BrennenJohnston/custom-braille-embosser-v2/MakerWorld_Photos/Real_Photos/06_all_parts.jpg

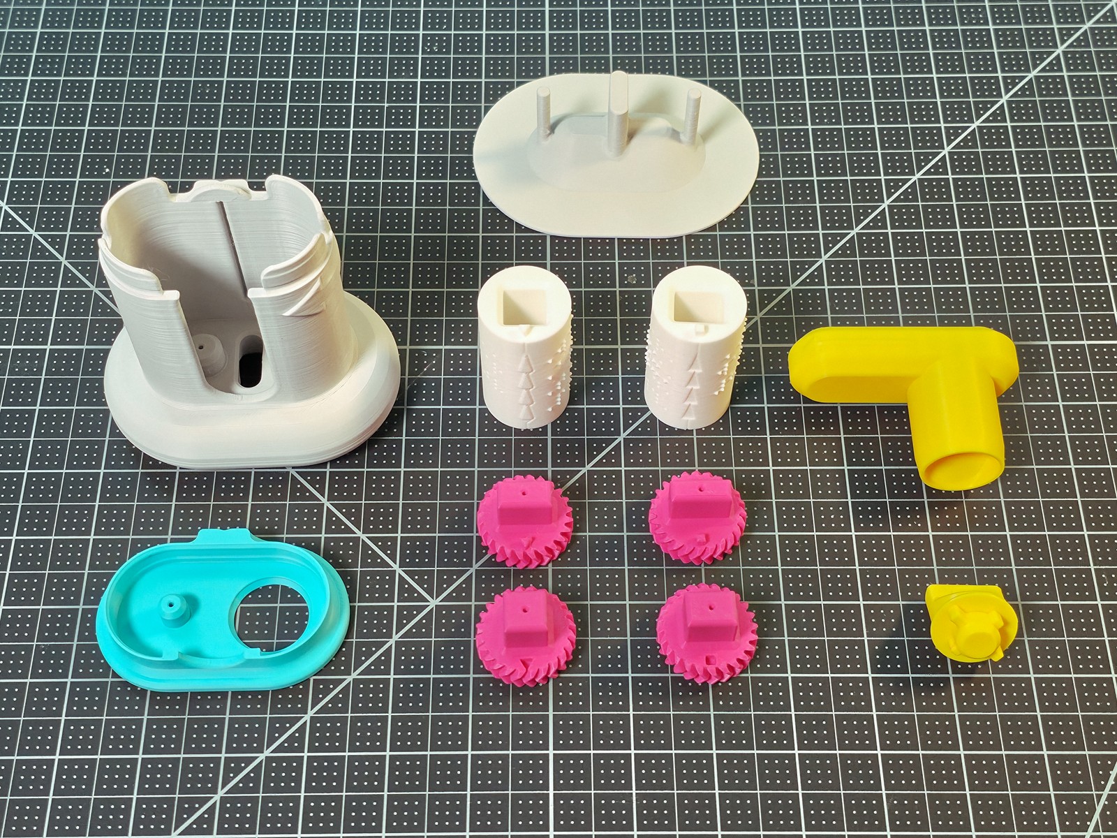
MakerWorld_Photos/Real_Photos/06_all_parts.jpg
