BrennenJohnston/custom-braille-embosser-v2/Build_Files/3D_Printing_Files/Assembly_Reference/Braille_Embosser_V2_Assembled_Example.stl

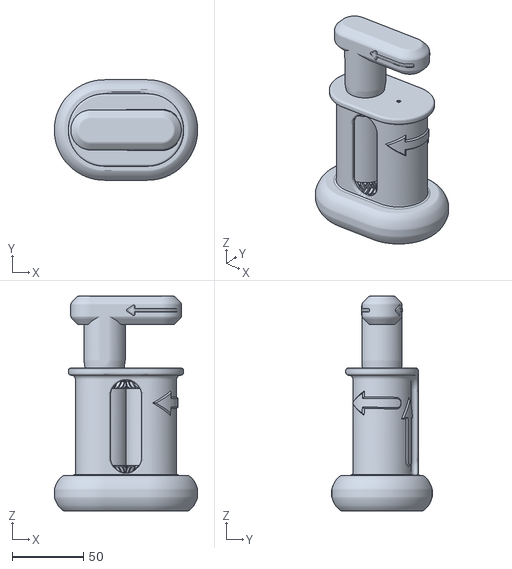
[picture p5: CAD file, 2026-10-19]
Build_Files/3D_Printing_Files/Assembly_Reference/Braille_Embosser_V2_Assembled_Example.stl
100.3 x 70.3 x 150.5
