BrennenJohnston/custom-braille-embosser-v2/Build_Files/3D_Printing_Files/Print_Profiles/X1C/Custom_Braille_Embosser_V2_Tactile_Assembly_Map_X1C.3mf

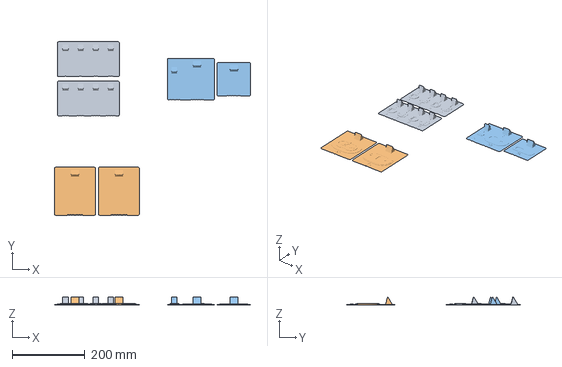
[picture p6: CAD file, 2026-11-07]
Build_Files/3D_Printing_Files/Print_Profiles/X1C/Custom_Braille_Embosser_V2_Tactile_Assembly_Map_X1C.3mf
537.2 x 475.6 x 21.0 mm
Assembly x 3
