BrennenJohnston/custom-braille-embosser-v2/Build_Files/3D_Printing_Files/Tactile_Assembly_Map/STL/Tactile_Assembly_Map_Plate_4_Handle.stl

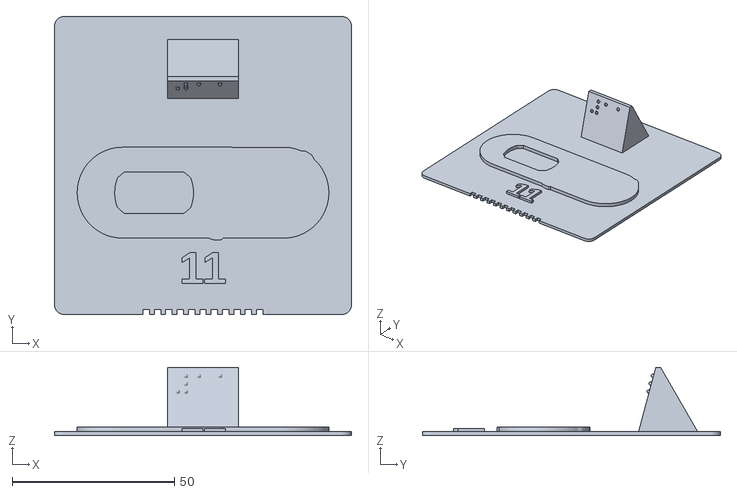
[picture p7: CAD file, 2026-10-19]
Build_Files/3D_Printing_Files/Tactile_Assembly_Map/STL/Tactile_Assembly_Map_Plate_4_Handle.stl
91.5 x 91.7 x 21.0
