BrennenJohnston/custom-braille-embosser-v2/Build_Files/3D_Printing_Files/Print_Profiles/X1C/Custom_Braille_Embosser_V2_Assembly_X1C.3mf

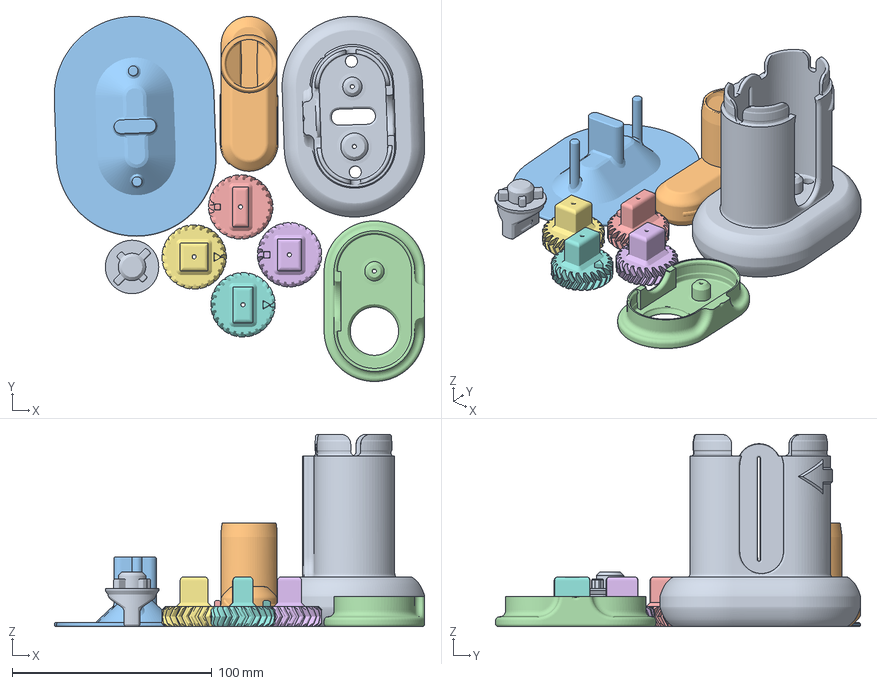
[picture p8: CAD file, 2026-10-19]
Build_Files/3D_Printing_Files/Print_Profiles/X1C/Custom_Braille_Embosser_V2_Assembly_X1C.3mf
185.4 x 182.7 x 96.3 mm
Base.stl
Handle.stl
Push-out_Plate_(optional).stl
Lid.stl
Bottom_Gear_B.stl
Top_Gear_B.stl
Top_Gear_A.stl
Bottom_Gear_A.stl
Knob.stl
