BrennenJohnston/custom-braille-embosser-v2/Build_Files/3D_Printing_Files/Tactile_Assembly_Map/STL/Tactile_Assembly_Map_Plate_3_Knob_Lid.stl

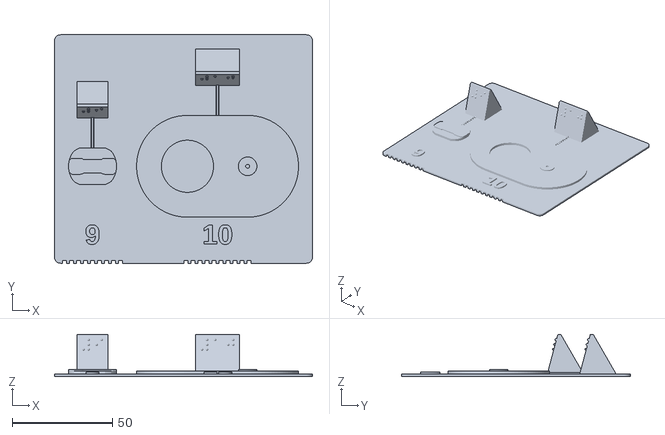
[picture p9: CAD file, 2026-10-19]
Build_Files/3D_Printing_Files/Tactile_Assembly_Map/STL/Tactile_Assembly_Map_Plate_3_Knob_Lid.stl
128.8 x 114.0 x 21.0
