BrennenJohnston/custom-braille-embosser-v2/Build_Files/3D_Printing_Files/Tactile_Assembly_Map/STL/Tactile_Assembly_Map_Plate_1_Roller_A.stl

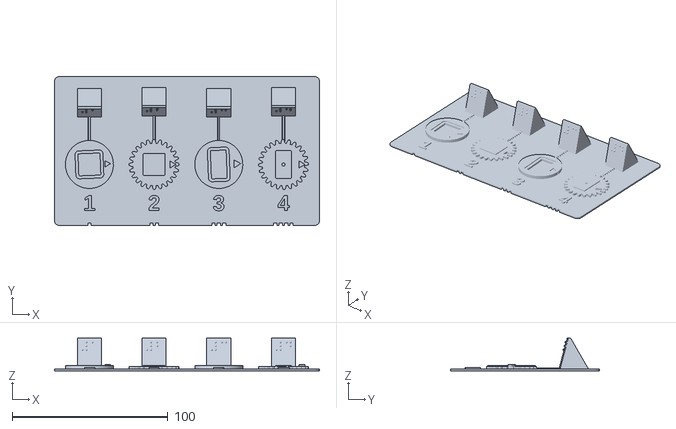
[picture p10: CAD file, 2026-10-19]
Build_Files/3D_Printing_Files/Tactile_Assembly_Map/STL/Tactile_Assembly_Map_Plate_1_Roller_A.stl
169.9 x 95.4 x 21.0
