BrennenJohnston/custom-braille-embosser-v2/Build_Files/3D_Printing_Files/Embossing_Plates_Examples/Cylinder_Pair_V2_0.4_Washington.stl

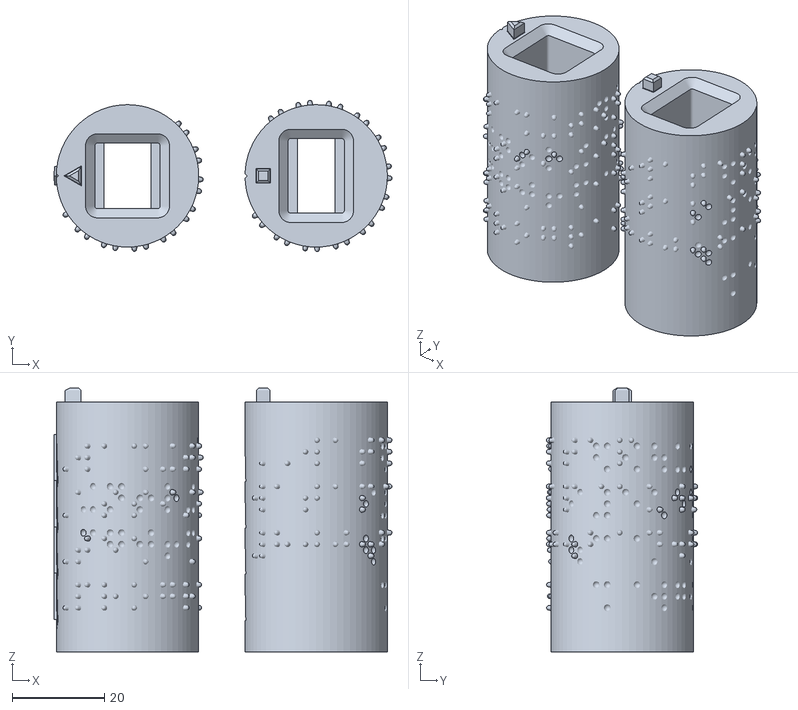
[picture p12: CAD file, 2026-10-19]
Build_Files/3D_Printing_Files/Embossing_Plates_Examples/Cylinder_Pair_V2_0.4_Washington.stl
73.1 x 32.7 x 57.0
