BrennenJohnston/custom-braille-embosser-v2/Build_Files/3D_Printing_Files/STL/Top_Gear_A.stl

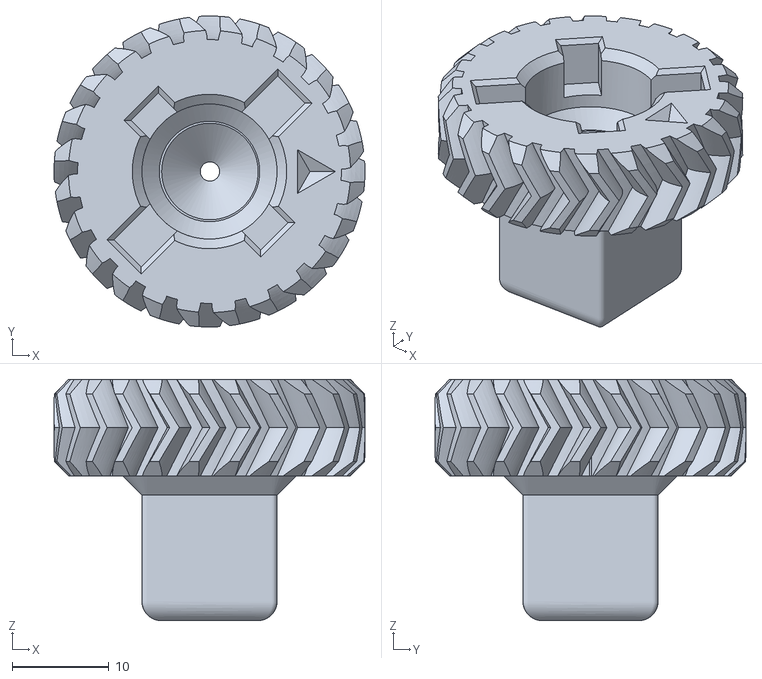
[picture p13: CAD file, 2026-10-19]
Build_Files/3D_Printing_Files/STL/Top_Gear_A.stl
32.2 x 32.2 x 25.0
