BrennenJohnston/custom-braille-embosser-v2/Build_Files/3D_Printing_Files/Embossing_Plates_Customizer/OpenSCAD_Offline_Alternative/assets/v2_gears_b.stl

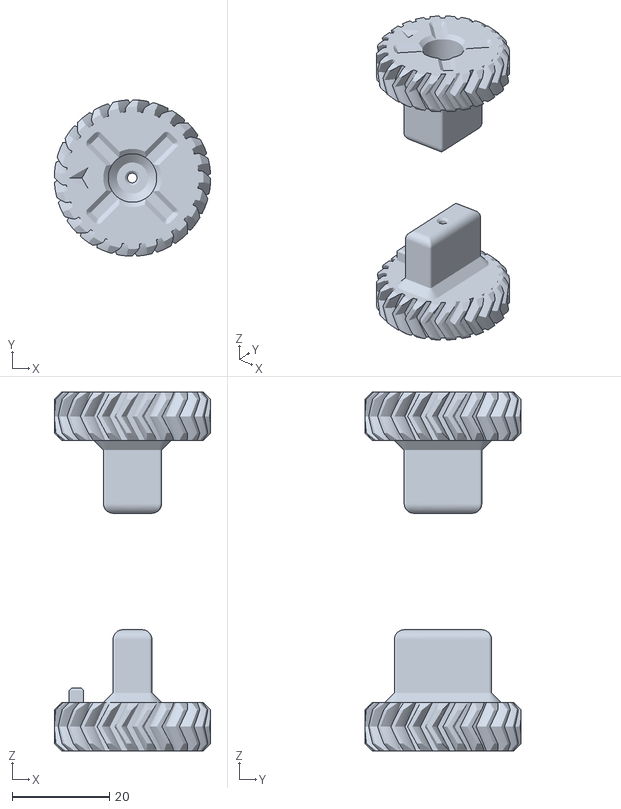
[picture p14: CAD file, 2026-10-19]
Build_Files/3D_Printing_Files/Embossing_Plates_Customizer/OpenSCAD_Offline_Alternative/assets/v2_gears_b.stl
32.2 x 32.2 x 74.0
