BrennenJohnston/custom-braille-embosser-v2/Build_Files/3D_Printing_Files/STL/Push-out_Plate_(optional).stl

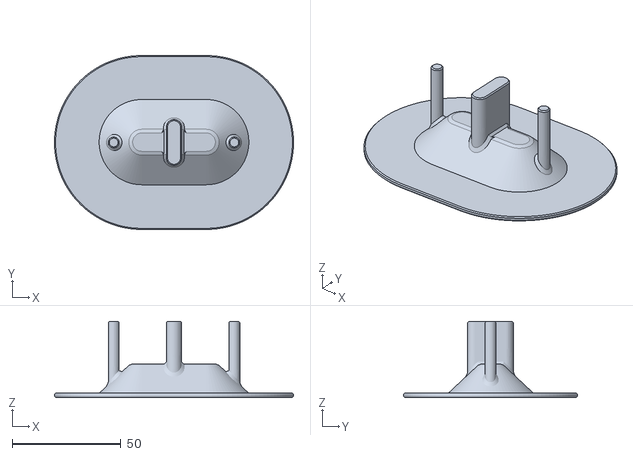
[picture p16: CAD file, 2026-10-19]
Build_Files/3D_Printing_Files/STL/Push-out_Plate_(optional).stl
110.0 x 80.0 x 35.0
