BrennenJohnston/custom-braille-embosser-v2/Build_Files/3D_Printing_Files/Print_Profiles/X1C/Custom_Braille_Embosser_V2_Cylinders_X1C.3mf

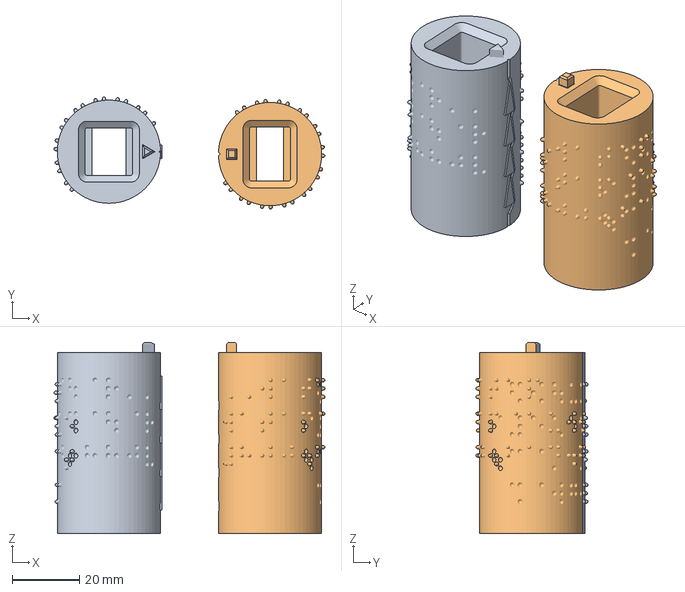
[picture p17: CAD file, 2026-10-19]
Build_Files/3D_Printing_Files/Print_Profiles/X1C/Custom_Braille_Embosser_V2_Cylinders_X1C.3mf
80.8 x 33.4 x 57.0 mm
Cylinder_Pair_V2_0.4_Washington.stl_1
Cylinder_Pair_V2_0.4_Washington.stl_2
