BrennenJohnston/custom-braille-embosser-v2/Build_Files/3D_Printing_Files/STL/Handle.stl

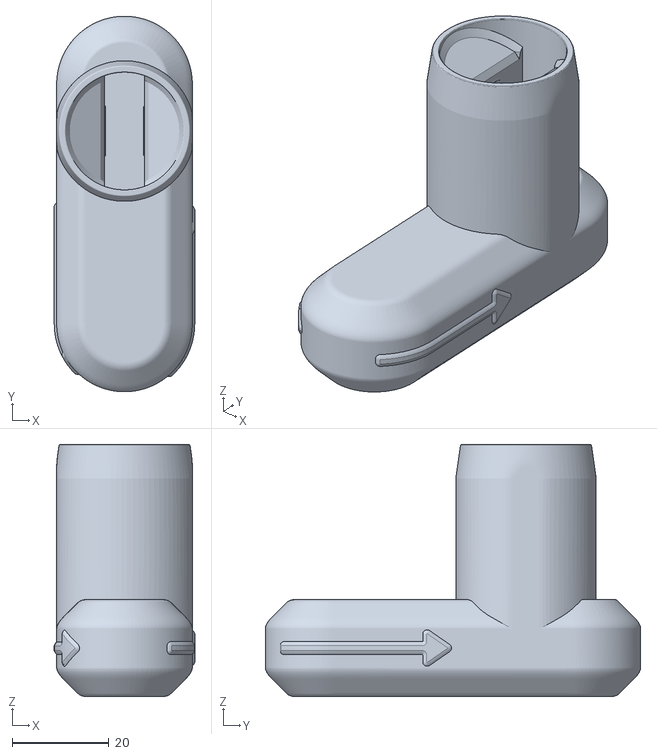
[picture p18: CAD file, 2026-10-19]
Build_Files/3D_Printing_Files/STL/Handle.stl
29.0 x 77.5 x 52.0
