BrennenJohnston/custom-braille-embosser-v2/Build_Files/3D_Printing_Files/STL/Knob.stl

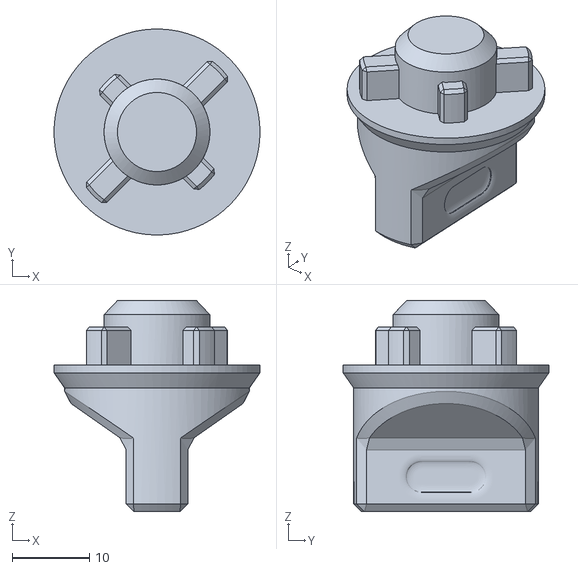
[picture p19: CAD file, 2026-10-19]
Build_Files/3D_Printing_Files/STL/Knob.stl
26.8 x 26.7 x 27.4
