BrennenJohnston/custom-braille-embosser-v2/Build_Files/3D_Printing_Files/STL/Lid.stl

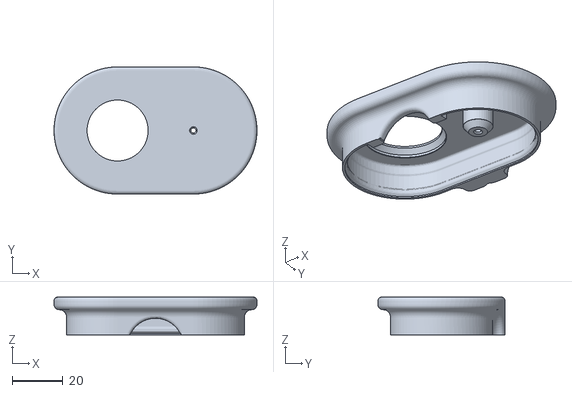
[picture p21: CAD file, 2026-10-19]
Build_Files/3D_Printing_Files/STL/Lid.stl
80.3 x 50.3 x 15.0
