BrennenJohnston/custom-braille-embosser-v2/Build_Files/3D_Printing_Files/STL/Base.stl

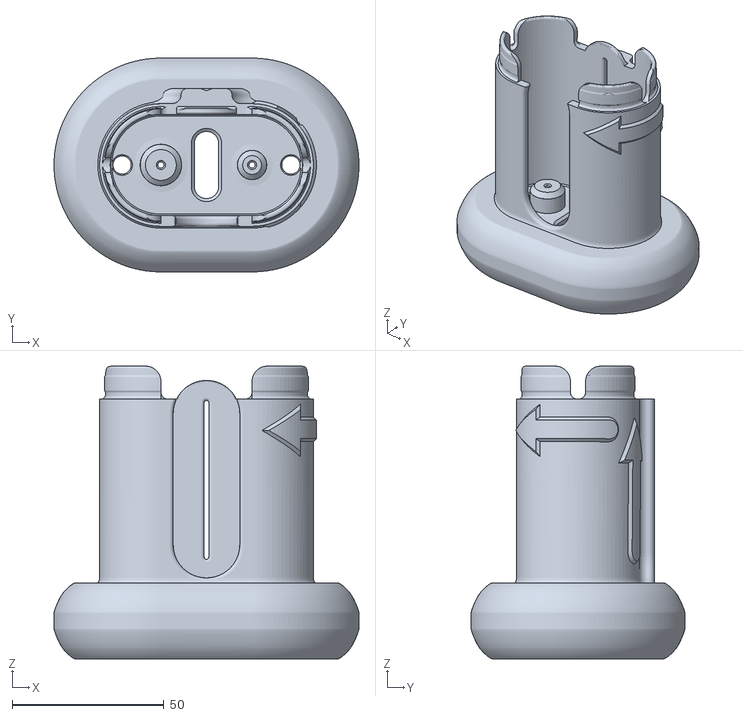
[picture p23: CAD file, 2026-10-19]
Build_Files/3D_Printing_Files/STL/Base.stl
100.3 x 70.3 x 96.3
