BrennenJohnston/custom-braille-embosser-v2/Build_Files/3D_Printing_Files/Tactile_Assembly_Map/Custom_Braille_Embosser_V2_Tactile_Assembly_Map_MakerWorld.scad

// Custom Braille Embosser, Version 2: the tactile assembly map,
// single-file copy for the MakerWorld customizer.
//
// Flat plates that carry the outline of every mating face of the embosser,
// true to size, as a map you read by touch before you build: each keyhole,
// peg, bump, dent, notch and stud, drawn as seen from above the assembled
// embosser, so a peg's shape lies exactly over the hole it enters. Every
// shape rises from the plate in equal steps (level_step_mm): its first level
// stands two steps up, each thing on that face one step more, at most four
// steps a shape; a sunk feature is one step lower than the face around it.
// Each shape has a raised numeral beside it and the same count cut as
// notches in the plate's near edge; with braille labels on, its number in
// braille stands above it on a sloped face that looks toward you, joined to
// the shape by a raised line one step tall. The key document says what each
// number is:
// Documentation/Step_2_Guide_Option_4_Custom_Braille_Embosser_V2_Tactile_Assembly_Map_Key.md
//
// MakerWorld's Parametric Model Maker takes one file and no local include,
// so the outlines, cut from the part files themselves, are written into
// this copy under [Hidden], and it opens on Plate 1. Never edit this copy:
// scripts/tactile_assembly_map_makerworld.py writes it from
// Custom_Braille_Embosser_V2_Tactile_Assembly_Map.scad and
// tactile_assembly_map_shapes.scad; change those and rerun it.
//
// Printing: 0.2 mm layers (0.1 mm over the braille reads smoother), any
// rigid filament, no supports, the plate flat on the bed. The numerals and
// notches face you when the plate's long edge with the notches is nearest
// you; the braille faces you too.
//
// License: CERN-OHL-W v2 (the embosser's hardware license).

/* [Which plate] */
// 0 shows every plate side by side (preview only); 1 to 6 export one plate
plate = 1; // [0:All plates (preview), 1:Plate 1 - Roller A, 2:Plate 2 - Roller B, 3:Plate 3 - Knob and Lid, 4:Plate 4 - Handle, 5:Plate 5 - Base from above, 6:Plate 6 - Base from below]

/* [Plate] */
// Plate thickness in mm; 1.2 mm is the thinnest that prints well
plate_thickness_mm = 1.2; // [1.2:0.1:2.0]
// Height of one step between levels, mm; 0.5 mm is the least a finger finds, 1 mm the guidelines' recommended height
level_step_mm = 0.75; // [0.5:0.25:1.0]
// Room between two shapes, mm (at least 5 mm so separate features read apart)
shape_gap_mm = 10; // [6:1:16]
// Room between a shape and the plate's edge, mm
plate_margin_mm = 7; // [5:1:12]
// Corner radius of the plate, mm
plate_corner_mm = 3;

/* [Labels] */
// Height of the raised numerals above the plate, mm; 1.0 mm is the standard
numeral_height_mm = 1.0; // [0.5:0.5:1.5]
// Numeral size (cap height), mm
numeral_size_mm = 10; // [8:1:14]
// Edge notch width, depth and pitch, mm
notch_width_mm = 2.0;
notch_depth_mm = 1.5;
notch_pitch_mm = 3.5;

/* [Braille labels] */
// Each shape's number in braille on a sloped face above it, facing you; off for a reader who does not read braille
braille_labels = true;
// Room between a shape's top and the foot of its braille block, mm: a finger's width, so a hand reading the block does not land on the shape (the guidelines' 3 to 6 mm is for flat labels)
label_gap_mm = 15; // [3:1:30]
// Sloped face below the braille, mm: lifts the cells so a fingertip reading them rests on the block, not on the plate
braille_foot_mm = 12; // [2:1:20]
// Width of the raised line from a braille label down to its shape, mm
trace_width_mm = 1.2; // [1:0.1:2]
// How much wider the line's foot is than the line, each side, mm; 0 is straight sides
trace_flare_mm = 0.5; // [0:0.1:1]

/* [Hidden] */
// Generated by scripts/derive_tactile_assembly_map.py from the part files. Do not edit; rerun the script.
TACTILE_STEP_MM = 0.5;
// faces: [number, name, size [w, h], offset to centre, [[height, [[points, paths], ...]], ...]]
tactile_faces = [
  [1, "Cylinder A, top end", [30.77, 30.77], [29.743, 0.454], [
    [0.5, [[[[-42.886,7.568],[-42.031,8.826],[-41.062,9.986],[-39.985,11.045],[-38.808,11.994],[-37.544,12.823],[-36.205,13.524],[-34.804,14.09],[-33.354,14.516],[-31.87,14.798],[-30.364,14.933],[-28.853,14.92],[-27.351,14.759],[-25.871,14.452],[-24.428,14.001],[-23.037,13.41],[-21.711,12.686],[-20.461,11.836],[-19.301,10.867],[-18.242,9.789],[-17.293,8.613],[-16.464,7.349],[-15.764,6.01],[-15.197,4.609],[-14.771,3.159],[-14.489,1.674],[-14.396,0.644],[-14.853,0.149],[-14.358,-0.308],[-14.367,-1.342],[-14.528,-2.845],[-14.835,-4.324],[-15.287,-5.767],[-15.877,-7.158],[-16.601,-8.485],[-17.451,-9.734],[-18.42,-10.894],[-19.498,-11.953],[-20.674,-12.902],[-21.938,-13.731],[-23.277,-14.432],[-24.678,-14.998],[-26.128,-15.424],[-27.613,-15.706],[-29.118,-15.841],[-30.629,-15.828],[-32.132,-15.667],[-33.611,-15.36],[-35.054,-14.909],[-36.445,-14.318],[-37.772,-13.594],[-39.021,-12.744],[-40.181,-11.775],[-41.24,-10.698],[-42.189,-9.521],[-43.018,-8.257],[-43.719,-6.918],[-44.285,-5.517],[-44.711,-4.067],[-44.993,-2.583],[-45.129,-1.077],[-45.116,0.434],[-44.954,1.937],[-44.647,3.416],[-44.196,4.859],[-43.605,6.25],[-22.411,-6.74],[-22.935,6.327],[-22.988,6.545],[-23.12,6.726],[-23.311,6.843],[-23.533,6.878],[-36.522,6.352],[-36.74,6.299],[-36.922,6.167],[-37.039,5.976],[-37.073,5.754],[-36.547,-7.235],[-36.495,-7.453],[-36.363,-7.635],[-36.171,-7.752],[-35.949,-7.786],[-22.96,-7.26],[-22.742,-7.208],[-22.587,-7.102],[-22.474,-6.953]], [[0,1,2,3,4,5,6,7,8,9,10,11,12,13,14,15,16,17,18,19,20,21,22,23,24,25,26,27,28,29,30,31,32,33,34,35,36,37,38,39,40,41,42,43,44,45,46,47,48,49,50,51,52,53,54,55,56,57,58,59,60,61,62,63,64,65],[66,67,68,69,70,71,72,73,74,75,76,77,78,79,80,81,82,83,84,85]]]]],
    [1.0, [[[[-42.886,7.568],[-42.031,8.826],[-41.062,9.986],[-39.985,11.045],[-38.808,11.994],[-37.544,12.823],[-36.205,13.524],[-34.804,14.09],[-33.354,14.516],[-31.87,14.798],[-30.364,14.933],[-28.853,14.92],[-27.351,14.759],[-25.871,14.452],[-24.428,14.001],[-23.037,13.41],[-21.711,12.686],[-20.461,11.836],[-19.301,10.867],[-18.242,9.789],[-17.293,8.613],[-16.464,7.349],[-15.764,6.01],[-15.197,4.609],[-14.771,3.159],[-14.489,1.674],[-14.396,0.644],[-14.853,0.149],[-14.358,-0.308],[-14.367,-1.342],[-14.528,-2.845],[-14.835,-4.324],[-15.287,-5.767],[-15.877,-7.158],[-16.601,-8.485],[-17.451,-9.734],[-18.42,-10.894],[-19.498,-11.953],[-20.674,-12.902],[-21.938,-13.731],[-23.277,-14.432],[-24.678,-14.998],[-26.128,-15.424],[-27.613,-15.706],[-29.118,-15.841],[-30.629,-15.828],[-32.132,-15.667],[-33.611,-15.36],[-35.054,-14.909],[-36.445,-14.318],[-37.772,-13.594],[-39.021,-12.744],[-40.181,-11.775],[-41.24,-10.698],[-42.189,-9.521],[-43.018,-8.257],[-43.719,-6.918],[-44.285,-5.517],[-44.711,-4.067],[-44.993,-2.583],[-45.129,-1.077],[-45.116,0.434],[-44.954,1.937],[-44.647,3.416],[-44.196,4.859],[-43.605,6.25],[-22.405,-9.092],[-22.094,-8.995],[-21.66,-8.777],[-21.398,-8.587],[-21.058,-8.241],[-20.871,-7.975],[-20.66,-7.539],[-20.538,-7.07],[-20.509,-6.747],[-21.048,6.565],[-21.146,7.039],[-21.263,7.343],[-21.418,7.627],[-21.716,8.01],[-21.954,8.229],[-22.217,8.415],[-22.656,8.627],[-23.125,8.749],[-23.61,8.777],[-36.761,8.239],[-37.234,8.141],[-37.538,8.024],[-37.822,7.869],[-38.205,7.571],[-38.522,7.204],[-38.691,6.927],[-38.822,6.631],[-38.944,6.162],[-38.972,5.677],[-38.434,-7.474],[-38.336,-7.947],[-38.219,-8.251],[-37.974,-8.667],[-37.766,-8.918],[-37.399,-9.235],[-36.977,-9.474],[-36.516,-9.626],[-36.035,-9.686],[-22.883,-9.159]], [[0,1,2,3,4,5,6,7,8,9,10,11,12,13,14,15,16,17,18,19,20,21,22,23,24,25,26,27,28,29,30,31,32,33,34,35,36,37,38,39,40,41,42,43,44,45,46,47,48,49,50,51,52,53,54,55,56,57,58,59,60,61,62,63,64,65],[66,67,68,69,70,71,72,73,74,75,76,77,78,79,80,81,82,83,84,85,86,87,88,89,90,91,92,93,94,95,96,97,98,99,100,101,102,103,104]]]]],
    [1.5, [[[[-16.205,0.094],[-19.777,1.968],[-19.614,-2.062],[-18.037,-1.065]], [[0,1,2,3]]]]]
  ]],
  [2, "Top Gear A, peg side", [32.2, 32.19], [30.002, -0.0], [
    [0.5, [[[[-43.499,-6.76],[-42.966,-6.215],[-42.56,-5.93],[-42.337,-5.825],[-42.674,-5.088],[-42.792,-4.743],[-43.239,-4.881],[-43.936,-4.933],[-44.77,-4.862],[-45.381,-4.742],[-45.652,-3.751],[-45.004,-3.196],[-44.366,-2.768],[-43.894,-2.546],[-43.424,-2.432],[-43.558,-1.633],[-43.584,-1.269],[-44.051,-1.286],[-44.738,-1.157],[-45.525,-0.872],[-45.915,-0.691],[-46.084,-0.598],[-46.103,0.111],[-46.09,0.429],[-45.32,0.798],[-44.824,0.976],[-44.336,1.103],[-43.842,1.147],[-43.596,1.126],[-43.519,1.933],[-43.449,2.291],[-43.905,2.395],[-44.535,2.698],[-45.221,3.177],[-45.551,3.453],[-45.691,3.587],[-45.526,4.276],[-45.43,4.58],[-44.591,4.737],[-44.066,4.781],[-43.562,4.777],[-43.073,4.692],[-42.841,4.608],[-42.558,5.368],[-42.398,5.696],[-42.811,5.914],[-43.043,6.091],[-43.494,6.535],[-43.88,7.009],[-44.228,7.527],[-44.142,7.697],[-43.719,8.419],[-42.868,8.354],[-42.114,8.205],[-41.623,8.028],[-41.211,7.776],[-40.74,8.436],[-40.501,8.712],[-40.844,9.03],[-41.238,9.607],[-41.593,10.364],[-41.794,10.954],[-41.072,11.684],[-40.267,11.401],[-39.578,11.062],[-39.149,10.764],[-38.816,10.414],[-38.191,10.93],[-37.888,11.134],[-38.137,11.53],[-38.368,12.189],[-38.515,13.013],[-38.553,13.441],[-38.557,13.635],[-37.953,14.006],[-37.67,14.153],[-36.967,13.671],[-36.564,13.33],[-36.21,12.971],[-35.925,12.565],[-35.82,12.342],[-35.083,12.679],[-34.738,12.797],[-34.876,13.244],[-34.914,13.533],[-34.919,14.166],[-34.857,14.775],[-34.737,15.386],[-34.555,15.446],[-33.746,15.657],[-33.191,15.009],[-32.763,14.371],[-32.541,13.899],[-32.427,13.429],[-31.628,13.563],[-31.264,13.589],[-31.281,14.056],[-31.152,14.743],[-30.867,15.53],[-30.593,16.089],[-29.566,16.095],[-29.197,15.325],[-28.949,14.598],[-28.857,14.085],[-28.869,13.601],[-28.062,13.524],[-27.704,13.454],[-27.6,13.91],[-27.297,14.54],[-26.818,15.226],[-26.542,15.556],[-26.408,15.696],[-25.719,15.531],[-25.415,15.435],[-25.258,14.596],[-25.214,14.071],[-25.218,13.567],[-25.303,13.078],[-25.387,12.846],[-24.627,12.563],[-24.299,12.403],[-24.081,12.816],[-23.904,13.048],[-23.46,13.499],[-22.986,13.885],[-22.468,14.233],[-22.298,14.147],[-21.576,13.724],[-21.641,12.873],[-21.79,12.119],[-21.967,11.628],[-22.219,11.216],[-21.559,10.745],[-21.283,10.506],[-20.965,10.849],[-20.388,11.243],[-19.631,11.598],[-19.041,11.799],[-18.311,11.077],[-18.594,10.272],[-18.933,9.583],[-19.231,9.154],[-19.581,8.821],[-19.065,8.196],[-18.861,7.893],[-18.465,8.142],[-17.806,8.373],[-16.982,8.52],[-16.554,8.558],[-16.36,8.562],[-15.989,7.958],[-15.842,7.675],[-16.324,6.972],[-16.665,6.569],[-17.024,6.215],[-17.43,5.93],[-17.653,5.825],[-17.316,5.088],[-17.198,4.743],[-16.751,4.881],[-16.462,4.919],[-15.829,4.924],[-15.22,4.862],[-14.609,4.742],[-14.549,4.56],[-14.338,3.751],[-14.986,3.196],[-15.624,2.768],[-16.096,2.546],[-16.566,2.432],[-16.398,1.269],[-15.939,1.286],[-15.252,1.157],[-14.465,0.872],[-13.906,0.598],[-13.9,-0.429],[-14.67,-0.798],[-15.397,-1.046],[-15.91,-1.138],[-16.394,-1.126],[-16.471,-1.933],[-16.541,-2.291],[-16.085,-2.395],[-15.455,-2.698],[-14.769,-3.177],[-14.439,-3.453],[-14.299,-3.587],[-14.464,-4.276],[-14.56,-4.58],[-15.399,-4.737],[-15.924,-4.781],[-16.428,-4.777],[-16.917,-4.692],[-17.149,-4.608],[-17.432,-5.368],[-17.592,-5.696],[-17.179,-5.914],[-16.947,-6.091],[-16.496,-6.535],[-16.11,-7.009],[-15.762,-7.527],[-15.848,-7.697],[-16.271,-8.419],[-17.122,-8.354],[-17.876,-8.205],[-18.367,-8.028],[-18.779,-7.776],[-19.25,-8.436],[-19.489,-8.712],[-19.146,-9.03],[-18.752,-9.607],[-18.397,-10.364],[-18.196,-10.954],[-18.918,-11.684],[-19.723,-11.401],[-20.412,-11.062],[-20.841,-10.764],[-21.174,-10.414],[-21.799,-10.93],[-22.102,-11.134],[-21.853,-11.53],[-21.622,-12.189],[-21.475,-13.013],[-21.437,-13.441],[-21.433,-13.635],[-22.037,-14.006],[-22.32,-14.153],[-23.023,-13.671],[-23.426,-13.33],[-23.78,-12.971],[-24.065,-12.565],[-24.17,-12.342],[-24.907,-12.679],[-25.252,-12.797],[-25.114,-13.244],[-25.076,-13.533],[-25.071,-14.166],[-25.133,-14.775],[-25.253,-15.386],[-25.435,-15.446],[-26.244,-15.657],[-26.799,-15.009],[-27.227,-14.371],[-27.449,-13.899],[-27.563,-13.429],[-28.362,-13.563],[-28.726,-13.589],[-28.709,-14.056],[-28.838,-14.743],[-29.123,-15.53],[-29.397,-16.089],[-30.424,-16.095],[-30.793,-15.325],[-31.041,-14.598],[-31.133,-14.085],[-31.121,-13.601],[-31.928,-13.524],[-32.286,-13.454],[-32.39,-13.91],[-32.693,-14.54],[-33.172,-15.226],[-33.582,-15.696],[-34.575,-15.435],[-34.732,-14.596],[-34.783,-13.83],[-34.74,-13.31],[-34.603,-12.846],[-35.363,-12.563],[-35.691,-12.403],[-35.909,-12.816],[-36.365,-13.346],[-37.004,-13.885],[-37.522,-14.233],[-38.414,-13.724],[-38.349,-12.873],[-38.2,-12.119],[-38.023,-11.628],[-37.771,-11.216],[-38.431,-10.745],[-38.707,-10.506],[-39.025,-10.849],[-39.602,-11.243],[-40.359,-11.598],[-40.763,-11.746],[-40.949,-11.799],[-41.371,-11.403],[-41.679,-11.077],[-41.506,-10.54],[-41.29,-10.025],[-40.984,-9.467],[-40.759,-9.154],[-40.409,-8.821],[-40.925,-8.196],[-41.129,-7.893],[-41.525,-8.142],[-42.184,-8.373],[-43.008,-8.52],[-43.63,-8.562],[-44.148,-7.675],[-43.842,-7.201],[-15.905,0.106],[-19.937,2.222],[-19.753,-2.328]], [[0,1,2,3,4,5,6,7,8,9,10,11,12,13,14,15,16,17,18,19,20,21,22,23,24,25,26,27,28,29,30,31,32,33,34,35,36,37,38,39,40,41,42,43,44,45,46,47,48,49,50,51,52,53,54,55,56,57,58,59,60,61,62,63,64,65,66,67,68,69,70,71,72,73,74,75,76,77,78,79,80,81,82,83,84,85,86,87,88,89,90,91,92,93,94,95,96,97,98,99,100,101,102,103,104,105,106,107,108,109,110,111,112,113,114,115,116,117,118,119,120,121,122,123,124,125,126,127,128,129,130,131,132,133,134,135,136,137,138,139,140,141,142,143,144,145,146,147,148,149,150,151,152,153,154,155,156,157,158,159,160,161,162,163,164,165,166,167,168,169,170,171,172,173,174,175,176,177,178,179,180,181,182,183,184,185,186,187,188,189,190,191,192,193,194,195,196,197,198,199,200,201,202,203,204,205,206,207,208,209,210,211,212,213,214,215,216,217,218,219,220,221,222,223,224,225,226,227,228,229,230,231,232,233,234,235,236,237,238,239,240,241,242,243,244,245,246,247,248,249,250,251,252,253,254,255,256,257,258,259,260,261,262,263,264,265,266,267,268,269,270,271,272,273,274,275,276,277,278,279,280,281,282,283,284,285,286,287,288,289,290,291,292,293,294,295,296,297,298,299],[300,301,302]]]]],
    [1.0, [[[[-23.099,-6.798],[-23.012,-6.629],[-22.995,-6.5],[-22.995,6.5],[-23.062,6.75],[-23.141,6.854],[-23.366,6.983],[-23.495,7.0],[-36.495,7.0],[-36.624,6.983],[-36.849,6.854],[-36.928,6.75],[-36.995,6.5],[-36.995,-6.5],[-36.928,-6.75],[-36.849,-6.854],[-36.624,-6.983],[-36.495,-7.0],[-23.495,-7.0],[-23.245,-6.933]], [[0,1,2,3,4,5,6,7,8,9,10,11,12,13,14,15,16,17,18,19]]]]]
  ]],
  [3, "Cylinder A, bottom end", [30.77, 30.77], [29.743, 0.454], [
    [0.5, [[[[-36.205,13.524],[-34.804,14.09],[-33.354,14.516],[-31.87,14.798],[-30.364,14.933],[-28.853,14.92],[-27.351,14.759],[-25.871,14.452],[-24.428,14.001],[-23.037,13.41],[-21.711,12.686],[-20.461,11.836],[-19.301,10.867],[-18.242,9.789],[-17.293,8.613],[-16.464,7.349],[-15.764,6.01],[-15.197,4.609],[-14.771,3.159],[-14.489,1.674],[-14.396,0.644],[-14.853,0.149],[-14.358,-0.308],[-14.367,-1.342],[-14.528,-2.845],[-14.835,-4.324],[-15.287,-5.767],[-15.877,-7.158],[-16.601,-8.485],[-17.451,-9.734],[-18.42,-10.894],[-19.498,-11.953],[-20.674,-12.902],[-21.938,-13.731],[-23.277,-14.432],[-24.678,-14.998],[-26.128,-15.424],[-27.613,-15.706],[-29.118,-15.841],[-30.629,-15.828],[-32.132,-15.667],[-33.611,-15.36],[-35.054,-14.909],[-36.445,-14.318],[-37.772,-13.594],[-39.021,-12.744],[-40.181,-11.775],[-41.24,-10.698],[-42.189,-9.521],[-43.018,-8.257],[-43.719,-6.918],[-44.285,-5.517],[-44.711,-4.067],[-44.993,-2.583],[-45.129,-1.077],[-45.116,0.434],[-44.954,1.937],[-44.647,3.416],[-44.196,4.859],[-43.605,6.25],[-42.882,7.576],[-42.031,8.826],[-41.062,9.986],[-39.985,11.045],[-38.808,11.994],[-37.544,12.823],[-24.34,-8.891],[-25.014,8.244],[-25.103,8.529],[-25.322,8.73],[-25.612,8.796],[-34.605,8.431],[-34.889,8.343],[-35.091,8.124],[-35.156,7.834],[-34.468,-9.153],[-34.379,-9.437],[-34.161,-9.638],[-33.87,-9.704],[-24.878,-9.339],[-24.694,-9.302],[-24.533,-9.207],[-24.41,-9.065]], [[0,1,2,3,4,5,6,7,8,9,10,11,12,13,14,15,16,17,18,19,20,21,22,23,24,25,26,27,28,29,30,31,32,33,34,35,36,37,38,39,40,41,42,43,44,45,46,47,48,49,50,51,52,53,54,55,56,57,58,59,60,61,62,63,64,65],[66,67,68,69,70,71,72,73,74,75,76,77,78,79,80,81,82]]]]],
    [1.0, [[[[-36.205,13.524],[-34.804,14.09],[-33.354,14.516],[-31.87,14.798],[-30.364,14.933],[-28.853,14.92],[-27.351,14.759],[-25.871,14.452],[-24.428,14.001],[-23.037,13.41],[-21.711,12.686],[-20.461,11.836],[-19.301,10.867],[-18.242,9.789],[-17.293,8.613],[-16.464,7.349],[-15.764,6.01],[-15.197,4.609],[-14.771,3.159],[-14.489,1.674],[-14.396,0.644],[-14.853,0.149],[-14.358,-0.308],[-14.367,-1.342],[-14.528,-2.845],[-14.835,-4.324],[-15.287,-5.767],[-15.877,-7.158],[-16.601,-8.485],[-17.451,-9.734],[-18.42,-10.894],[-19.498,-11.953],[-20.674,-12.902],[-21.938,-13.731],[-23.277,-14.432],[-24.678,-14.998],[-26.128,-15.424],[-27.613,-15.706],[-29.118,-15.841],[-30.629,-15.828],[-32.132,-15.667],[-33.611,-15.36],[-35.054,-14.909],[-36.445,-14.318],[-37.772,-13.594],[-39.021,-12.744],[-40.181,-11.775],[-41.24,-10.698],[-42.189,-9.521],[-43.018,-8.257],[-43.719,-6.918],[-44.285,-5.517],[-44.711,-4.067],[-44.993,-2.583],[-45.129,-1.077],[-45.116,0.434],[-44.954,1.937],[-44.647,3.416],[-44.196,4.859],[-43.605,6.25],[-42.882,7.576],[-42.031,8.826],[-41.062,9.986],[-39.985,11.045],[-38.808,11.994],[-37.544,12.823],[-36.037,9.858],[-36.401,9.535],[-36.604,9.283],[-36.773,9.007],[-36.955,8.557],[-37.026,8.241],[-37.056,7.919],[-36.366,-9.229],[-36.332,-9.551],[-36.256,-9.866],[-36.14,-10.168],[-35.985,-10.452],[-35.794,-10.714],[-35.571,-10.949],[-35.182,-11.242],[-34.897,-11.391],[-34.593,-11.503],[-34.278,-11.574],[-33.955,-11.603],[-24.801,-11.238],[-24.479,-11.204],[-24.164,-11.128],[-23.862,-11.011],[-23.578,-10.857],[-23.195,-10.558],[-22.975,-10.32],[-22.789,-10.056],[-22.639,-9.769],[-22.527,-9.465],[-22.456,-9.149],[-22.427,-8.827],[-23.116,8.321],[-23.15,8.643],[-23.226,8.958],[-23.342,9.26],[-23.497,9.544],[-23.688,9.806],[-23.911,10.041],[-24.3,10.334],[-24.585,10.483],[-24.889,10.595],[-25.205,10.666],[-25.527,10.695],[-34.843,10.318],[-35.162,10.263],[-35.471,10.166],[-35.765,10.03],[-19.85,-2.442],[-19.764,-2.478],[-19.673,-2.455],[-15.825,-0.02],[-15.759,0.073],[-15.778,0.187],[-19.868,2.355],[-19.951,2.371],[-20.021,2.346],[-20.087,2.216],[-19.903,-2.334]], [[0,1,2,3,4,5,6,7,8,9,10,11,12,13,14,15,16,17,18,19,20,21,22,23,24,25,26,27,28,29,30,31,32,33,34,35,36,37,38,39,40,41,42,43,44,45,46,47,48,49,50,51,52,53,54,55,56,57,58,59,60,61,62,63,64,65],[66,67,68,69,70,71,72,73,74,75,76,77,78,79,80,81,82,83,84,85,86,87,88,89,90,91,92,93,94,95,96,97,98,99,100,101,102,103,104,105,106,107,108,109,110,111,112],[113,114,115,116,117,118,119,120,121,122,123]]]]]
  ]],
  [4, "Bottom Gear A, peg side", [32.21, 32.21], [30.0, -0.0], [
    [0.5, [[[[-41.283,-10.767],[-41.452,-11.324],[-40.707,-12.031],[-40.123,-11.817],[-39.517,-11.527],[-38.833,-11.066],[-38.494,-10.694],[-37.543,-11.384],[-37.787,-11.808],[-37.934,-12.24],[-38.044,-12.753],[-38.111,-13.32],[-38.131,-13.902],[-37.228,-14.392],[-36.72,-14.034],[-36.209,-13.597],[-35.668,-12.975],[-35.436,-12.527],[-34.339,-12.948],[-34.465,-13.421],[-34.495,-13.876],[-34.469,-14.4],[-34.388,-14.966],[-34.256,-15.533],[-33.256,-15.773],[-32.859,-15.295],[-32.478,-14.741],[-32.117,-14.0],[-32.009,-13.508],[-30.84,-13.63],[-30.839,-14.119],[-30.751,-14.567],[-30.59,-15.066],[-30.365,-15.591],[-30.09,-16.105],[-29.063,-16.078],[-28.803,-15.514],[-28.579,-14.88],[-28.421,-14.071],[-28.444,-13.567],[-27.284,-13.383],[-27.157,-13.855],[-26.955,-14.265],[-26.67,-14.705],[-26.317,-15.154],[-25.919,-15.58],[-24.934,-15.288],[-24.828,-14.675],[-24.776,-14.005],[-24.833,-13.183],[-24.986,-12.702],[-23.912,-12.224],[-23.667,-12.647],[-23.367,-12.991],[-22.978,-13.342],[-22.52,-13.685],[-22.026,-13.993],[-21.4,-13.619],[-21.15,-13.456],[-21.206,-12.837],[-21.329,-12.176],[-21.485,-11.663],[-21.597,-11.396],[-21.869,-10.972],[-20.956,-10.232],[-20.61,-10.577],[-20.23,-10.831],[-19.764,-11.07],[-19.233,-11.283],[-18.676,-11.452],[-17.969,-10.707],[-18.183,-10.123],[-18.473,-9.517],[-18.934,-8.833],[-19.306,-8.494],[-18.616,-7.543],[-18.192,-7.787],[-17.76,-7.934],[-17.247,-8.044],[-16.68,-8.111],[-16.098,-8.131],[-15.608,-7.228],[-15.966,-6.72],[-16.403,-6.209],[-17.025,-5.668],[-17.473,-5.436],[-17.052,-4.339],[-16.579,-4.465],[-16.124,-4.495],[-15.6,-4.469],[-15.034,-4.388],[-14.467,-4.256],[-14.288,-3.549],[-14.227,-3.256],[-14.705,-2.859],[-15.259,-2.478],[-15.732,-2.226],[-16.0,-2.117],[-16.492,-2.009],[-16.37,-0.84],[-15.881,-0.839],[-15.433,-0.751],[-14.934,-0.59],[-14.409,-0.365],[-13.895,-0.09],[-13.922,0.937],[-14.486,1.197],[-15.12,1.421],[-15.929,1.579],[-16.433,1.556],[-16.617,2.716],[-16.145,2.843],[-15.735,3.045],[-15.295,3.33],[-14.846,3.683],[-14.42,4.081],[-14.712,5.066],[-15.325,5.172],[-15.995,5.224],[-16.817,5.167],[-17.298,5.014],[-17.776,6.088],[-17.353,6.333],[-17.009,6.633],[-16.658,7.022],[-16.315,7.48],[-16.007,7.974],[-16.381,8.6],[-16.544,8.85],[-17.163,8.794],[-17.824,8.671],[-18.337,8.515],[-18.604,8.403],[-19.028,8.131],[-19.768,9.044],[-19.423,9.39],[-19.169,9.77],[-18.93,10.236],[-18.717,10.767],[-18.548,11.324],[-19.293,12.031],[-19.877,11.817],[-20.483,11.527],[-21.167,11.066],[-21.506,10.694],[-22.457,11.384],[-22.213,11.808],[-22.066,12.24],[-21.956,12.753],[-21.889,13.32],[-21.869,13.902],[-22.772,14.392],[-23.28,14.034],[-23.791,13.597],[-24.332,12.975],[-24.564,12.527],[-25.661,12.948],[-25.535,13.421],[-25.505,13.876],[-25.531,14.4],[-25.612,14.966],[-25.744,15.533],[-26.451,15.712],[-26.744,15.773],[-27.141,15.295],[-27.522,14.741],[-27.774,14.268],[-27.883,14.0],[-27.991,13.508],[-29.16,13.63],[-29.161,14.119],[-29.249,14.567],[-29.41,15.066],[-29.635,15.591],[-29.91,16.105],[-30.937,16.078],[-31.197,15.514],[-31.421,14.88],[-31.579,14.071],[-31.556,13.567],[-32.716,13.383],[-32.843,13.855],[-33.045,14.265],[-33.33,14.705],[-33.683,15.154],[-34.081,15.58],[-35.066,15.288],[-35.172,14.675],[-35.224,14.005],[-35.167,13.183],[-35.014,12.702],[-36.088,12.224],[-36.333,12.647],[-36.633,12.991],[-37.022,13.342],[-37.48,13.685],[-37.974,13.993],[-38.6,13.619],[-38.85,13.456],[-38.794,12.837],[-38.671,12.176],[-38.515,11.663],[-38.403,11.396],[-38.131,10.972],[-39.044,10.232],[-39.39,10.577],[-39.77,10.831],[-40.236,11.07],[-40.767,11.283],[-41.324,11.452],[-42.031,10.707],[-41.817,10.123],[-41.527,9.517],[-41.066,8.833],[-40.694,8.494],[-41.384,7.543],[-41.808,7.787],[-42.24,7.934],[-42.753,8.044],[-43.32,8.111],[-43.902,8.131],[-44.392,7.228],[-44.034,6.72],[-43.597,6.209],[-42.975,5.668],[-42.527,5.436],[-42.948,4.339],[-43.421,4.465],[-43.876,4.495],[-44.4,4.469],[-44.966,4.388],[-45.533,4.256],[-45.712,3.549],[-45.773,3.256],[-45.295,2.859],[-44.741,2.478],[-44.268,2.226],[-44.0,2.117],[-43.508,2.009],[-43.63,0.84],[-44.119,0.839],[-44.567,0.751],[-45.066,0.59],[-45.591,0.365],[-46.105,0.09],[-46.105,-0.283],[-46.078,-0.937],[-46.029,-0.964],[-45.514,-1.197],[-44.88,-1.421],[-44.071,-1.579],[-43.567,-1.556],[-43.383,-2.716],[-43.855,-2.843],[-44.265,-3.045],[-44.705,-3.33],[-45.154,-3.683],[-45.58,-4.081],[-45.288,-5.066],[-44.675,-5.172],[-44.005,-5.224],[-43.183,-5.167],[-42.702,-5.014],[-42.224,-6.088],[-42.647,-6.333],[-42.991,-6.633],[-43.342,-7.022],[-43.685,-7.48],[-43.993,-7.974],[-43.456,-8.85],[-42.837,-8.794],[-42.176,-8.671],[-41.396,-8.403],[-40.972,-8.131],[-40.232,-9.044],[-40.577,-9.39],[-40.831,-9.77],[-41.07,-10.236]], [[0,1,2,3,4,5,6,7,8,9,10,11,12,13,14,15,16,17,18,19,20,21,22,23,24,25,26,27,28,29,30,31,32,33,34,35,36,37,38,39,40,41,42,43,44,45,46,47,48,49,50,51,52,53,54,55,56,57,58,59,60,61,62,63,64,65,66,67,68,69,70,71,72,73,74,75,76,77,78,79,80,81,82,83,84,85,86,87,88,89,90,91,92,93,94,95,96,97,98,99,100,101,102,103,104,105,106,107,108,109,110,111,112,113,114,115,116,117,118,119,120,121,122,123,124,125,126,127,128,129,130,131,132,133,134,135,136,137,138,139,140,141,142,143,144,145,146,147,148,149,150,151,152,153,154,155,156,157,158,159,160,161,162,163,164,165,166,167,168,169,170,171,172,173,174,175,176,177,178,179,180,181,182,183,184,185,186,187,188,189,190,191,192,193,194,195,196,197,198,199,200,201,202,203,204,205,206,207,208,209,210,211,212,213,214,215,216,217,218,219,220,221,222,223,224,225,226,227,228,229,230,231,232,233,234,235,236,237,238,239,240,241,242,243,244,245,246,247,248,249,250,251,252,253,254,255,256,257,258,259,260,261,262,263,264,265,266,267,268,269,270,271,272,273,274,275,276,277]]]]],
    [1.0, [[[[-25.009,-8.565],[-25.0,8.5],[-25.067,8.75],[-25.25,8.933],[-25.5,9.0],[-34.5,9.0],[-34.75,8.933],[-34.933,8.75],[-35.0,8.5],[-35.0,-8.5],[-34.933,-8.75],[-34.75,-8.933],[-34.5,-9.0],[-25.5,-9.0],[-25.25,-8.933],[-25.146,-8.854],[-25.067,-8.75],[-28.982,-0.241],[-29.084,-0.5],[-29.243,-0.707],[-29.45,-0.866],[-29.691,-0.966],[-29.95,-1.0],[-30.209,-0.966],[-30.45,-0.866],[-30.657,-0.707],[-30.816,-0.5],[-30.916,-0.259],[-30.95,0.0],[-30.916,0.259],[-30.816,0.5],[-30.657,0.707],[-30.45,0.866],[-30.209,0.966],[-29.95,1.0],[-29.691,0.966],[-29.45,0.866],[-29.243,0.707],[-29.084,0.5],[-28.984,0.259],[-28.95,0.0]], [[0,1,2,3,4,5,6,7,8,9,10,11,12,13,14,15,16],[17,18,19,20,21,22,23,24,25,26,27,28,29,30,31,32,33,34,35,36,37,38,39,40]]]]],
    [1.5, [[[[-16.148,-0.0],[-20.091,2.277],[-20.091,-2.277]], [[0,1,2]]]]]
  ]],
  [5, "Cylinder B, top end", [30.78, 30.8], [0.497, -0.028], [
    [0.5, [[[[14.892,0.084],[14.822,-1.444],[14.604,-2.94],[14.24,-4.407],[13.735,-5.831],[13.092,-7.199],[12.318,-8.497],[11.421,-9.713],[10.408,-10.835],[9.291,-11.853],[8.079,-12.756],[6.785,-13.536],[5.42,-14.186],[3.999,-14.698],[2.534,-15.069],[1.039,-15.294],[-0.47,-15.372],[-1.98,-15.302],[-3.475,-15.084],[-4.942,-14.72],[-6.366,-14.214],[-7.734,-13.571],[-9.032,-12.798],[-10.248,-11.9],[-11.37,-10.888],[-12.388,-9.771],[-13.291,-8.559],[-14.071,-7.265],[-14.721,-5.9],[-15.233,-4.478],[-15.604,-3.013],[-15.83,-1.519],[-15.883,-0.486],[-15.407,-0.008],[-15.885,0.467],[-15.837,1.5],[-15.619,2.996],[-15.255,4.462],[-14.749,5.887],[-14.107,7.254],[-13.333,8.552],[-12.435,9.769],[-11.423,10.891],[-10.306,11.908],[-9.094,12.812],[-7.8,13.592],[-6.435,14.241],[-5.014,14.754],[-3.548,15.125],[-2.054,15.35],[-0.545,15.428],[0.965,15.357],[2.46,15.139],[3.927,14.775],[5.351,14.27],[6.719,13.627],[8.017,12.853],[9.233,11.956],[10.356,10.944],[11.373,9.826],[12.276,8.615],[13.056,7.32],[13.706,5.956],[14.219,4.534],[14.589,3.069],[14.815,1.574],[-6.446,-7.834],[-6.242,-8.002],[-5.988,-8.061],[5.012,-8.034],[5.266,-7.974],[5.468,-7.808],[5.556,-7.642],[5.586,-7.457],[5.549,7.542],[5.489,7.797],[5.323,7.998],[5.158,8.086],[4.973,8.116],[-6.027,8.089],[-6.281,8.029],[-6.483,7.863],[-6.571,7.698],[-6.601,7.513],[-6.564,-7.487],[-6.533,-7.672]], [[0,1,2,3,4,5,6,7,8,9,10,11,12,13,14,15,16,17,18,19,20,21,22,23,24,25,26,27,28,29,30,31,32,33,34,35,36,37,38,39,40,41,42,43,44,45,46,47,48,49,50,51,52,53,54,55,56,57,58,59,60,61,62,63,64,65],[66,67,68,69,70,71,72,73,74,75,76,77,78,79,80,81,82,83,84,85]]]]],
    [1.0, [[[[14.892,0.084],[14.822,-1.444],[14.604,-2.94],[14.24,-4.407],[13.735,-5.831],[13.092,-7.199],[12.318,-8.497],[11.421,-9.713],[10.408,-10.835],[9.291,-11.853],[8.079,-12.756],[6.785,-13.536],[5.42,-14.186],[3.999,-14.698],[2.534,-15.069],[1.039,-15.294],[-0.47,-15.372],[-1.98,-15.302],[-3.475,-15.084],[-4.942,-14.72],[-6.366,-14.214],[-7.734,-13.571],[-9.032,-12.798],[-10.248,-11.9],[-11.37,-10.888],[-12.388,-9.771],[-13.291,-8.559],[-14.071,-7.265],[-14.721,-5.9],[-15.233,-4.478],[-15.604,-3.013],[-15.83,-1.519],[-15.883,-0.486],[-15.407,-0.008],[-15.885,0.467],[-15.837,1.5],[-15.619,2.996],[-15.255,4.462],[-14.749,5.887],[-14.107,7.254],[-13.333,8.552],[-12.435,9.769],[-11.423,10.891],[-10.306,11.908],[-9.094,12.812],[-7.8,13.592],[-6.435,14.241],[-5.014,14.754],[-3.548,15.125],[-2.054,15.35],[-0.545,15.428],[0.965,15.357],[2.46,15.139],[3.927,14.775],[5.351,14.27],[6.719,13.627],[8.017,12.853],[9.233,11.956],[10.356,10.944],[11.373,9.826],[12.276,8.615],[13.056,7.32],[13.706,5.956],[14.219,4.534],[14.589,3.069],[14.815,1.574],[-7.779,9.262],[-8.087,8.884],[-8.315,8.456],[-8.454,7.991],[-8.501,7.508],[-8.464,-7.492],[-8.442,-7.815],[-8.331,-8.287],[-8.13,-8.728],[-7.949,-8.997],[-7.735,-9.24],[-7.493,-9.452],[-7.079,-9.708],[-6.779,-9.831],[-6.466,-9.914],[-5.983,-9.961],[5.179,-9.928],[5.499,-9.885],[5.962,-9.744],[6.253,-9.599],[6.522,-9.419],[6.875,-9.086],[7.072,-8.829],[7.233,-8.548],[7.356,-8.249],[7.439,-7.936],[7.486,-7.453],[7.449,7.547],[7.401,8.028],[7.316,8.342],[7.191,8.643],[6.934,9.053],[6.72,9.295],[6.476,9.508],[6.064,9.764],[5.764,9.887],[5.451,9.97],[4.968,10.016],[-6.193,9.984],[-6.514,9.941],[-6.978,9.799],[-7.406,9.569]], [[0,1,2,3,4,5,6,7,8,9,10,11,12,13,14,15,16,17,18,19,20,21,22,23,24,25,26,27,28,29,30,31,32,33,34,35,36,37,38,39,40,41,42,43,44,45,46,47,48,49,50,51,52,53,54,55,56,57,58,59,60,61,62,63,64,65],[66,67,68,69,70,71,72,73,74,75,76,77,78,79,80,81,82,83,84,85,86,87,88,89,90,91,92,93,94,95,96,97,98,99,100,101,102,103,104,105,106,107]]]]],
    [1.5, [[[[-13.461,1.496],[-13.454,-1.504],[-10.454,-1.496],[-10.461,1.504]], [[0,1,2,3]]]]]
  ]],
  [6, "Top Gear B, peg side", [32.09, 32.09], [-0.002, 0.005], [
    [0.5, [[[[-12.603,-10.023],[-13.216,-9.199],[-13.139,-9.027],[-12.933,-8.643],[-12.48,-7.948],[-12.006,-7.427],[-11.621,-7.159],[-11.814,-6.862],[-12.193,-6.134],[-12.636,-6.325],[-13.147,-6.431],[-13.645,-6.472],[-14.204,-6.47],[-14.766,-6.419],[-15.145,-5.464],[-14.728,-5.0],[-14.11,-4.447],[-13.518,-4.066],[-13.077,-3.907],[-13.186,-3.571],[-13.364,-2.768],[-13.841,-2.839],[-14.362,-2.809],[-14.854,-2.72],[-15.393,-2.573],[-15.923,-2.378],[-16.029,-1.553],[-16.042,-1.358],[-15.519,-1.018],[-14.979,-0.733],[-14.39,-0.501],[-14.108,-0.429],[-13.641,-0.389],[-13.659,-0.036],[-13.623,0.785],[-14.008,0.821],[-14.352,0.912],[-15.05,1.218],[-15.533,1.499],[-15.994,1.824],[-15.944,2.267],[-15.845,2.84],[-15.67,2.907],[-15.252,3.034],[-14.441,3.204],[-13.737,3.238],[-13.276,3.155],[-13.202,3.501],[-12.955,4.284],[-13.404,4.463],[-13.84,4.749],[-14.221,5.072],[-14.615,5.468],[-14.976,5.902],[-14.569,6.845],[-13.946,6.879],[-13.118,6.833],[-12.43,6.683],[-12.005,6.484],[-11.845,6.799],[-11.403,7.492],[-11.791,7.78],[-12.138,8.169],[-12.423,8.58],[-12.7,9.065],[-12.937,9.577],[-12.428,10.236],[-12.299,10.383],[-11.689,10.254],[-11.106,10.073],[-10.526,9.821],[-10.275,9.673],[-9.917,9.37],[-9.68,9.633],[-9.074,10.188],[-9.321,10.486],[-9.5,10.793],[-9.777,11.503],[-9.92,12.043],[-10.016,12.6],[-9.667,12.877],[-9.192,13.213],[-9.021,13.136],[-8.636,12.93],[-7.941,12.477],[-7.42,12.003],[-7.152,11.618],[-6.856,11.811],[-6.127,12.19],[-6.318,12.633],[-6.424,13.144],[-6.465,13.642],[-6.464,14.201],[-6.412,14.763],[-5.457,15.142],[-4.993,14.725],[-4.44,14.107],[-4.06,13.515],[-3.9,13.073],[-3.564,13.183],[-2.762,13.361],[-2.832,13.838],[-2.802,14.359],[-2.713,14.851],[-2.567,15.39],[-2.371,15.92],[-1.546,16.026],[-1.351,16.039],[-1.011,15.516],[-0.726,14.976],[-0.494,14.387],[-0.422,14.105],[-0.383,13.638],[-0.029,13.656],[0.792,13.62],[0.828,14.005],[0.918,14.349],[1.224,15.047],[1.505,15.53],[1.831,15.991],[2.274,15.941],[2.847,15.842],[2.914,15.667],[3.041,15.249],[3.211,14.438],[3.245,13.734],[3.162,13.272],[3.508,13.199],[4.291,12.952],[4.469,13.401],[4.756,13.837],[5.079,14.218],[5.475,14.612],[5.909,14.973],[6.852,14.566],[6.885,13.943],[6.84,13.115],[6.69,12.427],[6.49,12.002],[6.806,11.842],[7.499,11.4],[7.787,11.788],[8.176,12.135],[8.587,12.419],[9.071,12.697],[9.584,12.934],[10.243,12.425],[10.39,12.296],[10.261,11.686],[10.08,11.103],[9.828,10.523],[9.68,10.272],[9.377,9.914],[9.64,9.677],[10.195,9.071],[10.493,9.318],[10.8,9.497],[11.51,9.774],[12.05,9.917],[12.606,10.013],[12.884,9.664],[13.219,9.189],[13.143,9.018],[12.937,8.633],[12.484,7.938],[12.01,7.417],[11.625,7.149],[11.817,6.853],[12.197,6.124],[12.64,6.315],[13.151,6.421],[13.649,6.462],[14.207,6.461],[14.77,6.409],[15.149,5.454],[14.732,4.99],[14.114,4.437],[13.522,4.057],[13.08,3.897],[13.19,3.561],[13.367,2.759],[13.845,2.829],[14.366,2.799],[14.858,2.71],[15.397,2.564],[15.927,2.368],[16.033,1.543],[16.045,1.348],[15.523,1.008],[14.982,0.723],[14.394,0.491],[14.112,0.419],[13.645,0.379],[13.663,0.026],[13.627,-0.795],[14.012,-0.831],[14.356,-0.921],[15.054,-1.227],[15.537,-1.508],[15.998,-1.834],[15.948,-2.277],[15.849,-2.85],[15.674,-2.917],[15.256,-3.044],[14.445,-3.214],[13.741,-3.248],[13.279,-3.165],[13.206,-3.511],[12.959,-4.294],[13.408,-4.472],[13.844,-4.759],[14.225,-5.082],[14.618,-5.478],[14.98,-5.912],[14.573,-6.855],[13.95,-6.888],[13.122,-6.843],[12.434,-6.693],[12.009,-6.493],[11.848,-6.809],[11.407,-7.502],[11.795,-7.79],[12.142,-8.179],[12.426,-8.59],[12.704,-9.074],[12.94,-9.587],[12.432,-10.246],[12.303,-10.393],[11.693,-10.264],[11.109,-10.083],[10.53,-9.831],[10.279,-9.683],[9.921,-9.38],[9.684,-9.643],[9.078,-10.198],[9.324,-10.496],[9.504,-10.803],[9.781,-11.513],[9.924,-12.053],[10.02,-12.609],[9.671,-12.887],[9.196,-13.222],[9.024,-13.146],[8.64,-12.94],[7.945,-12.487],[7.424,-12.013],[7.156,-11.628],[6.859,-11.82],[6.131,-12.2],[6.322,-12.643],[6.428,-13.154],[6.469,-13.652],[6.467,-14.21],[6.416,-14.773],[5.461,-15.152],[4.997,-14.735],[4.444,-14.117],[4.063,-13.525],[3.904,-13.083],[3.568,-13.193],[2.765,-13.37],[2.836,-13.848],[2.806,-14.369],[2.717,-14.861],[2.57,-15.4],[2.375,-15.93],[1.55,-16.036],[1.355,-16.048],[1.015,-15.526],[0.73,-14.985],[0.498,-14.397],[0.426,-14.115],[0.386,-13.648],[0.033,-13.666],[-0.788,-13.63],[-0.824,-14.015],[-0.915,-14.359],[-1.221,-15.057],[-1.502,-15.54],[-1.827,-16.001],[-2.27,-15.951],[-2.843,-15.852],[-2.91,-15.677],[-3.037,-15.259],[-3.207,-14.448],[-3.241,-13.744],[-3.158,-13.282],[-3.504,-13.209],[-4.288,-12.962],[-4.466,-13.411],[-4.752,-13.847],[-5.075,-14.228],[-5.471,-14.621],[-5.905,-14.983],[-6.848,-14.576],[-6.882,-13.953],[-6.836,-13.125],[-6.686,-12.437],[-6.487,-12.012],[-6.802,-11.851],[-7.495,-11.41],[-7.783,-11.798],[-8.172,-12.145],[-8.583,-12.429],[-9.068,-12.707],[-9.58,-12.944],[-10.239,-12.435],[-10.386,-12.306],[-10.257,-11.696],[-10.076,-11.112],[-9.824,-10.533],[-9.676,-10.282],[-9.373,-9.924],[-9.636,-9.687],[-10.191,-9.081],[-10.489,-9.327],[-10.796,-9.507],[-11.506,-9.784],[-12.046,-9.927],[-9.8,-1.65],[-9.8,1.65],[-13.1,1.65],[-13.1,-1.65]], [[0,1,2,3,4,5,6,7,8,9,10,11,12,13,14,15,16,17,18,19,20,21,22,23,24,25,26,27,28,29,30,31,32,33,34,35,36,37,38,39,40,41,42,43,44,45,46,47,48,49,50,51,52,53,54,55,56,57,58,59,60,61,62,63,64,65,66,67,68,69,70,71,72,73,74,75,76,77,78,79,80,81,82,83,84,85,86,87,88,89,90,91,92,93,94,95,96,97,98,99,100,101,102,103,104,105,106,107,108,109,110,111,112,113,114,115,116,117,118,119,120,121,122,123,124,125,126,127,128,129,130,131,132,133,134,135,136,137,138,139,140,141,142,143,144,145,146,147,148,149,150,151,152,153,154,155,156,157,158,159,160,161,162,163,164,165,166,167,168,169,170,171,172,173,174,175,176,177,178,179,180,181,182,183,184,185,186,187,188,189,190,191,192,193,194,195,196,197,198,199,200,201,202,203,204,205,206,207,208,209,210,211,212,213,214,215,216,217,218,219,220,221,222,223,224,225,226,227,228,229,230,231,232,233,234,235,236,237,238,239,240,241,242,243,244,245,246,247,248,249,250,251,252,253,254,255,256,257,258,259,260,261,262,263,264,265,266,267,268,269,270,271,272,273,274,275,276,277,278,279,280,281,282,283,284,285,286,287,288,289,290,291,292,293,294,295,296,297,298,299,300,301,302,303,304,305,306,307,308,309,310,311,312,313,314,315,316,317,318],[319,320,321,322]]]]],
    [1.0, [[[[-5.888,-7.811],[-5.748,-7.938],[-5.498,-8.005],[5.502,-8.005],[5.752,-7.938],[5.935,-7.755],[6.002,-7.505],[6.002,7.495],[5.935,7.745],[5.752,7.928],[5.502,7.995],[-5.498,7.995],[-5.748,7.928],[-5.931,7.745],[-5.998,7.495],[-5.998,-7.505],[-5.981,-7.634]], [[0,1,2,3,4,5,6,7,8,9,10,11,12,13,14,15,16]]]]]
  ]],
  [7, "Cylinder B, bottom end", [30.78, 30.8], [0.496, -0.028], [
    [0.5, [[[[-10.269,11.936],[-9.094,12.812],[-7.8,13.592],[-6.435,14.241],[-5.014,14.754],[-3.548,15.125],[-2.054,15.35],[-0.545,15.428],[0.965,15.357],[2.46,15.139],[3.927,14.775],[5.351,14.27],[6.719,13.627],[8.017,12.853],[9.233,11.956],[10.356,10.944],[11.373,9.826],[12.276,8.615],[13.056,7.32],[13.706,5.956],[14.219,4.534],[14.589,3.069],[14.815,1.574],[14.893,0.065],[14.822,-1.444],[14.604,-2.94],[14.24,-4.407],[13.735,-5.831],[13.092,-7.199],[12.318,-8.497],[11.421,-9.713],[10.408,-10.835],[9.291,-11.853],[8.079,-12.756],[6.785,-13.536],[5.42,-14.186],[3.999,-14.698],[2.534,-15.069],[1.039,-15.294],[-0.47,-15.372],[-1.98,-15.302],[-3.475,-15.084],[-4.942,-14.72],[-6.366,-14.214],[-7.734,-13.571],[-9.032,-12.798],[-10.248,-11.9],[-11.37,-10.888],[-12.388,-9.771],[-13.291,-8.559],[-14.071,-7.265],[-14.721,-5.9],[-15.233,-4.478],[-15.604,-3.013],[-15.83,-1.519],[-15.883,-0.486],[-15.407,-0.008],[-15.885,0.467],[-15.837,1.5],[-15.619,2.996],[-15.255,4.462],[-14.749,5.887],[-14.107,7.254],[-13.333,8.552],[-12.435,9.769],[-11.423,10.891],[3.525,9.686],[3.447,9.857],[3.318,9.993],[3.153,10.081],[2.968,10.111],[-4.069,10.093],[-4.252,10.05],[-4.382,9.975],[-4.562,9.738],[-4.605,9.518],[-4.559,-9.482],[-4.528,-9.667],[-4.462,-9.801],[-4.362,-9.914],[-4.203,-10.012],[-3.983,-10.056],[3.055,-10.037],[3.202,-10.008],[3.367,-9.919],[3.547,-9.682],[3.591,-9.462]], [[0,1,2,3,4,5,6,7,8,9,10,11,12,13,14,15,16,17,18,19,20,21,22,23,24,25,26,27,28,29,30,31,32,33,34,35,36,37,38,39,40,41,42,43,44,45,46,47,48,49,50,51,52,53,54,55,56,57,58,59,60,61,62,63,64,65],[66,67,68,69,70,71,72,73,74,75,76,77,78,79,80,81,82,83,84,85,86]]]]],
    [1.0, [[[[-10.269,11.936],[-9.094,12.812],[-7.8,13.592],[-6.435,14.241],[-5.014,14.754],[-3.548,15.125],[-2.054,15.35],[-0.545,15.428],[0.965,15.357],[2.46,15.139],[3.927,14.775],[5.351,14.27],[6.719,13.627],[8.017,12.853],[9.233,11.956],[10.356,10.944],[11.373,9.826],[12.276,8.615],[13.056,7.32],[13.706,5.956],[14.219,4.534],[14.589,3.069],[14.815,1.574],[14.893,0.065],[14.822,-1.444],[14.604,-2.94],[14.24,-4.407],[13.735,-5.831],[13.092,-7.199],[12.318,-8.497],[11.421,-9.713],[10.408,-10.835],[9.291,-11.853],[8.079,-12.756],[6.785,-13.536],[5.42,-14.186],[3.999,-14.698],[2.534,-15.069],[1.039,-15.294],[-0.47,-15.372],[-1.98,-15.302],[-3.475,-15.084],[-4.942,-14.72],[-6.366,-14.214],[-7.734,-13.571],[-9.032,-12.798],[-10.248,-11.9],[-11.37,-10.888],[-12.388,-9.771],[-13.291,-8.559],[-14.071,-7.265],[-14.721,-5.9],[-15.233,-4.478],[-15.604,-3.013],[-15.83,-1.519],[-15.883,-0.486],[-15.407,-0.008],[-15.885,0.467],[-15.837,1.5],[-15.619,2.996],[-15.255,4.462],[-14.749,5.887],[-14.107,7.254],[-13.333,8.552],[-12.435,9.769],[-11.423,10.891],[-10.455,1.609],[-10.561,1.653],[-13.561,1.646],[-13.667,1.602],[-13.711,1.496],[-13.704,-1.504],[-13.66,-1.61],[-13.553,-1.654],[-10.553,-1.647],[-10.447,-1.602],[-10.404,-1.496],[-10.411,1.504],[-4.303,-11.935],[-3.978,-11.956],[3.022,-11.939],[3.504,-11.89],[3.817,-11.805],[4.116,-11.681],[4.396,-11.518],[4.652,-11.321],[4.88,-11.091],[5.077,-10.834],[5.238,-10.553],[5.361,-10.254],[5.444,-9.939],[5.491,-9.458],[5.439,9.704],[5.396,10.025],[5.311,10.337],[5.186,10.638],[4.929,11.048],[4.597,11.401],[4.34,11.597],[4.059,11.759],[3.759,11.882],[3.288,11.991],[2.963,12.011],[-4.036,11.994],[-4.359,11.972],[-4.677,11.908],[-4.983,11.804],[-5.273,11.66],[-5.543,11.478],[-5.895,11.147],[-6.092,10.889],[-6.253,10.609],[-6.376,10.309],[-6.485,9.836],[-6.505,9.513],[-6.454,-9.649],[-6.374,-10.125],[-6.269,-10.433],[-6.125,-10.723],[-5.841,-11.117],[-5.488,-11.447],[-5.217,-11.627],[-4.774,-11.826]], [[0,1,2,3,4,5,6,7,8,9,10,11,12,13,14,15,16,17,18,19,20,21,22,23,24,25,26,27,28,29,30,31,32,33,34,35,36,37,38,39,40,41,42,43,44,45,46,47,48,49,50,51,52,53,54,55,56,57,58,59,60,61,62,63,64,65],[66,67,68,69,70,71,72,73,74,75,76,77],[78,79,80,81,82,83,84,85,86,87,88,89,90,91,92,93,94,95,96,97,98,99,100,101,102,103,104,105,106,107,108,109,110,111,112,113,114,115,116,117,118,119,120,121,122]]]]]
  ]],
  [8, "Bottom Gear B, peg side", [32.14, 32.14], [-0.0, -0.0], [
    [0.5, [[[[8.018,11.648],[7.719,11.265],[6.722,11.887],[6.94,12.34],[7.018,12.618],[7.11,13.141],[7.152,13.819],[7.131,14.44],[6.868,14.57],[6.196,14.865],[5.746,14.502],[5.336,14.109],[4.997,13.718],[4.73,13.326],[4.541,12.879],[3.417,13.221],[3.51,13.716],[3.466,14.533],[3.331,15.199],[3.151,15.794],[2.138,15.962],[1.797,15.495],[1.503,15.009],[1.276,14.544],[1.12,14.096],[1.053,13.615],[-0.122,13.655],[-0.16,14.157],[-0.231,14.437],[-0.413,14.935],[-0.716,15.543],[-1.044,16.071],[-1.337,16.052],[-2.067,15.972],[-2.275,15.432],[-2.433,14.887],[-2.532,14.378],[-2.567,13.906],[-2.507,13.424],[-3.652,13.158],[-3.818,13.633],[-3.96,13.885],[-4.265,14.319],[-4.714,14.828],[-5.168,15.253],[-5.446,15.159],[-6.13,14.893],[-6.191,14.318],[-6.203,13.75],[-6.167,13.233],[-6.078,12.768],[-5.896,12.317],[-6.933,11.765],[-7.217,12.18],[-7.826,12.728],[-8.392,13.103],[-8.94,13.396],[-9.776,12.799],[-9.686,12.227],[-9.55,11.676],[-9.382,11.186],[-9.175,10.759],[-8.883,10.372],[-9.742,9.57],[-10.123,9.897],[-10.853,10.269],[-11.497,10.484],[-12.102,10.626],[-12.696,9.916],[-12.755,9.832],[-12.521,9.304],[-12.247,8.806],[-11.789,8.168],[-11.535,7.916],[-11.265,7.719],[-11.887,6.722],[-12.34,6.94],[-12.618,7.018],[-13.141,7.11],[-13.819,7.152],[-14.44,7.131],[-14.57,6.868],[-14.865,6.196],[-14.502,5.746],[-14.109,5.336],[-13.718,4.997],[-13.326,4.73],[-12.879,4.541],[-13.221,3.417],[-13.716,3.51],[-14.533,3.466],[-15.199,3.331],[-15.794,3.151],[-15.962,2.138],[-15.495,1.797],[-15.009,1.503],[-14.544,1.276],[-14.096,1.12],[-13.615,1.053],[-13.655,-0.122],[-14.157,-0.16],[-14.935,-0.413],[-15.543,-0.716],[-16.071,-1.044],[-15.989,-1.966],[-15.972,-2.067],[-15.432,-2.275],[-14.887,-2.433],[-14.112,-2.56],[-13.754,-2.559],[-13.424,-2.507],[-13.158,-3.652],[-13.633,-3.818],[-13.885,-3.96],[-14.319,-4.265],[-14.828,-4.714],[-15.253,-5.168],[-15.159,-5.446],[-14.893,-6.13],[-14.318,-6.191],[-13.75,-6.203],[-13.233,-6.167],[-12.768,-6.078],[-12.317,-5.896],[-11.765,-6.933],[-12.18,-7.217],[-12.728,-7.826],[-13.103,-8.392],[-13.396,-8.94],[-12.799,-9.776],[-12.227,-9.686],[-11.676,-9.55],[-11.186,-9.382],[-10.759,-9.175],[-10.372,-8.883],[-9.57,-9.742],[-9.897,-10.123],[-10.269,-10.853],[-10.484,-11.497],[-10.626,-12.102],[-9.916,-12.696],[-9.832,-12.755],[-9.304,-12.521],[-8.806,-12.247],[-8.168,-11.789],[-7.916,-11.535],[-7.719,-11.265],[-6.722,-11.887],[-6.94,-12.34],[-7.018,-12.618],[-7.11,-13.141],[-7.152,-13.819],[-7.131,-14.44],[-6.868,-14.57],[-6.196,-14.865],[-5.746,-14.502],[-5.336,-14.109],[-4.997,-13.718],[-4.73,-13.326],[-4.541,-12.879],[-3.417,-13.221],[-3.51,-13.716],[-3.466,-14.533],[-3.331,-15.199],[-3.151,-15.794],[-2.138,-15.962],[-1.797,-15.495],[-1.503,-15.009],[-1.276,-14.544],[-1.12,-14.096],[-1.053,-13.615],[0.122,-13.655],[0.16,-14.157],[0.413,-14.935],[0.716,-15.543],[1.044,-16.071],[1.966,-15.989],[2.067,-15.972],[2.275,-15.432],[2.433,-14.887],[2.56,-14.112],[2.559,-13.754],[2.507,-13.424],[3.652,-13.158],[3.818,-13.633],[3.96,-13.885],[4.265,-14.319],[4.714,-14.828],[5.168,-15.253],[5.446,-15.159],[6.13,-14.893],[6.191,-14.318],[6.203,-13.75],[6.167,-13.233],[6.078,-12.768],[5.896,-12.317],[6.933,-11.765],[7.217,-12.18],[7.826,-12.728],[8.392,-13.103],[8.94,-13.396],[9.776,-12.799],[9.686,-12.227],[9.55,-11.676],[9.382,-11.186],[9.175,-10.759],[8.883,-10.372],[9.742,-9.57],[10.123,-9.897],[10.853,-10.269],[11.497,-10.484],[12.102,-10.626],[12.696,-9.916],[12.755,-9.832],[12.521,-9.304],[12.247,-8.806],[11.789,-8.168],[11.535,-7.916],[11.265,-7.719],[11.887,-6.722],[12.34,-6.94],[12.618,-7.018],[13.141,-7.11],[13.819,-7.152],[14.44,-7.131],[14.57,-6.868],[14.865,-6.196],[14.502,-5.746],[14.109,-5.336],[13.718,-4.997],[13.326,-4.73],[12.879,-4.541],[13.221,-3.417],[13.716,-3.51],[14.533,-3.466],[15.199,-3.331],[15.794,-3.151],[15.962,-2.138],[15.495,-1.797],[15.009,-1.503],[14.544,-1.276],[14.096,-1.12],[13.615,-1.053],[13.655,0.122],[14.157,0.16],[14.935,0.413],[15.543,0.716],[16.071,1.044],[15.972,2.067],[15.432,2.275],[14.887,2.433],[14.378,2.532],[13.906,2.567],[13.424,2.507],[13.158,3.652],[13.633,3.818],[14.319,4.265],[14.828,4.714],[15.253,5.168],[14.893,6.13],[14.318,6.191],[13.75,6.203],[13.233,6.167],[12.768,6.078],[12.317,5.896],[11.765,6.933],[12.18,7.217],[12.728,7.826],[13.103,8.392],[13.396,8.94],[12.799,9.776],[12.227,9.686],[11.676,9.55],[11.186,9.382],[10.759,9.175],[10.372,8.883],[9.57,9.742],[9.897,10.123],[10.269,10.853],[10.484,11.497],[10.626,12.102],[9.832,12.755],[9.304,12.521],[8.806,12.247],[8.377,11.957]], [[0,1,2,3,4,5,6,7,8,9,10,11,12,13,14,15,16,17,18,19,20,21,22,23,24,25,26,27,28,29,30,31,32,33,34,35,36,37,38,39,40,41,42,43,44,45,46,47,48,49,50,51,52,53,54,55,56,57,58,59,60,61,62,63,64,65,66,67,68,69,70,71,72,73,74,75,76,77,78,79,80,81,82,83,84,85,86,87,88,89,90,91,92,93,94,95,96,97,98,99,100,101,102,103,104,105,106,107,108,109,110,111,112,113,114,115,116,117,118,119,120,121,122,123,124,125,126,127,128,129,130,131,132,133,134,135,136,137,138,139,140,141,142,143,144,145,146,147,148,149,150,151,152,153,154,155,156,157,158,159,160,161,162,163,164,165,166,167,168,169,170,171,172,173,174,175,176,177,178,179,180,181,182,183,184,185,186,187,188,189,190,191,192,193,194,195,196,197,198,199,200,201,202,203,204,205,206,207,208,209,210,211,212,213,214,215,216,217,218,219,220,221,222,223,224,225,226,227,228,229,230,231,232,233,234,235,236,237,238,239,240,241,242,243,244,245,246,247,248,249,250,251,252,253,254,255,256,257,258,259,260,261,262,263,264,265,266,267,268,269,270,271,272,273,274,275,276,277,278,279,280,281,282,283,284]]]]],
    [1.0, [[[[-3.5,-10.0],[3.5,-10.0],[3.75,-9.933],[3.854,-9.854],[3.983,-9.629],[4.0,9.5],[3.983,9.629],[3.854,9.854],[3.629,9.983],[-3.5,10.0],[-3.75,9.933],[-3.854,9.854],[-3.983,9.629],[-4.0,-9.5],[-3.983,-9.629],[-3.854,-9.854],[-3.75,-9.933],[-0.05,-1.0],[-0.309,-0.965],[-0.55,-0.866],[-0.757,-0.707],[-0.916,-0.5],[-1.016,-0.258],[-1.05,0.0],[-1.016,0.259],[-0.916,0.5],[-0.757,0.708],[-0.55,0.866],[-0.309,0.966],[-0.05,1.0],[0.209,0.966],[0.45,0.866],[0.657,0.708],[0.816,0.5],[0.916,0.259],[0.95,0.0],[0.916,-0.258],[0.816,-0.5],[0.657,-0.707],[0.45,-0.866],[0.209,-0.965]], [[0,1,2,3,4,5,6,7,8,9,10,11,12,13,14,15,16],[17,18,19,20,21,22,23,24,25,26,27,28,29,30,31,32,33,34,35,36,37,38,39,40]]]]],
    [1.5, [[[[-10.05,1.5],[-13.05,1.5],[-13.05,-1.5],[-10.05,-1.5]], [[0,1,2,3]]]]]
  ]],
  [9, "Knob, from above", [23.97, 18.39], [29.995, -0.0], [
    [0.5, [[[[-22.874,-8.806],[-22.06,-8.392],[-20.701,-7.577],[-19.925,-6.525],[-19.389,-5.609],[-19.093,-5.01],[-18.699,-4.049],[-18.38,-3.016],[-18.134,-1.822],[-18.01,-0.609],[-18.01,0.609],[-18.134,1.822],[-18.383,3.027],[-18.699,4.049],[-19.093,5.01],[-19.389,5.609],[-19.925,6.525],[-20.701,7.577],[-21.899,8.304],[-22.656,8.701],[-23.757,9.196],[-36.233,9.196],[-37.116,8.806],[-37.93,8.392],[-39.289,7.577],[-40.065,6.525],[-40.442,5.895],[-40.897,5.01],[-41.291,4.049],[-41.61,3.016],[-41.856,1.822],[-41.98,0.609],[-41.98,-0.609],[-41.856,-1.822],[-41.61,-3.016],[-41.291,-4.049],[-40.897,-5.01],[-40.442,-5.895],[-40.065,-6.525],[-39.289,-7.577],[-38.091,-8.304],[-37.334,-8.701],[-36.233,-9.196],[-23.757,-9.196]], [[0,1,2,3,4,5,6,7,8,9,10,11,12,13,14,15,16,17,18,19,20,21,22,23,24,25,26,27,28,29,30,31,32,33,34,35,36,37,38,39,40,41,42,43]]]]],
    [1.0, [[[[-25.7,-3.434],[-25.412,-3.481],[-25.124,-3.57],[-25.041,-3.638],[-25.018,-3.786],[-24.85,-3.872],[-24.308,-3.98],[-19.681,-4.0],[-18.388,-3.044],[-18.136,-1.835],[-18.011,-0.614],[-18.011,0.614],[-18.136,1.835],[-18.388,3.044],[-19.681,4.0],[-24.312,3.98],[-24.694,3.915],[-24.959,3.827],[-25.034,3.767],[-25.057,3.614],[-25.229,3.528],[-25.7,3.435],[-26.339,3.4],[-34.014,3.413],[-34.389,3.447],[-34.761,3.528],[-34.933,3.614],[-34.948,3.75],[-35.032,3.827],[-35.292,3.915],[-35.683,3.98],[-40.309,4.0],[-41.602,3.044],[-41.854,1.835],[-41.979,0.614],[-41.979,-0.614],[-41.854,-1.835],[-41.602,-3.044],[-40.309,-4.0],[-35.678,-3.98],[-35.296,-3.915],[-35.031,-3.827],[-34.948,-3.75],[-34.943,-3.626],[-34.793,-3.539],[-34.299,-3.435],[-33.985,-3.408],[-26.339,-3.4]], [[0,1,2,3,4,5,6,7,8,9,10,11,12,13,14,15,16,17,18,19,20,21,22,23,24,25,26,27,28,29,30,31,32,33,34,35,36,37,38,39,40,41,42,43,44,45,46,47]]]]]
  ]],
  [10, "Lid, from above, the post shown through it", [80.78, 50.8], [15.0, -0.0], [
    [0.5, [[[[0.0,-25.4],[-30.0,-25.4],[-31.777,-25.338],[-33.545,-25.151],[-35.296,-24.842],[-37.021,-24.41],[-38.712,-23.859],[-40.36,-23.191],[-41.957,-22.41],[-43.495,-21.518],[-44.968,-20.521],[-45.928,-19.771],[-46.367,-19.424],[-47.685,-18.231],[-48.917,-16.949],[-50.057,-15.584],[-51.098,-14.143],[-52.036,-12.632],[-52.865,-11.06],[-53.583,-9.433],[-54.185,-7.76],[-54.521,-6.588],[-54.669,-6.049],[-55.032,-4.308],[-55.272,-2.546],[-55.388,-0.772],[-55.379,1.006],[-55.247,2.779],[-54.99,4.539],[-54.612,6.276],[-54.112,7.982],[-53.695,9.128],[-53.495,9.65],[-52.762,11.27],[-51.918,12.834],[-50.966,14.336],[-49.912,15.768],[-48.76,17.122],[-47.913,17.999],[-47.516,18.393],[-46.186,19.573],[-44.777,20.657],[-43.766,21.339],[-43.296,21.64],[-41.749,22.517],[-40.145,23.284],[-39.015,23.741],[-38.491,23.937],[-36.795,24.472],[-35.067,24.887],[-33.866,25.099],[-31.611,25.347],[-30.0,25.4],[0.0,25.4],[1.913,25.327],[3.504,25.157],[5.067,24.887],[6.795,24.472],[8.491,23.937],[10.145,23.284],[11.749,22.517],[13.296,21.64],[14.777,20.657],[16.186,19.573],[17.516,18.393],[17.913,17.999],[18.76,17.122],[19.912,15.768],[20.966,14.336],[21.918,12.834],[22.19,12.346],[22.762,11.27],[23.495,9.65],[24.112,7.982],[24.612,6.276],[24.737,5.731],[24.99,4.539],[25.247,2.779],[25.379,1.006],[25.388,0.447],[25.388,-0.772],[25.272,-2.546],[25.032,-4.308],[24.669,-6.049],[24.521,-6.588],[24.185,-7.76],[23.583,-9.433],[22.865,-11.06],[22.036,-12.632],[21.744,-13.109],[21.098,-14.143],[20.057,-15.584],[18.917,-16.949],[17.685,-18.231],[17.272,-18.608],[16.367,-19.424],[14.968,-20.521],[13.495,-21.518],[11.957,-22.41],[10.36,-23.191],[9.842,-23.403],[8.712,-23.859],[7.021,-24.41],[5.296,-24.842],[3.545,-25.151],[2.989,-25.21],[1.777,-25.338],[-37.921,10.332],[-38.893,9.509],[-39.779,8.595],[-40.572,7.598],[-41.263,6.529],[-41.847,5.397],[-42.317,4.214],[-42.67,2.99],[-42.901,1.738],[-43.008,0.469],[-42.991,-0.804],[-42.85,-2.069],[-42.586,-3.314],[-42.317,-4.214],[-41.847,-5.397],[-41.263,-6.529],[-40.572,-7.598],[-40.367,-7.863],[-39.779,-8.595],[-38.893,-9.509],[-38.639,-9.727],[-37.921,-10.332],[-37.647,-10.524],[-36.874,-11.057],[-36.053,-11.513],[-35.761,-11.676],[-34.593,-12.182],[-33.381,-12.573],[-32.136,-12.843],[-31.204,-12.956],[-30.871,-12.99],[-29.598,-13.012],[-28.329,-12.911],[-27.075,-12.685],[-26.169,-12.438],[-24.972,-12.005],[-23.823,-11.457],[-22.733,-10.8],[-21.713,-10.038],[-20.771,-9.181],[-19.918,-8.236],[-19.161,-7.212],[-18.509,-6.118],[-17.966,-4.967],[-17.538,-3.767],[-17.229,-2.532],[-17.043,-1.272],[-16.981,-0.0],[-17.043,1.272],[-17.229,2.532],[-17.538,3.767],[-17.966,4.967],[-18.509,6.118],[-19.161,7.212],[-19.918,8.236],[-20.771,9.181],[-21.713,10.038],[-22.733,10.8],[-23.531,11.295],[-24.665,11.873],[-25.85,12.338],[-27.075,12.685],[-28.329,12.911],[-29.598,13.012],[-30.871,12.99],[-32.136,12.843],[-33.381,12.573],[-34.593,12.182],[-35.761,11.676],[-36.874,11.057],[0.0,-1.0],[0.259,-0.966],[0.5,-0.866],[0.707,-0.707],[0.866,-0.5],[0.966,-0.259],[1.0,0.0],[0.966,0.259],[0.866,0.5],[0.707,0.707],[0.5,0.866],[0.259,0.966],[0.0,1.0],[-0.259,0.966],[-0.5,0.866],[-0.707,0.707],[-0.866,0.5],[-0.966,0.259],[-1.0,0.0],[-0.966,-0.259],[-0.866,-0.5],[-0.707,-0.707],[-0.5,-0.866],[-0.259,-0.966]], [[0,1,2,3,4,5,6,7,8,9,10,11,12,13,14,15,16,17,18,19,20,21,22,23,24,25,26,27,28,29,30,31,32,33,34,35,36,37,38,39,40,41,42,43,44,45,46,47,48,49,50,51,52,53,54,55,56,57,58,59,60,61,62,63,64,65,66,67,68,69,70,71,72,73,74,75,76,77,78,79,80,81,82,83,84,85,86,87,88,89,90,91,92,93,94,95,96,97,98,99,100,101,102,103,104,105,106],[107,108,109,110,111,112,113,114,115,116,117,118,119,120,121,122,123,124,125,126,127,128,129,130,131,132,133,134,135,136,137,138,139,140,141,142,143,144,145,146,147,148,149,150,151,152,153,154,155,156,157,158,159,160,161,162,163,164,165,166,167,168,169,170,171,172,173,174,175,176],[177,178,179,180,181,182,183,184,185,186,187,188,189,190,191,192,193,194,195,196,197,198,199,200]]]]],
    [1.0, [[[[1.249,4.475],[0.56,4.616],[-0.187,4.646],[-0.93,4.556],[-1.649,4.348],[-2.325,4.027],[-2.941,3.602],[-3.481,3.084],[-3.93,2.485],[-4.278,1.823],[-4.515,1.113],[-4.635,0.374],[-4.635,-0.374],[-4.515,-1.113],[-4.278,-1.823],[-3.93,-2.485],[-3.481,-3.084],[-2.941,-3.602],[-2.325,-4.027],[-1.649,-4.348],[-0.93,-4.556],[-0.187,-4.646],[0.56,-4.616],[1.294,-4.466],[1.993,-4.201],[2.642,-3.827],[3.221,-3.354],[3.717,-2.793],[4.117,-2.161],[4.411,-1.473],[4.59,-0.746],[4.65,0.0],[4.59,0.746],[4.411,1.473],[4.117,2.161],[3.717,2.793],[3.221,3.354],[2.642,3.827],[1.993,4.201],[0.0,-1.0],[-0.259,-0.966],[-0.5,-0.866],[-0.707,-0.707],[-0.866,-0.5],[-0.966,-0.259],[-1.0,-0.0],[-0.966,0.259],[-0.866,0.5],[-0.707,0.707],[-0.5,0.866],[-0.259,0.966],[0.0,1.0],[0.259,0.966],[0.5,0.866],[0.707,0.707],[0.866,0.5],[0.966,0.259],[1.0,0.0],[0.966,-0.259],[0.866,-0.5],[0.707,-0.707],[0.5,-0.866],[0.259,-0.966]], [[0,1,2,3,4,5,6,7,8,9,10,11,12,13,14,15,16,17,18,19,20,21,22,23,24,25,26,27,28,29,30,31,32,33,34,35,36,37,38],[39,40,41,42,43,44,45,46,47,48,49,50,51,52,53,54,55,56,57,58,59,60,61,62]]]]]
  ]],
  [11, "Handle, from above, the cup's keyhole shown through it", [77.46, 28.5], [14.944, 0.241], [
    [0.5, [[[[-9.495,-14.491],[-11.721,-14.491],[-12.425,-14.291],[-13.129,-13.991],[-40.371,-13.974],[-41.76,-13.834],[-42.91,-13.609],[-43.726,-13.392],[-44.526,-13.121],[-45.74,-12.607],[-46.899,-11.98],[-47.995,-11.248],[-49.017,-10.416],[-49.955,-9.49],[-50.51,-8.854],[-51.022,-8.182],[-51.743,-7.079],[-52.357,-5.913],[-52.859,-4.694],[-53.243,-3.433],[-53.506,-2.142],[-53.646,-0.832],[-53.673,0.013],[-53.645,0.857],[-53.504,2.167],[-53.241,3.459],[-52.856,4.719],[-52.355,5.938],[-51.973,6.692],[-51.544,7.419],[-51.018,8.206],[-50.505,8.877],[-49.95,9.514],[-49.28,10.183],[-48.652,10.747],[-47.989,11.27],[-46.893,12.002],[-46.156,12.415],[-45.394,12.779],[-44.519,13.141],[-43.719,13.411],[-42.902,13.628],[-41.754,13.853],[-41.063,13.939],[-39.673,14.009],[10.526,13.99],[11.963,13.841],[13.377,13.544],[14.758,13.102],[15.539,12.779],[16.032,12.88],[16.477,12.881],[17.558,12.26],[18.473,11.629],[18.903,11.026],[19.245,10.342],[20.205,9.378],[21.046,8.348],[21.809,7.206],[22.457,5.994],[22.983,4.725],[23.382,3.41],[23.65,2.063],[23.785,0.696],[23.785,-0.678],[23.734,-1.363],[23.533,-2.722],[23.199,-4.055],[22.736,-5.349],[22.148,-6.591],[21.442,-7.769],[21.046,-8.331],[20.385,-9.155],[19.216,-10.353],[18.217,-11.18],[17.191,-11.882],[16.011,-12.539],[14.873,-13.04],[13.695,-13.437],[12.329,-13.761],[11.097,-13.931],[9.802,-13.991],[-8.695,-13.991],[-9.095,-14.291],[-17.85,-0.2],[-17.891,0.997],[-18.048,2.184],[-18.321,3.35],[-18.565,4.117],[-18.747,4.575],[-19.564,5.341],[-20.863,6.387],[-39.127,6.387],[-40.475,5.297],[-41.243,4.575],[-41.553,3.733],[-41.864,2.577],[-42.059,1.395],[-42.138,0.2],[-42.1,-0.997],[-41.944,-2.184],[-41.671,-3.35],[-41.425,-4.118],[-41.243,-4.575],[-40.426,-5.341],[-39.127,-6.387],[-20.863,-6.387],[-19.515,-5.297],[-18.747,-4.575],[-18.439,-3.732],[-18.126,-2.576],[-17.929,-1.395]], [[0,1,2,3,4,5,6,7,8,9,10,11,12,13,14,15,16,17,18,19,20,21,22,23,24,25,26,27,28,29,30,31,32,33,34,35,36,37,38,39,40,41,42,43,44,45,46,47,48,49,50,51,52,53,54,55,56,57,58,59,60,61,62,63,64,65,66,67,68,69,70,71,72,73,74,75,76,77,78,79,80,81,82,83],[84,85,86,87,88,89,90,91,92,93,94,95,96,97,98,99,100,101,102,103,104,105,106,107,108,109,110,111]]]]]
  ]],
  [12, "Base, from above", [98.4, 68.41], [15.0, -0.0], [
    [0.5, [[[[0.0,34.202],[-29.547,34.204],[-31.319,34.18],[-32.636,34.103],[-33.949,33.975],[-35.257,33.796],[-36.633,33.552],[-37.998,33.253],[-39.35,32.899],[-40.687,32.49],[-42.006,32.027],[-43.305,31.511],[-44.581,30.942],[-45.833,30.32],[-47.059,29.648],[-48.255,28.925],[-49.422,28.155],[-50.556,27.338],[-51.655,26.475],[-52.719,25.568],[-53.745,24.619],[-54.732,23.629],[-55.677,22.599],[-56.579,21.531],[-57.436,20.427],[-58.247,19.288],[-59.011,18.118],[-59.726,16.917],[-60.393,15.688],[-61.009,14.434],[-61.573,13.155],[-62.085,11.854],[-62.543,10.534],[-62.946,9.195],[-63.294,7.841],[-63.587,6.474],[-63.823,5.097],[-64.003,3.711],[-64.127,2.318],[-64.193,0.922],[-64.202,-0.476],[-64.154,-1.873],[-64.049,-3.267],[-63.887,-4.655],[-63.668,-6.036],[-63.394,-7.406],[-63.063,-8.764],[-62.678,-10.108],[-62.238,-11.435],[-61.743,-12.742],[-61.362,-13.639],[-60.597,-15.292],[-59.947,-16.529],[-59.247,-17.739],[-58.497,-18.919],[-57.701,-20.067],[-56.858,-21.182],[-55.97,-22.262],[-55.038,-23.304],[-54.065,-24.307],[-53.051,-25.27],[-51.999,-26.19],[-50.911,-27.067],[-49.788,-27.899],[-48.632,-28.685],[-47.444,-29.423],[-46.228,-30.111],[-44.984,-30.749],[-43.715,-31.335],[-42.423,-31.868],[-40.929,-32.411],[-39.412,-32.883],[-37.875,-33.286],[-36.32,-33.616],[-34.752,-33.874],[-33.174,-34.058],[-31.589,-34.169],[-30.0,-34.202],[-0.453,-34.204],[1.319,-34.18],[2.636,-34.103],[3.949,-33.975],[5.256,-33.796],[6.633,-33.552],[7.998,-33.253],[9.35,-32.899],[10.687,-32.49],[12.006,-32.027],[13.305,-31.511],[14.581,-30.942],[15.833,-30.32],[17.059,-29.648],[18.255,-28.925],[19.422,-28.155],[20.556,-27.338],[21.655,-26.475],[22.719,-25.568],[23.745,-24.619],[24.732,-23.629],[25.677,-22.599],[26.579,-21.531],[27.436,-20.427],[28.247,-19.288],[29.011,-18.118],[29.726,-16.917],[30.393,-15.688],[31.009,-14.434],[31.573,-13.155],[32.085,-11.854],[32.543,-10.534],[32.946,-9.195],[33.294,-7.841],[33.587,-6.475],[33.823,-5.097],[34.003,-3.711],[34.127,-2.318],[34.193,-0.922],[34.202,0.476],[34.154,1.873],[34.049,3.267],[33.887,4.655],[33.668,6.036],[33.394,7.406],[33.063,8.764],[32.678,10.108],[32.238,11.435],[31.743,12.742],[31.196,14.029],[30.597,15.292],[29.947,16.529],[29.247,17.739],[28.497,18.919],[27.701,20.067],[26.858,21.182],[25.97,22.262],[25.038,23.304],[24.065,24.307],[23.051,25.27],[21.999,26.19],[20.911,27.067],[19.788,27.899],[18.632,28.685],[17.444,29.423],[16.228,30.111],[14.984,30.749],[13.715,31.335],[12.423,31.868],[10.929,32.411],[9.412,32.883],[7.875,33.286],[6.32,33.616],[4.752,33.874],[3.174,34.058],[1.589,34.169]], [[0,1,2,3,4,5,6,7,8,9,10,11,12,13,14,15,16,17,18,19,20,21,22,23,24,25,26,27,28,29,30,31,32,33,34,35,36,37,38,39,40,41,42,43,44,45,46,47,48,49,50,51,52,53,54,55,56,57,58,59,60,61,62,63,64,65,66,67,68,69,70,71,72,73,74,75,76,77,78,79,80,81,82,83,84,85,86,87,88,89,90,91,92,93,94,95,96,97,98,99,100,101,102,103,104,105,106,107,108,109,110,111,112,113,114,115,116,117,118,119,120,121,122,123,124,125,126,127,128,129,130,131,132,133,134,135,136,137,138,139,140,141,142,143,144,145,146,147,148,149,150,151,152,153]]]]],
    [1.0, [[[[-2.8,-16.9],[-27.2,-16.9],[-26.876,-16.943],[-26.575,-17.067],[-26.316,-17.266],[-26.117,-17.525],[-25.993,-17.826],[-25.95,-18.15],[-25.95,-19.15],[-25.993,-19.474],[-26.117,-19.775],[-26.316,-20.034],[-26.575,-20.233],[-26.876,-20.357],[-27.2,-20.4],[-30.0,-20.4],[-31.598,-20.337],[-33.187,-20.15],[-34.756,-19.838],[-36.295,-19.404],[-37.796,-18.851],[-39.249,-18.183],[-40.645,-17.402],[-41.976,-16.515],[-43.398,-15.376],[-44.409,-14.441],[-45.496,-13.268],[-46.488,-12.013],[-47.378,-10.684],[-48.257,-9.088],[-48.834,-7.838],[-49.39,-6.338],[-49.827,-4.8],[-50.142,-3.232],[-50.346,-1.421],[-50.4,-0.045],[-50.34,1.553],[-50.156,3.142],[-49.848,4.711],[-49.345,6.462],[-48.868,7.754],[-48.203,9.209],[-47.425,10.606],[-46.407,12.117],[-45.554,13.198],[-44.473,14.376],[-43.302,15.466],[-42.049,16.461],[-40.531,17.468],[-39.33,18.141],[-37.88,18.816],[-36.381,19.375],[-34.627,19.865],[-33.206,20.146],[-31.632,20.334],[-30.0,20.4],[-26.354,20.4],[-25.769,20.458],[-25.206,20.628],[-24.688,20.906],[-24.233,21.279],[-23.86,21.733],[-23.583,22.252],[-23.412,22.815],[-23.289,23.992],[-23.1,24.45],[-22.798,24.844],[-22.404,25.145],[-21.946,25.335],[-21.598,25.384],[-17.748,25.4],[-17.303,25.35],[-16.88,25.202],[-16.501,24.964],[-16.184,24.647],[-15.946,24.268],[-15.798,23.845],[-15.748,23.4],[-15.748,17.9],[-15.782,17.641],[-15.882,17.4],[-16.04,17.193],[-16.248,17.034],[-16.489,16.934],[-16.748,16.9],[-13.248,16.9],[-13.506,16.934],[-13.748,17.034],[-13.955,17.193],[-14.114,17.4],[-14.214,17.641],[-14.248,17.9],[-14.248,23.4],[-14.197,23.845],[-14.05,24.268],[-13.811,24.647],[-13.495,24.964],[-13.115,25.202],[-12.693,25.35],[-12.248,25.4],[-8.546,25.4],[-8.054,25.335],[-7.596,25.145],[-7.202,24.844],[-6.9,24.45],[-6.711,23.992],[-6.588,22.815],[-6.417,22.252],[-6.14,21.733],[-5.767,21.279],[-5.312,20.906],[-4.794,20.628],[-4.231,20.458],[-3.646,20.4],[0.145,20.398],[1.564,20.34],[3.137,20.157],[4.15,19.973],[5.375,20.714],[6.387,20.425],[7.967,19.86],[9.39,19.229],[10.746,18.506],[11.291,18.179],[11.6,16.781],[12.049,16.461],[13.302,15.466],[14.473,14.376],[15.554,13.198],[16.541,11.939],[17.425,10.606],[18.203,9.209],[18.868,7.754],[19.418,6.252],[19.848,4.711],[20.156,3.142],[20.34,1.553],[20.4,-0.045],[20.346,-1.421],[20.142,-3.232],[19.827,-4.8],[19.39,-6.338],[18.834,-7.838],[18.162,-9.29],[17.378,-10.684],[16.613,-11.829],[15.496,-13.268],[14.409,-14.441],[13.233,-15.525],[11.976,-16.515],[10.828,-17.282],[9.249,-18.183],[7.796,-18.851],[6.295,-19.404],[4.97,-19.778],[3.187,-20.15],[1.598,-20.337],[0.0,-20.4],[-2.8,-20.4],[-3.124,-20.357],[-3.425,-20.233],[-3.684,-20.034],[-3.883,-19.775],[-4.007,-19.474],[-4.05,-19.15],[-4.05,-18.15],[-4.007,-17.826],[-3.883,-17.525],[-3.684,-17.266],[-3.425,-17.067],[-3.124,-16.943],[-40.292,-1.714],[-39.998,-1.183],[-39.816,-0.604],[-39.755,0.0],[-39.816,0.604],[-39.998,1.183],[-40.292,1.714],[-40.688,2.174],[-41.168,2.546],[-41.713,2.813],[-42.3,2.965],[-42.907,2.996],[-43.507,2.904],[-44.076,2.693],[-44.591,2.372],[-45.031,1.954],[-45.378,1.456],[-45.617,0.898],[-45.739,0.304],[-45.739,-0.304],[-45.617,-0.898],[-45.378,-1.456],[-45.031,-1.954],[-44.591,-2.372],[-44.076,-2.693],[-43.507,-2.904],[-42.907,-2.996],[-42.3,-2.965],[-41.713,-2.813],[-41.168,-2.546],[-40.688,-2.174],[-15.0,-11.297],[-14.284,-11.236],[-13.588,-11.055],[-12.933,-10.759],[-12.188,-10.229],[-11.691,-9.71],[-11.288,-9.114],[-10.992,-8.459],[-10.811,-7.763],[-10.75,-7.047],[-10.75,7.047],[-10.811,7.763],[-10.992,8.459],[-11.067,8.64],[-11.288,9.114],[-11.691,9.71],[-12.188,10.229],[-12.933,10.759],[-13.588,11.055],[-14.284,11.236],[-15.0,11.297],[-15.716,11.236],[-16.412,11.055],[-17.067,10.759],[-17.663,10.356],[-18.309,9.71],[-18.712,9.114],[-19.008,8.459],[-19.189,7.763],[-19.25,7.047],[-19.25,-7.047],[-19.189,-7.763],[-19.008,-8.459],[-18.933,-8.64],[-18.712,-9.114],[-18.309,-9.71],[-17.812,-10.229],[-17.067,-10.759],[-16.412,-11.055],[-15.716,-11.236],[15.23,-1.691],[15.512,-1.183],[15.693,-0.604],[15.755,0.0],[15.693,0.604],[15.512,1.183],[15.217,1.714],[14.822,2.174],[14.342,2.546],[13.797,2.813],[13.209,2.965],[12.603,2.996],[12.003,2.904],[11.433,2.693],[10.918,2.372],[10.478,1.954],[10.132,1.456],[9.892,0.898],[9.77,0.304],[9.77,-0.304],[9.892,-0.898],[10.132,-1.456],[10.478,-1.954],[10.918,-2.372],[11.433,-2.693],[12.003,-2.904],[12.603,-2.996],[13.209,-2.965],[13.797,-2.813],[14.342,-2.546],[14.822,-2.174]], [[0,1,2,3,4,5,6,7,8,9,10,11,12,13,14,15,16,17,18,19,20,21,22,23,24,25,26,27,28,29,30,31,32,33,34,35,36,37,38,39,40,41,42,43,44,45,46,47,48,49,50,51,52,53,54,55,56,57,58,59,60,61,62,63,64,65,66,67,68,69,70,71,72,73,74,75,76,77,78,79,80,81,82,83,84,85,86,87,88,89,90,91,92,93,94,95,96,97,98,99,100,101,102,103,104,105,106,107,108,109,110,111,112,113,114,115,116,117,118,119,120,121,122,123,124,125,126,127,128,129,130,131,132,133,134,135,136,137,138,139,140,141,142,143,144,145,146,147,148,149,150,151,152,153,154,155,156,157,158,159,160,161,162,163,164,165,166,167,168,169,170],[171,172,173,174,175,176,177,178,179,180,181,182,183,184,185,186,187,188,189,190,191,192,193,194,195,196,197,198,199,200,201],[202,203,204,205,206,207,208,209,210,211,212,213,214,215,216,217,218,219,220,221,222,223,224,225,226,227,228,229,230,231,232,233,234,235,236,237,238,239,240,241],[242,243,244,245,246,247,248,249,250,251,252,253,254,255,256,257,258,259,260,261,262,263,264,265,266,267,268,269,270,271,272]]]]],
    [1.5, [[[[-40.617,-13.149],[-39.464,-14.002],[-38.242,-14.754],[-36.961,-15.4],[-35.63,-15.935],[-34.258,-16.355],[-32.856,-16.657],[-31.433,-16.839],[-30.017,-16.9],[-27.2,-16.9],[-26.876,-16.943],[-26.575,-17.067],[-26.316,-17.266],[-26.117,-17.525],[-25.993,-17.826],[-25.95,-18.15],[-25.95,-19.15],[-25.993,-19.474],[-26.117,-19.775],[-26.316,-20.034],[-26.575,-20.233],[-26.876,-20.357],[-27.2,-20.4],[-30.0,-20.4],[-31.598,-20.337],[-33.187,-20.15],[-34.756,-19.838],[-36.295,-19.404],[-37.796,-18.851],[-39.249,-18.183],[-40.645,-17.402],[-42.152,-16.378],[-43.233,-15.525],[-44.409,-14.441],[-45.496,-13.268],[-46.488,-12.013],[-47.378,-10.684],[-48.162,-9.29],[-48.834,-7.838],[-49.39,-6.338],[-49.827,-4.8],[-50.142,-3.232],[-50.346,-1.421],[-50.4,-0.045],[-50.34,1.553],[-50.156,3.142],[-49.848,4.711],[-49.418,6.252],[-48.868,7.754],[-48.203,9.209],[-47.425,10.606],[-46.541,11.939],[-45.554,13.198],[-44.473,14.376],[-43.302,15.466],[-42.049,16.461],[-40.722,17.354],[-39.13,18.239],[-37.88,18.816],[-36.381,19.375],[-34.844,19.816],[-33.206,20.146],[-31.632,20.334],[-30.0,20.4],[-26.354,20.4],[-25.769,20.458],[-25.206,20.628],[-24.688,20.906],[-24.233,21.279],[-23.86,21.733],[-23.583,22.252],[-23.412,22.815],[-23.289,23.992],[-23.1,24.45],[-22.798,24.844],[-22.404,25.145],[-21.946,25.335],[-21.454,25.4],[-17.748,25.4],[-17.303,25.35],[-16.88,25.202],[-16.501,24.964],[-16.184,24.647],[-15.946,24.268],[-15.798,23.845],[-15.748,23.4],[-15.748,17.9],[-15.782,17.641],[-15.882,17.4],[-16.04,17.193],[-16.248,17.034],[-16.489,16.934],[-16.748,16.9],[-30.0,16.9],[-31.433,16.839],[-32.856,16.657],[-34.258,16.355],[-35.63,15.935],[-36.961,15.4],[-38.242,14.754],[-39.464,14.002],[-40.617,13.149],[-41.694,12.201],[-42.686,11.165],[-43.588,10.049],[-44.391,8.861],[-45.09,7.608],[-45.681,6.301],[-46.159,4.949],[-46.521,3.56],[-46.763,2.147],[-46.885,0.717],[-46.885,-0.717],[-46.763,-2.147],[-46.521,-3.56],[-46.159,-4.949],[-45.681,-6.301],[-45.09,-7.608],[-44.391,-8.861],[-43.588,-10.049],[-42.686,-11.165],[-41.694,-12.201]], [[0,1,2,3,4,5,6,7,8,9,10,11,12,13,14,15,16,17,18,19,20,21,22,23,24,25,26,27,28,29,30,31,32,33,34,35,36,37,38,39,40,41,42,43,44,45,46,47,48,49,50,51,52,53,54,55,56,57,58,59,60,61,62,63,64,65,66,67,68,69,70,71,72,73,74,75,76,77,78,79,80,81,82,83,84,85,86,87,88,89,90,91,92,93,94,95,96,97,98,99,100,101,102,103,104,105,106,107,108,109,110,111,112,113,114,115,116,117,118,119,120,121]]], [[[-3.053,-20.367],[-3.425,-20.233],[-3.684,-20.034],[-3.883,-19.775],[-4.007,-19.474],[-4.05,-19.15],[-4.05,-18.15],[-4.007,-17.826],[-3.883,-17.525],[-3.684,-17.266],[-3.425,-17.067],[-3.124,-16.943],[-2.8,-16.9],[-0.0,-16.9],[1.433,-16.839],[2.856,-16.657],[4.258,-16.355],[5.63,-15.935],[6.961,-15.4],[8.242,-14.754],[9.464,-14.002],[10.617,-13.149],[11.694,-12.201],[12.686,-11.165],[13.588,-10.049],[14.391,-8.861],[15.09,-7.608],[15.681,-6.301],[16.159,-4.949],[16.521,-3.56],[16.763,-2.147],[16.885,-0.717],[16.885,0.717],[16.763,2.147],[16.521,3.56],[16.159,4.949],[15.681,6.301],[15.09,7.608],[14.391,8.861],[13.588,10.049],[12.686,11.165],[11.694,12.201],[10.617,13.149],[9.464,14.002],[8.242,14.754],[6.961,15.4],[5.63,15.935],[4.258,16.355],[2.856,16.657],[1.433,16.839],[0.017,16.9],[-13.248,16.9],[-13.506,16.934],[-13.748,17.034],[-13.955,17.193],[-14.114,17.4],[-14.214,17.641],[-14.248,17.9],[-14.248,23.4],[-14.197,23.845],[-14.05,24.268],[-13.811,24.647],[-13.495,24.964],[-13.115,25.202],[-12.693,25.35],[-12.248,25.4],[-8.546,25.4],[-8.054,25.335],[-7.596,25.145],[-7.202,24.844],[-6.9,24.45],[-6.711,23.992],[-6.588,22.815],[-6.417,22.252],[-6.14,21.733],[-5.767,21.279],[-5.312,20.906],[-4.794,20.628],[-4.231,20.458],[-3.646,20.4],[-0.0,20.4],[1.123,20.368],[3.137,20.157],[4.15,19.973],[5.375,20.714],[6.387,20.425],[7.967,19.86],[9.39,19.229],[10.746,18.506],[11.291,18.179],[11.6,16.781],[12.049,16.461],[13.302,15.466],[14.473,14.376],[15.554,13.198],[16.407,12.117],[17.425,10.606],[18.203,9.209],[18.868,7.754],[19.418,6.252],[19.848,4.711],[20.156,3.142],[20.318,1.775],[20.4,-0.045],[20.333,-1.644],[20.172,-3.011],[19.827,-4.8],[19.39,-6.338],[18.914,-7.63],[18.162,-9.29],[17.378,-10.684],[16.613,-11.829],[15.496,-13.268],[14.409,-14.441],[13.398,-15.376],[11.976,-16.515],[10.642,-17.404],[9.444,-18.075],[7.796,-18.851],[6.295,-19.404],[4.97,-19.778],[3.187,-20.15],[1.598,-20.337],[0.0,-20.4],[-2.8,-20.4]], [[0,1,2,3,4,5,6,7,8,9,10,11,12,13,14,15,16,17,18,19,20,21,22,23,24,25,26,27,28,29,30,31,32,33,34,35,36,37,38,39,40,41,42,43,44,45,46,47,48,49,50,51,52,53,54,55,56,57,58,59,60,61,62,63,64,65,66,67,68,69,70,71,72,73,74,75,76,77,78,79,80,81,82,83,84,85,86,87,88,89,90,91,92,93,94,95,96,97,98,99,100,101,102,103,104,105,106,107,108,109,110,111,112,113,114,115,116,117,118,119,120,121,122,123,124]]], [[[-36.713,-1.364],[-36.835,-0.458],[-36.835,0.458],[-36.713,1.364],[-36.471,2.247],[-36.114,3.089],[-35.647,3.877],[-35.08,4.595],[-34.423,5.231],[-33.686,5.774],[-32.883,6.214],[-32.029,6.542],[-31.139,6.755],[-30.229,6.846],[-29.314,6.816],[-28.412,6.663],[-27.538,6.392],[-26.708,6.007],[-25.937,5.515],[-25.238,4.924],[-24.624,4.245],[-24.106,3.491],[-23.694,2.674],[-23.393,1.81],[-23.211,0.913],[-23.15,0.0],[-23.211,-0.913],[-23.393,-1.81],[-23.694,-2.674],[-24.106,-3.491],[-24.624,-4.245],[-25.238,-4.924],[-25.937,-5.515],[-26.708,-6.007],[-27.538,-6.392],[-28.412,-6.663],[-29.314,-6.816],[-30.229,-6.846],[-31.139,-6.755],[-32.029,-6.542],[-32.883,-6.214],[-33.686,-5.774],[-34.423,-5.231],[-35.08,-4.595],[-35.647,-3.877],[-36.114,-3.089],[-36.471,-2.247],[-29.5,-0.866],[-29.293,-0.707],[-29.134,-0.5],[-29.034,-0.259],[-29.0,-0.0],[-29.034,0.259],[-29.134,0.5],[-29.293,0.707],[-29.5,0.866],[-29.741,0.966],[-30.0,1.0],[-30.259,0.966],[-30.5,0.866],[-30.707,0.707],[-30.866,0.5],[-30.966,0.259],[-31.0,-0.0],[-30.966,-0.259],[-30.866,-0.5],[-30.707,-0.707],[-30.5,-0.866],[-30.259,-0.966],[-30.0,-1.0],[-29.741,-0.966]], [[0,1,2,3,4,5,6,7,8,9,10,11,12,13,14,15,16,17,18,19,20,21,22,23,24,25,26,27,28,29,30,31,32,33,34,35,36,37,38,39,40,41,42,43,44,45,46],[47,48,49,50,51,52,53,54,55,56,57,58,59,60,61,62,63,64,65,66,67,68,69,70]]], [[[4.117,2.161],[4.411,1.473],[4.59,0.746],[4.65,-0.0],[4.59,-0.746],[4.411,-1.473],[4.117,-2.161],[3.717,-2.793],[3.221,-3.354],[2.642,-3.827],[1.993,-4.201],[1.294,-4.466],[0.56,-4.616],[-0.187,-4.646],[-0.93,-4.556],[-1.649,-4.348],[-2.325,-4.027],[-2.941,-3.602],[-3.481,-3.084],[-3.93,-2.485],[-4.278,-1.823],[-4.515,-1.113],[-4.635,-0.374],[-4.635,0.374],[-4.515,1.113],[-4.278,1.823],[-3.93,2.485],[-3.481,3.084],[-2.941,3.602],[-2.325,4.027],[-1.649,4.348],[-0.93,4.556],[-0.187,4.646],[0.56,4.616],[1.294,4.466],[1.993,4.201],[2.642,3.827],[3.221,3.354],[3.717,2.793],[0.0,-1.0],[0.259,-0.966],[0.5,-0.866],[0.707,-0.707],[0.866,-0.5],[0.966,-0.259],[1.0,0.0],[0.966,0.259],[0.866,0.5],[0.707,0.707],[0.5,0.866],[0.259,0.966],[0.0,1.0],[-0.259,0.966],[-0.5,0.866],[-0.707,0.707],[-0.866,0.5],[-0.966,0.259],[-1.0,-0.0],[-0.966,-0.259],[-0.866,-0.5],[-0.707,-0.707],[-0.5,-0.866],[-0.259,-0.966]], [[0,1,2,3,4,5,6,7,8,9,10,11,12,13,14,15,16,17,18,19,20,21,22,23,24,25,26,27,28,29,30,31,32,33,34,35,36,37,38],[39,40,41,42,43,44,45,46,47,48,49,50,51,52,53,54,55,56,57,58,59,60,61,62]]]]]
  ]],
  [13, "Base, from below", [98.4, 68.41], [15.0, 0.001], [
    [0.5, [[[[1.223,34.176],[3.174,34.058],[4.752,33.874],[6.32,33.616],[7.875,33.286],[9.412,32.883],[10.929,32.411],[12.423,31.868],[13.715,31.335],[14.984,30.749],[16.228,30.111],[17.444,29.423],[18.632,28.685],[19.788,27.899],[20.911,27.067],[21.999,26.19],[23.051,25.27],[24.065,24.307],[25.038,23.304],[25.97,22.262],[26.858,21.182],[27.701,20.067],[28.497,18.919],[29.247,17.739],[29.947,16.529],[30.597,15.292],[31.196,14.029],[31.743,12.742],[32.238,11.435],[32.678,10.108],[33.063,8.764],[33.394,7.406],[33.668,6.036],[33.887,4.655],[34.049,3.267],[34.154,1.873],[34.202,0.476],[34.193,-0.922],[34.127,-2.318],[34.003,-3.711],[33.823,-5.097],[33.587,-6.475],[33.294,-7.841],[32.946,-9.195],[32.543,-10.534],[32.085,-11.854],[31.573,-13.155],[31.009,-14.434],[30.393,-15.688],[29.726,-16.917],[29.011,-18.118],[28.247,-19.288],[27.436,-20.427],[26.579,-21.531],[25.677,-22.599],[24.732,-23.629],[23.745,-24.619],[22.719,-25.568],[21.655,-26.475],[20.556,-27.338],[19.422,-28.155],[18.255,-28.925],[17.059,-29.648],[15.833,-30.32],[14.581,-30.942],[13.305,-31.511],[12.006,-32.027],[10.687,-32.49],[9.35,-32.899],[7.998,-33.253],[6.633,-33.552],[5.256,-33.796],[3.949,-33.975],[2.636,-34.103],[1.319,-34.18],[-0.453,-34.204],[-30.0,-34.202],[-31.589,-34.169],[-33.174,-34.058],[-34.752,-33.874],[-36.32,-33.616],[-37.875,-33.286],[-39.412,-32.883],[-40.929,-32.411],[-42.423,-31.868],[-43.715,-31.335],[-44.984,-30.749],[-46.228,-30.111],[-47.444,-29.423],[-48.632,-28.685],[-49.788,-27.899],[-50.911,-27.067],[-51.999,-26.19],[-53.051,-25.27],[-54.065,-24.307],[-55.038,-23.304],[-55.97,-22.262],[-56.858,-21.182],[-57.701,-20.067],[-58.497,-18.919],[-59.247,-17.739],[-59.947,-16.529],[-60.597,-15.292],[-61.362,-13.639],[-61.743,-12.742],[-62.238,-11.435],[-62.678,-10.108],[-63.063,-8.764],[-63.394,-7.406],[-63.668,-6.036],[-63.887,-4.655],[-64.049,-3.267],[-64.154,-1.873],[-64.202,-0.476],[-64.193,0.922],[-64.127,2.318],[-64.003,3.711],[-63.823,5.097],[-63.587,6.474],[-63.294,7.841],[-62.946,9.195],[-62.543,10.534],[-62.085,11.854],[-61.573,13.155],[-61.009,14.434],[-60.393,15.688],[-59.726,16.917],[-59.011,18.118],[-58.247,19.288],[-57.436,20.427],[-56.579,21.531],[-55.677,22.599],[-54.732,23.629],[-53.745,24.619],[-52.719,25.568],[-51.655,26.475],[-50.556,27.338],[-49.422,28.155],[-48.255,28.925],[-47.059,29.648],[-45.833,30.32],[-44.581,30.942],[-43.305,31.511],[-42.006,32.027],[-40.687,32.49],[-39.35,32.899],[-37.998,33.253],[-36.633,33.552],[-35.257,33.796],[-33.949,33.975],[-32.636,34.103],[-31.319,34.18],[-30.0,34.202],[0.0,34.202],[-40.671,-2.154],[-40.292,-1.714],[-39.998,-1.183],[-39.816,-0.604],[-39.755,0.0],[-39.816,0.604],[-39.998,1.183],[-40.292,1.714],[-40.688,2.174],[-41.168,2.546],[-41.713,2.813],[-42.3,2.965],[-42.907,2.996],[-43.507,2.904],[-44.076,2.693],[-44.591,2.372],[-45.031,1.954],[-45.378,1.456],[-45.617,0.898],[-45.739,0.304],[-45.739,-0.304],[-45.617,-0.898],[-45.378,-1.456],[-45.031,-1.954],[-44.591,-2.372],[-44.076,-2.693],[-43.507,-2.904],[-42.907,-2.996],[-42.3,-2.965],[-41.713,-2.813],[-41.168,-2.546],[-15.0,-11.297],[-14.284,-11.236],[-13.588,-11.055],[-12.933,-10.759],[-12.188,-10.229],[-11.691,-9.71],[-11.288,-9.114],[-11.067,-8.64],[-10.992,-8.459],[-10.811,-7.763],[-10.75,-7.047],[-10.75,7.047],[-10.811,7.763],[-10.992,8.459],[-11.288,9.114],[-11.691,9.71],[-12.337,10.356],[-12.933,10.759],[-13.588,11.055],[-14.284,11.236],[-15.0,11.297],[-15.716,11.236],[-16.412,11.055],[-16.594,10.98],[-17.067,10.759],[-17.663,10.356],[-18.182,9.859],[-18.712,9.114],[-19.008,8.459],[-19.189,7.763],[-19.25,7.047],[-19.25,-7.047],[-19.189,-7.763],[-19.008,-8.459],[-18.712,-9.114],[-18.309,-9.71],[-17.663,-10.356],[-17.067,-10.759],[-16.412,-11.055],[-15.716,-11.236],[15.217,-1.714],[15.512,-1.183],[15.693,-0.604],[15.755,0.0],[15.693,0.604],[15.512,1.183],[15.217,1.714],[14.822,2.174],[14.342,2.546],[13.797,2.813],[13.209,2.965],[12.603,2.996],[12.003,2.904],[11.433,2.693],[10.918,2.372],[10.478,1.954],[10.132,1.456],[9.892,0.898],[9.77,0.304],[9.77,-0.304],[9.892,-0.898],[10.132,-1.456],[10.478,-1.954],[10.918,-2.372],[11.433,-2.693],[12.003,-2.904],[12.603,-2.996],[13.209,-2.965],[13.797,-2.813],[14.342,-2.546],[14.822,-2.174]], [[0,1,2,3,4,5,6,7,8,9,10,11,12,13,14,15,16,17,18,19,20,21,22,23,24,25,26,27,28,29,30,31,32,33,34,35,36,37,38,39,40,41,42,43,44,45,46,47,48,49,50,51,52,53,54,55,56,57,58,59,60,61,62,63,64,65,66,67,68,69,70,71,72,73,74,75,76,77,78,79,80,81,82,83,84,85,86,87,88,89,90,91,92,93,94,95,96,97,98,99,100,101,102,103,104,105,106,107,108,109,110,111,112,113,114,115,116,117,118,119,120,121,122,123,124,125,126,127,128,129,130,131,132,133,134,135,136,137,138,139,140,141,142,143,144,145,146,147,148,149,150,151,152,153],[154,155,156,157,158,159,160,161,162,163,164,165,166,167,168,169,170,171,172,173,174,175,176,177,178,179,180,181,182,183,184],[185,186,187,188,189,190,191,192,193,194,195,196,197,198,199,200,201,202,203,204,205,206,207,208,209,210,211,212,213,214,215,216,217,218,219,220,221,222,223,224],[225,226,227,228,229,230,231,232,233,234,235,236,237,238,239,240,241,242,243,244,245,246,247,248,249,250,251,252,253,254,255]]]]],
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
