BrennenJohnston/custom-braille-embosser-v2/(list of files, cad)

Other CAD files:
Build_Files/3D_Printing_Files/Tactile_Assembly_Map/STL/Tactile_Assembly_Map_Plate_5_Base_Above.stl
Build_Files/3D_Printing_Files/Tactile_Assembly_Map/STL/Tactile_Assembly_Map_Plate_6_Base_Below.stl
Build_Files/3D_Printing_Files/Tactile_Assembly_Map/STL/Tactile_Assembly_Map_Plate_2_Roller_B.stl
Build_Files/3D_Printing_Files/STL/Top_Gear_B.stl
Build_Files/3D_Printing_Files/Tactile_Assembly_Map/tactile_assembly_map_shapes.scad
Build_Files/3D_Printing_Files/Embossing_Plates_Customizer/MakerWorld_Customizer/Braille_Cylinder_STL_Generator_MakerWorld_v2.scad
Build_Files/3D_Printing_Files/Embossing_Plates_Customizer/MakerWorld_Customizer/Braille_Cylinder_STL_Generator_MakerWorld_v2_Fixed_Gears.scad
Build_Files/3D_Printing_Files/Embossing_Plates_Customizer/OpenSCAD_Offline_Alternative/Braille_Cylinder_STL_Generator_EmbosserV2.scad
