BrennenJohnston/custom-braille-embosser-v2/Documentation/Step_2_Guide_Option_1_Custom_Braille_Embosser_V2_Visual_Assembly_Guide.md

# Visual Assembly Guide

The build of the Custom Braille Embosser, Version 2, as pictures only, in the order of the Maker Guide's steps; the words are in the Maker Guide and the Assembly Guide By Touch.

## 1. Parts

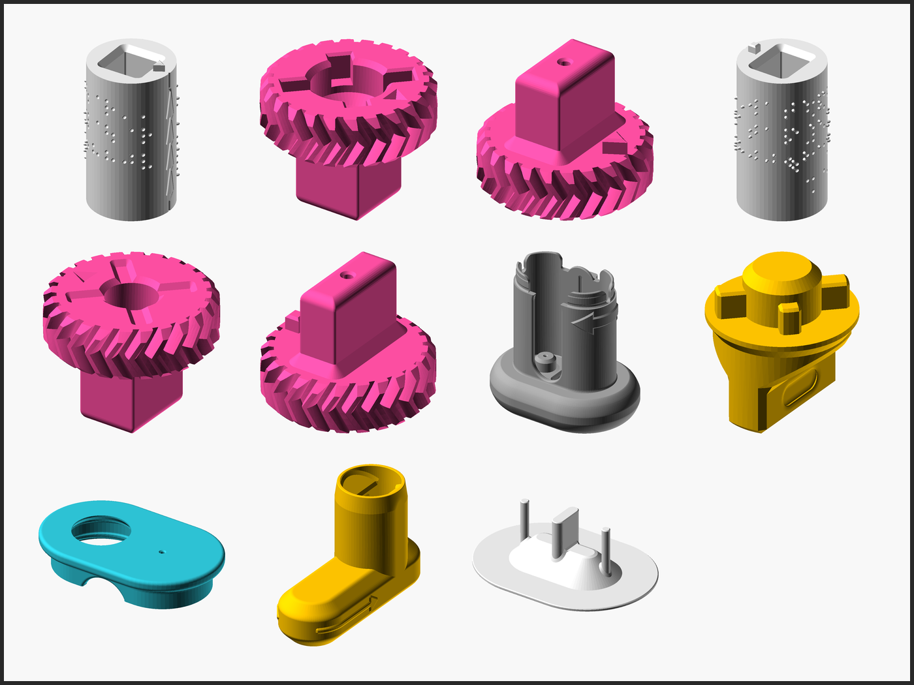
[picture p50: Photos/visual/visual-parts.png]
Every part, one of each, in the order they are used: Cylinder A, Top Gear A, Bottom Gear A, Cylinder B, Top Gear B, Bottom Gear B, Base, Knob, Lid, Handle and Push-out Plate.


The Push-out Plate, last in the row, is optional and is not used in the twelve steps: it lifts the rollers out when the message is changed.

## 2. Steps

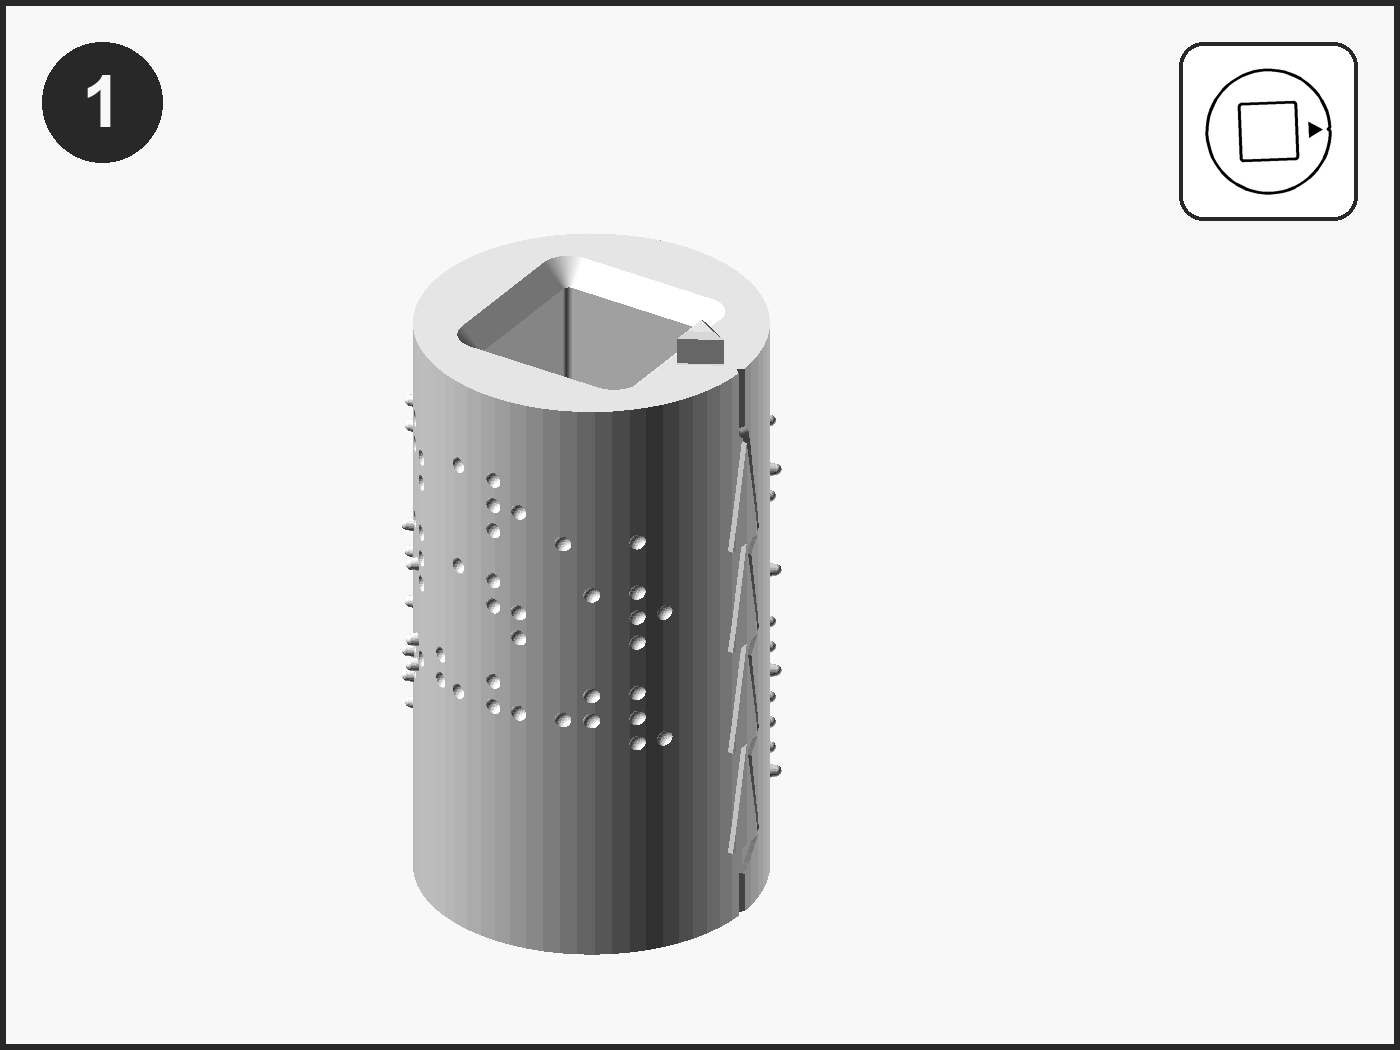
[picture p51: Photos/visual/visual-step-01.png]
Step 1: Cylinder A standing on its own, top up. The box sketches its top end: a square keyhole outline with a filled triangle bump beside it.


Step 2: Top Gear A held above Cylinder A, peg down; a red dashed arrow runs from the peg down to the keyhole. The box sketches the gear's hub side (a keyed pocket with four keyways, and the hub-face triangle mark) and its peg side (a filled square peg with a triangle notch outline), then under a re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

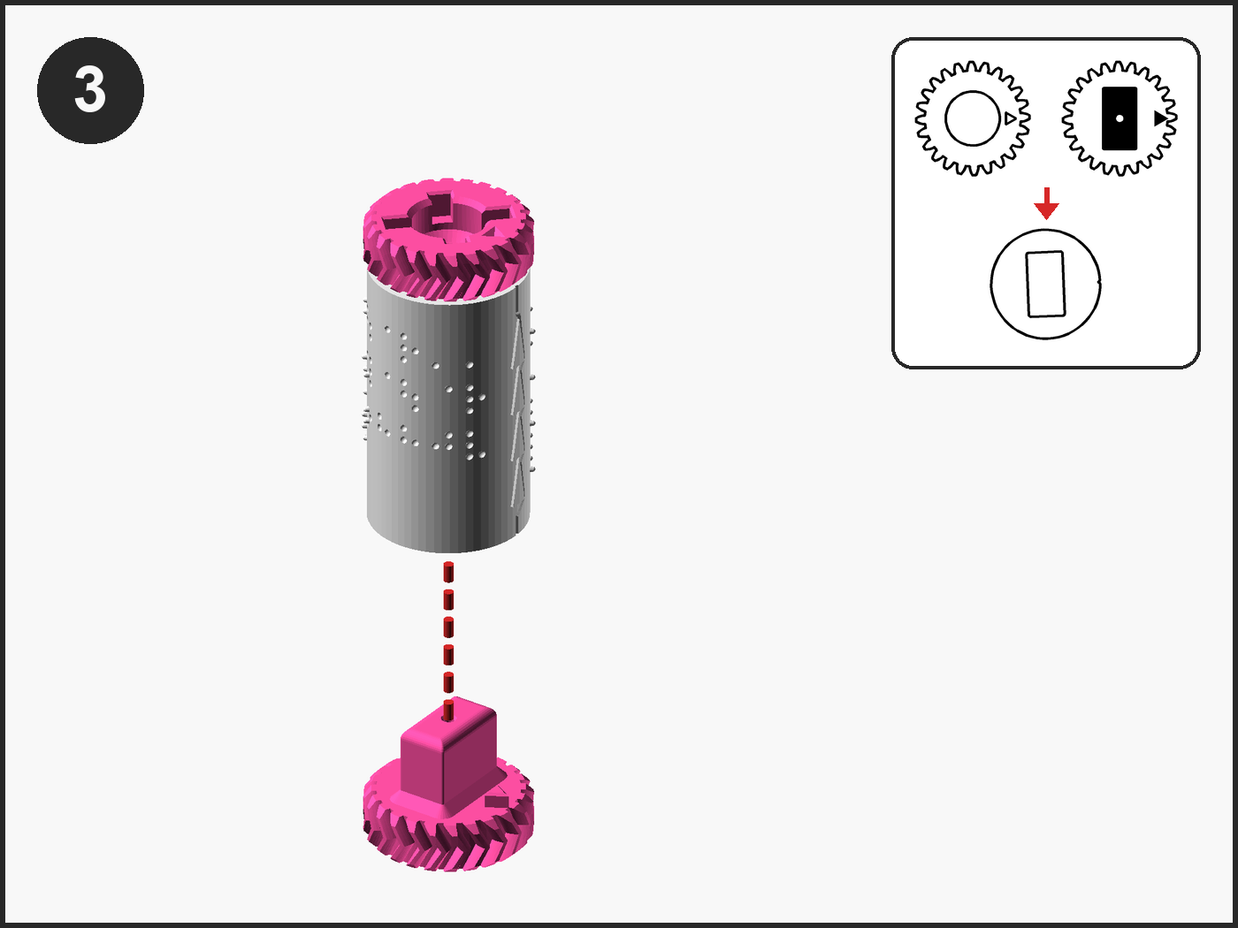
[picture p52: Photos/visual/visual-step-03.png]
Step 3: Roller A turned over, Bottom Gear A below it with its peg up; a red dashed arrow runs up into the bottom keyhole. The box sketches the gear's hub side (a wide round pocket, and the hub-face triangle mark) and its peg side (a filled 18 by 10 peg with a filled triangle stud), then Cylinder A'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


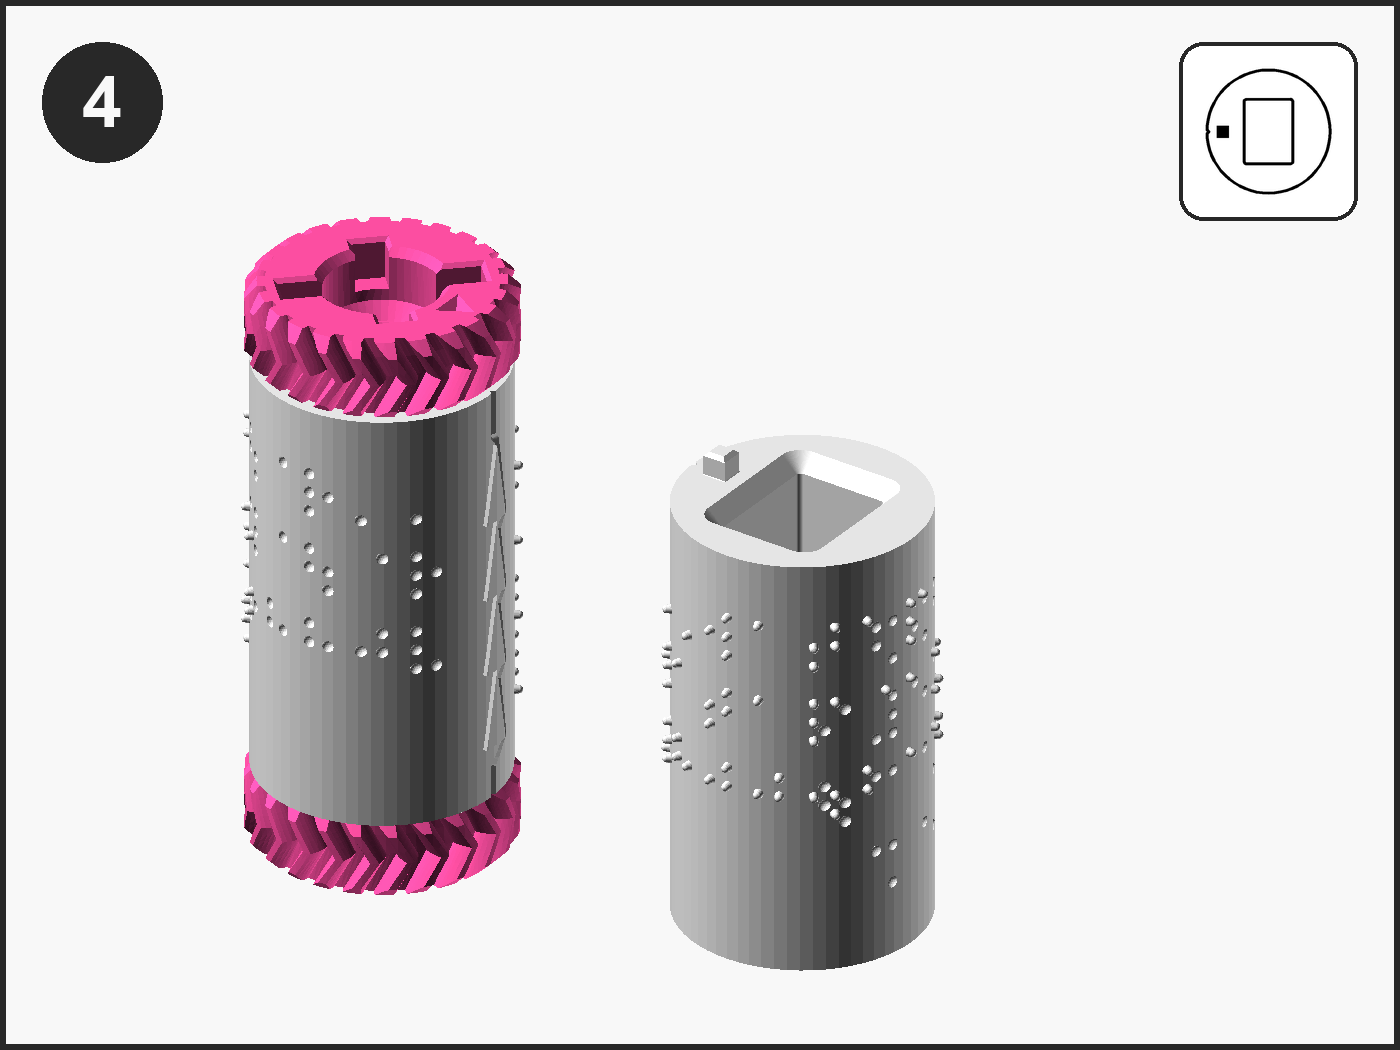
[picture p53: Photos/visual/visual-step-04.png]
Step 4: Cylinder B standing beside Roller A, top up. The box sketches its top end: a rectangular keyhole outline with a filled square bump beside it.


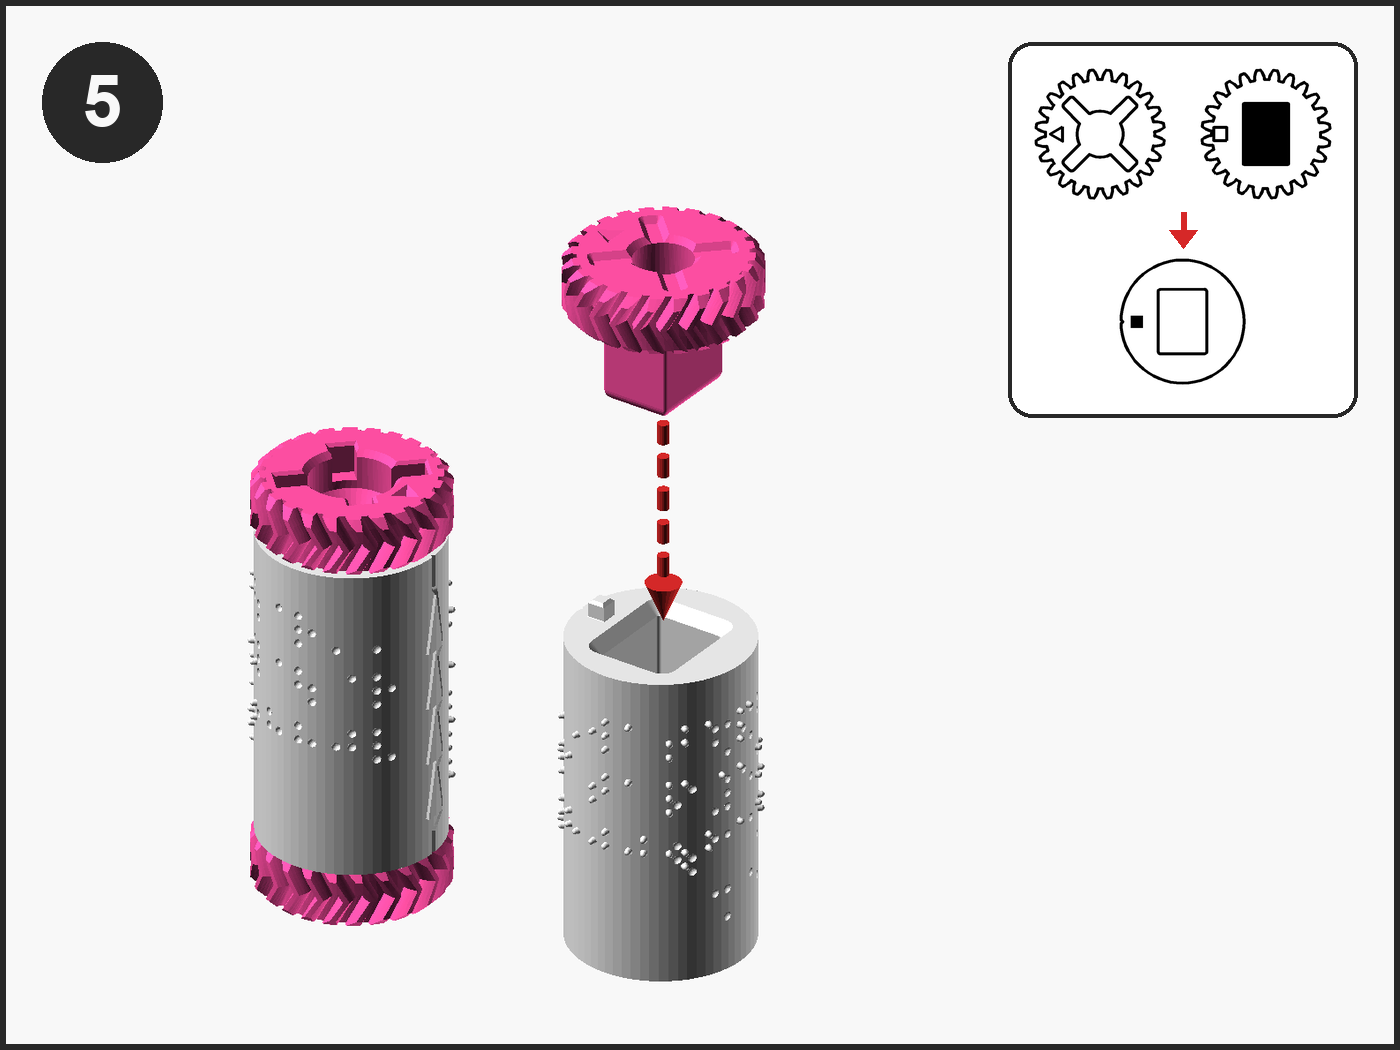
[picture p54: Photos/visual/visual-step-05.png]
Step 5: Top Gear B above Cylinder B, peg down; a red dashed arrow runs down to the keyhole. The box sketches the gear's hub side (a small pocket with a cross of grooves, and the hub-face triangle mark) and its peg side (a filled 16 by 12 peg with a square notch outline), then Cylinder B's top end w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


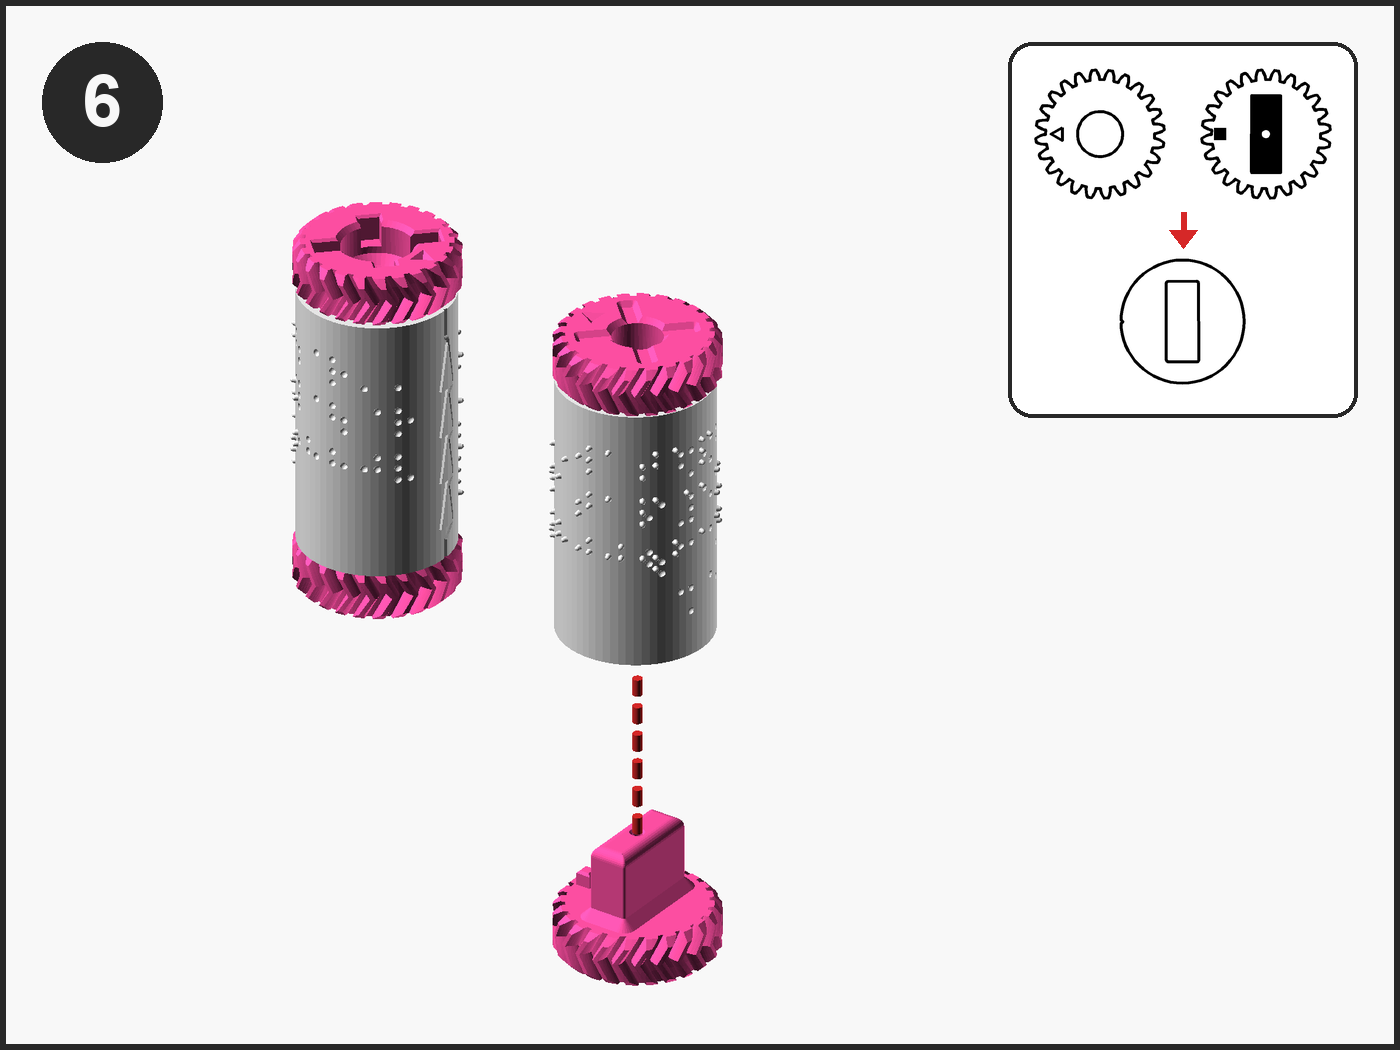
[picture p55: Photos/visual/visual-step-06.png]
Step 6: Bottom Gear B below Roller B, peg up; a red dashed arrow runs up to the bottom keyhole. The box sketches the gear's hub side (a plain small pocket, and the hub-face triangle mark) and its peg side (a filled 20 by 8 bar peg with a filled square stud), then Cylinder B's bottom end with its ke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


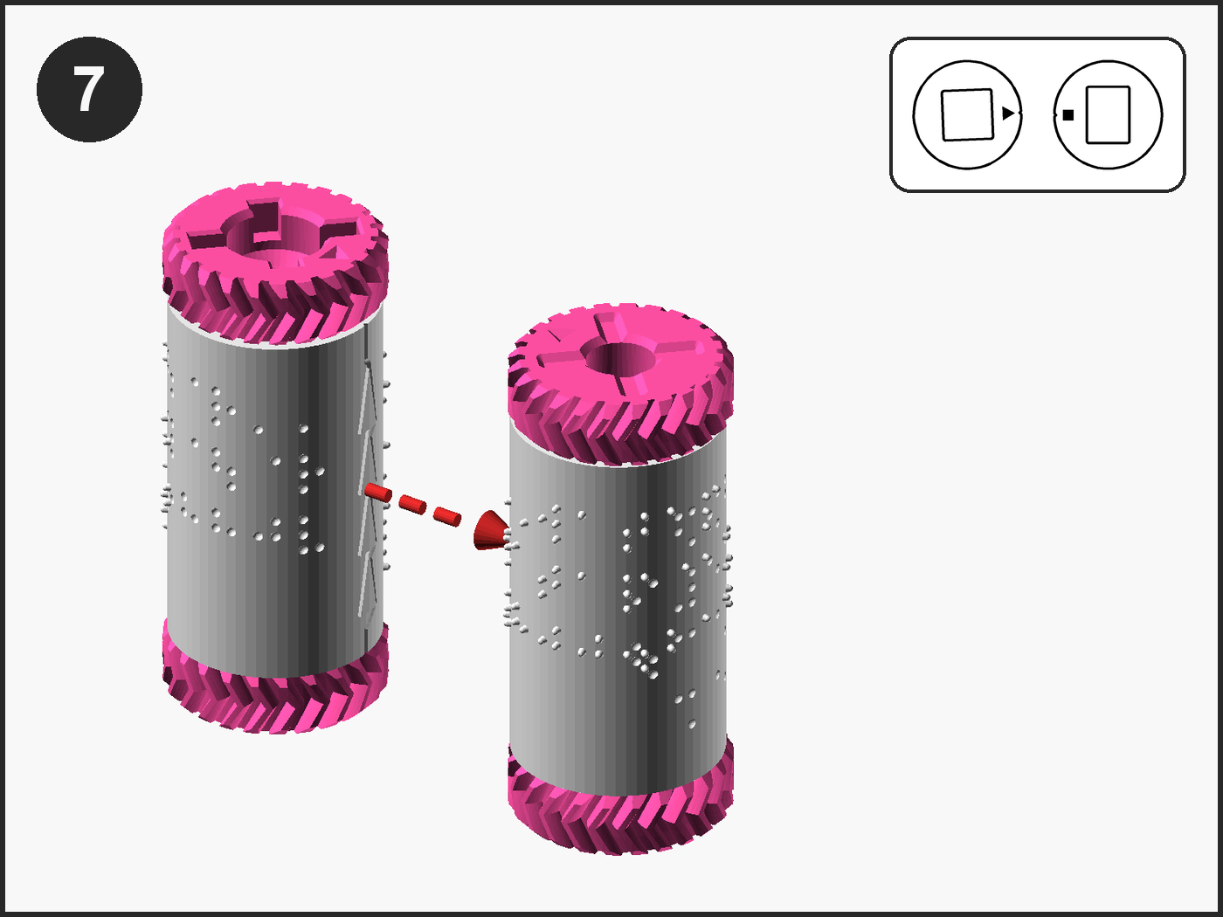
[picture p56: Photos/visual/visual-step-07.png]
Step 7: Roller A to the left of Roller B; a red dashed arrow runs from Roller A to Roller B. The box sketches the two cylinders' top ends side by side, Cylinder A's filled triangle on its right and Cylinder B's filled square on its left, facing each other.


![Step 8: the paired rollers above the Base, Roller A on the left and the join between the cylinders toward you, the Base's window toward you; two red dashed arrows run down into the Base's open top. The box sketches the two bottom gears' hub sides (the wide pocket and the small pocket), then under a red arrow the Base from above: the floor with its slot and two holes, the two filled posts, the fatter one on the left.](../Photos/visual/visual-step-08.png)

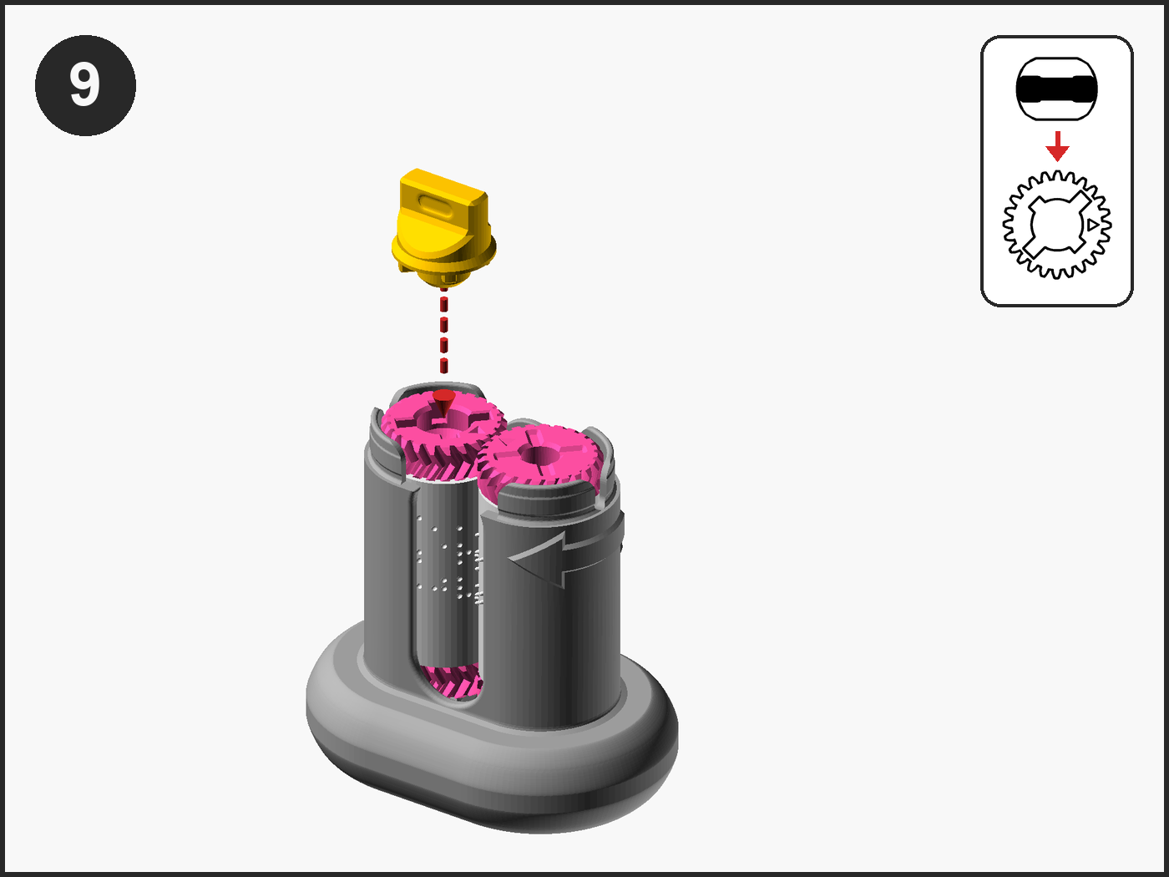
[picture p57: Photos/visual/visual-step-09.png]
Step 9: the Knob above the left top gear, shaft down; a red dashed arrow runs down into the gear's pocket. The box sketches the Knob from above (a D shape with a filled tab across it), then under a red arrow Top Gear A's hub side with its keyed pocket.


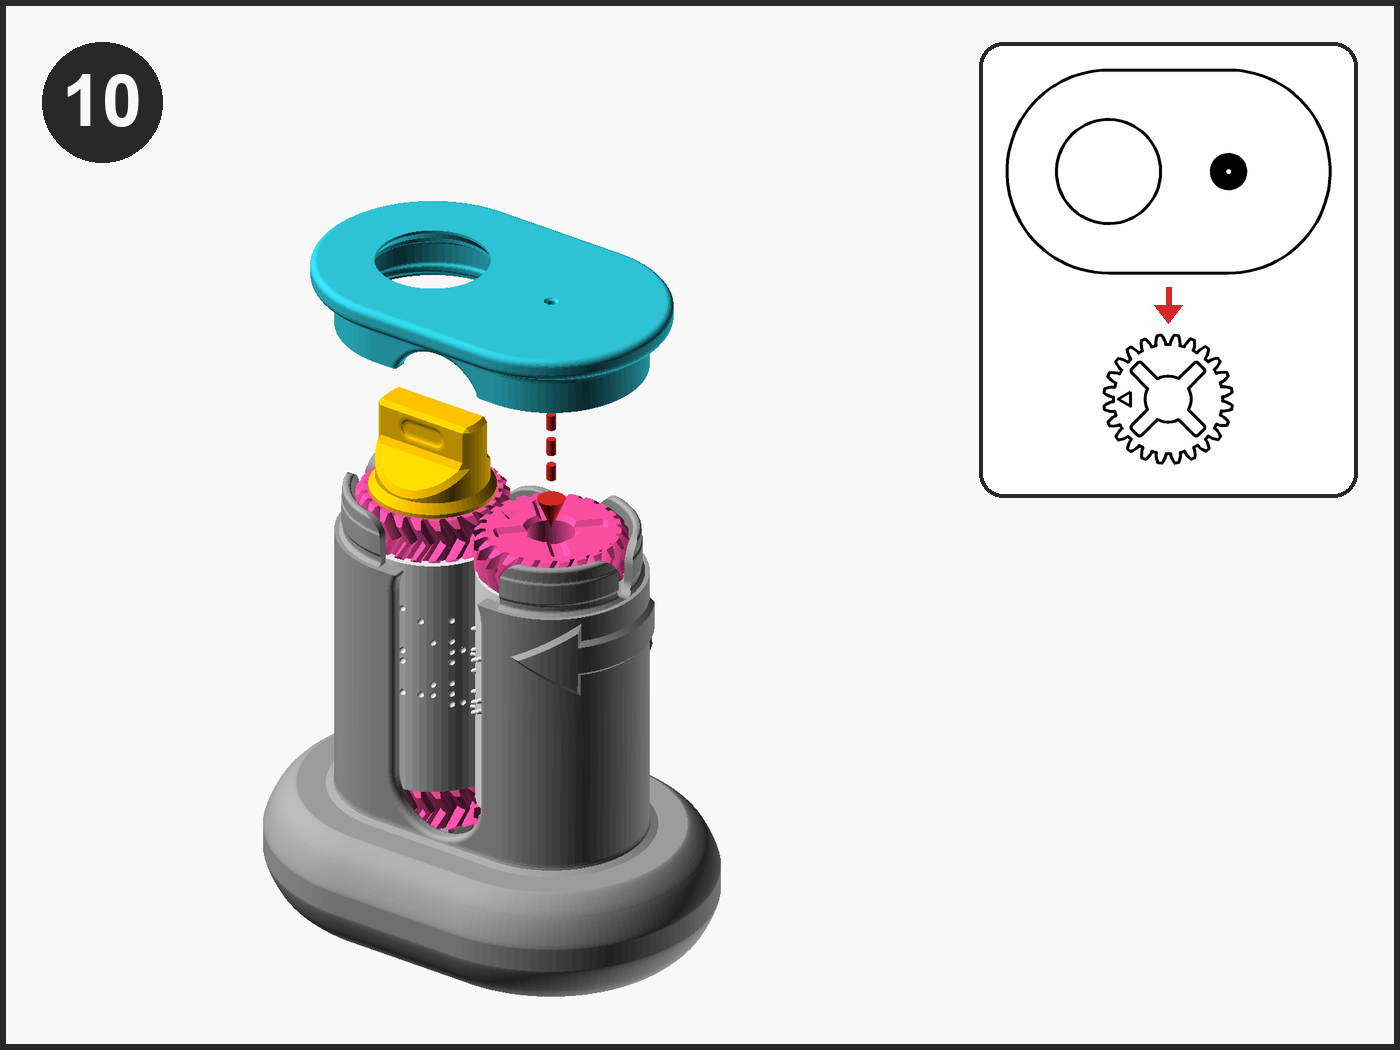
[picture p58: Photos/visual/visual-step-10.png]
Step 10: the Lid above the Base, post down, its hole over the Knob; a red dashed arrow runs down to the right top gear. The box sketches the Lid from above (an oval with the Knob hole and a filled post), then under a red arrow Top Gear B's hub side with its small pocket.


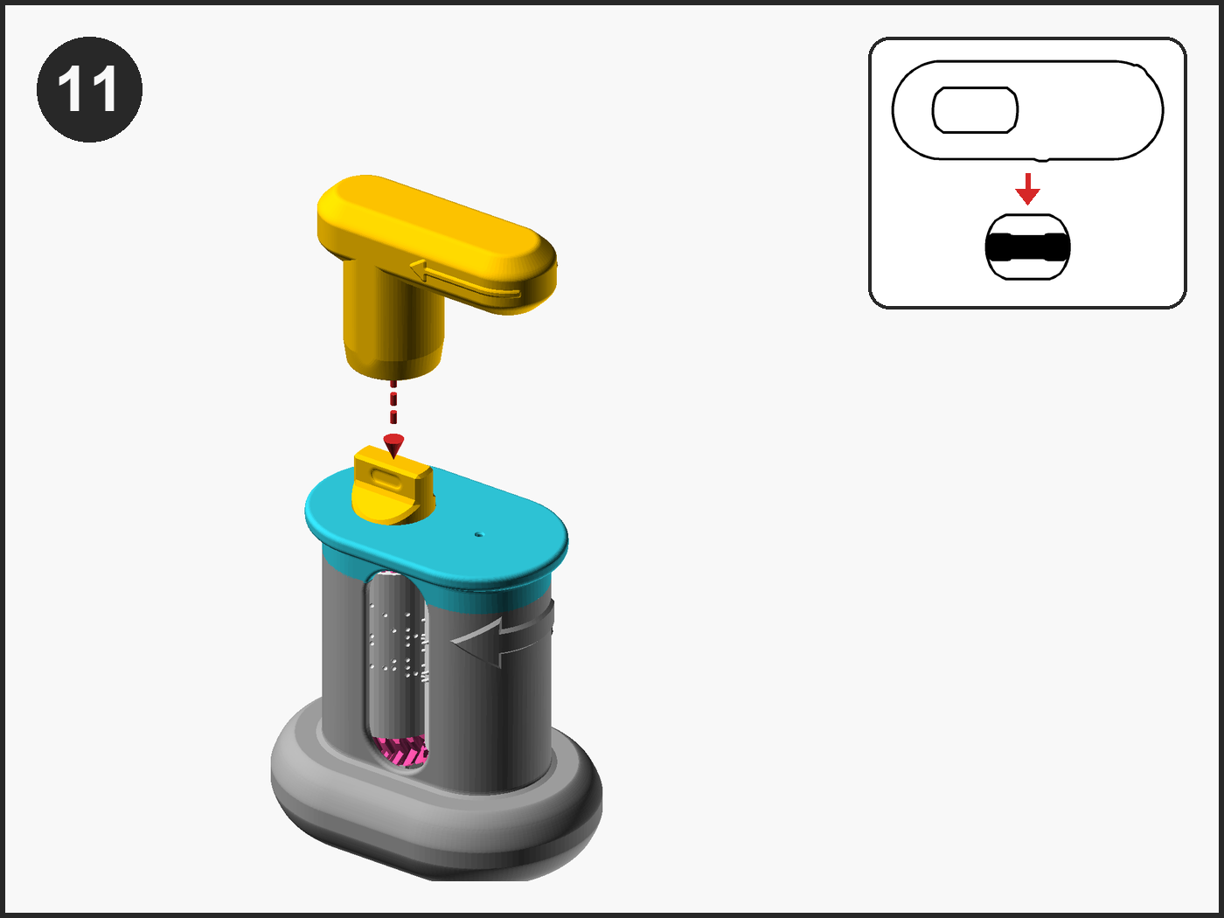
[picture p59: Photos/visual/visual-step-11.png]
Step 11: the Handle above the Knob, cup down, grip to the right; a red dashed arrow runs down to the Knob. The box sketches the Handle from above (the grip and the cup with its keyhole outline), then under a red arrow the Knob from above with its filled tab.


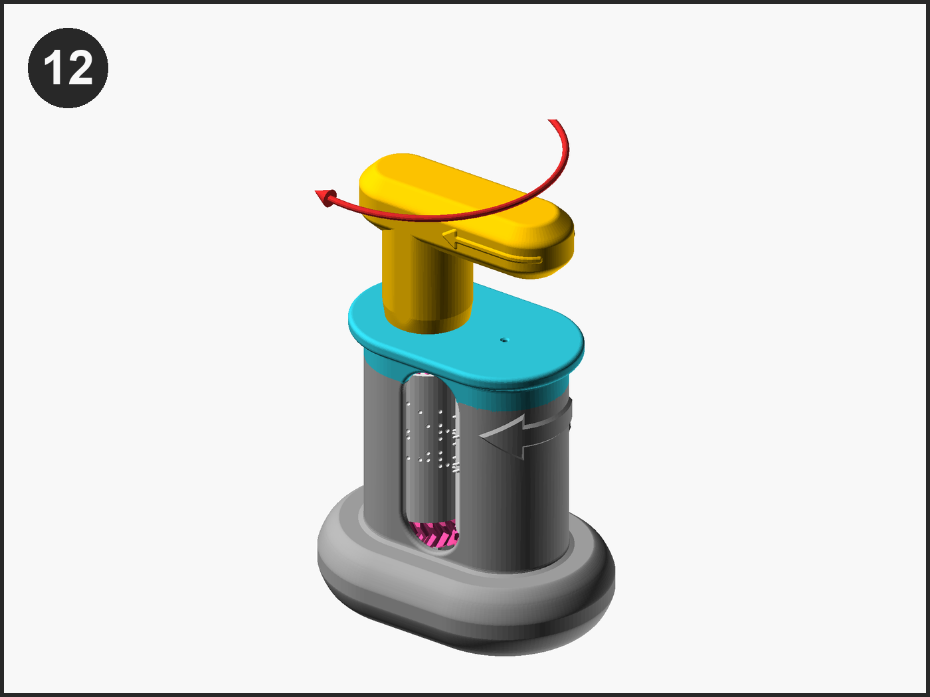
[picture p60: Photos/visual/visual-step-12.png]
Step 12: the finished embosser; a curved red arrow over the Handle shows a clockwise turn.
