BrennenJohnston/custom-braille-embosser-v2/Documentation/Step_2_Guide_Option_1_Custom_Braille_Embosser_V2_Visual_Assembly_Guide.pdf

### CUSTOM BRAILLE EMBOSSER · VERSION 2

# Visual Assembly Guide

The build of the Custom Braille Embosser, Version 2, as pictures only, in the order of the

## Maker Guide's steps; the words are in the Maker Guide and the Assembly Guide By

Touch.

# 1. Parts

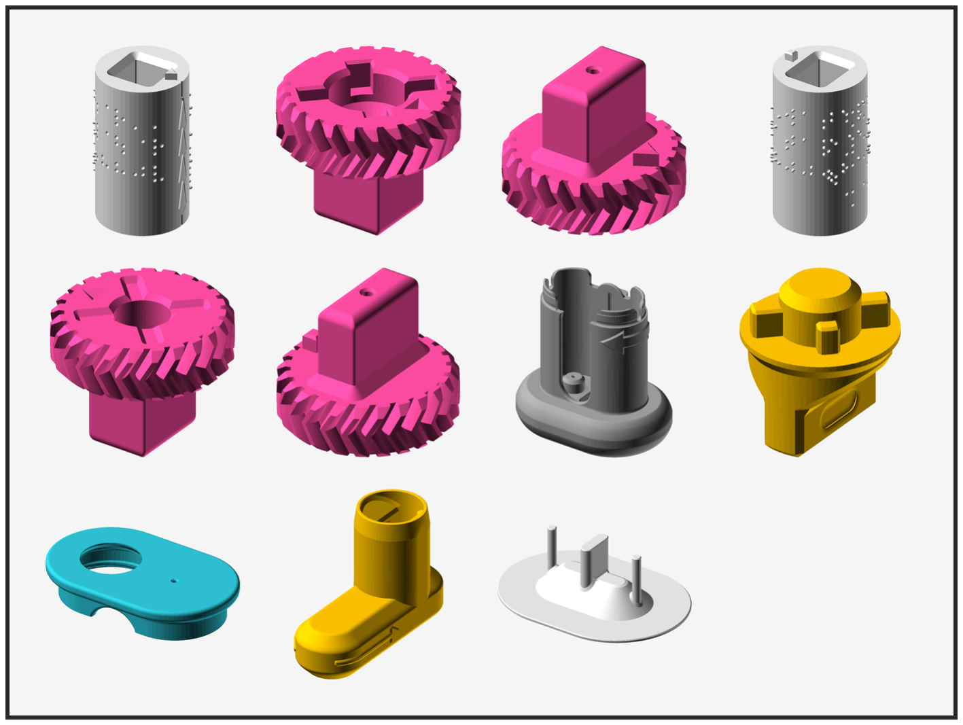
[picture p125: figure]

The Push-out Plate, last in the row, is optional and is not used in the twelve steps: it lifts the rollers out when the message is changed.

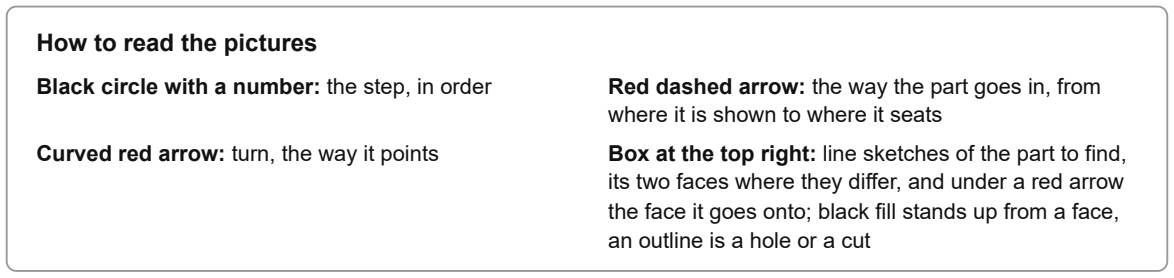
[picture p126: figure]
How to read the pictures; where it is shown to where it seats; an outline is a hole or a cut

Black circle with a number: the step, in order | Red dashed arrow: the way the part goes in, from
Curved red arrow: turn, the way it points | Box at the top right: line sketches of the part to find, its two faces where they differ, and under a red arrow the face it goes onto; black fill stands up from a face,

Model version 2.0.0. Online, with the printable files and the cylinder generator: github.com/BrennenJohnston/custom-braille-embosser-v2

# 2. Steps

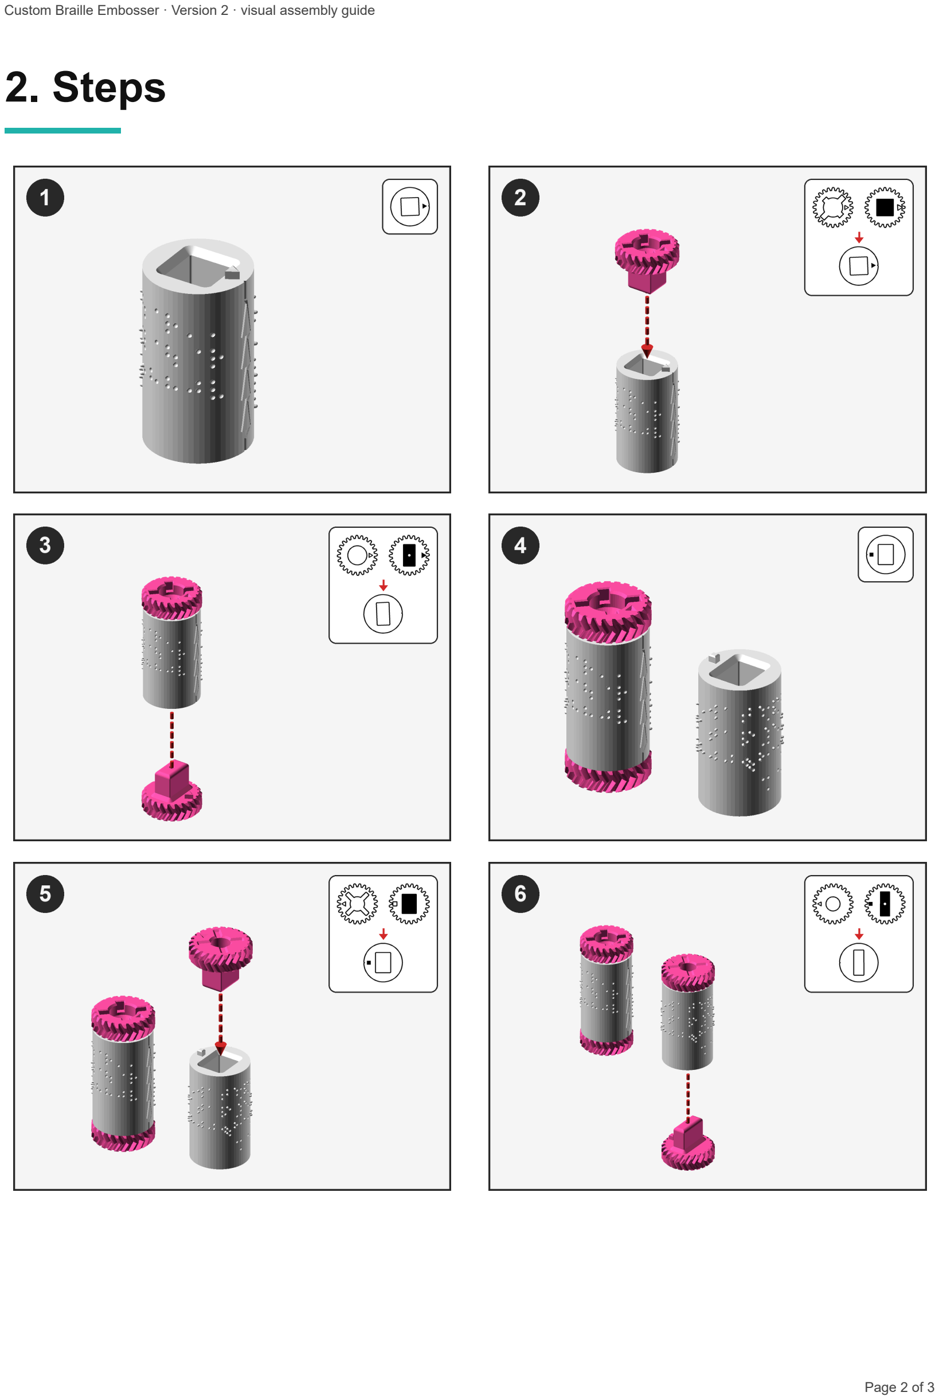
[picture p127: page 2]

Custom Braille Embosser · Version 2 · visual assembly guide

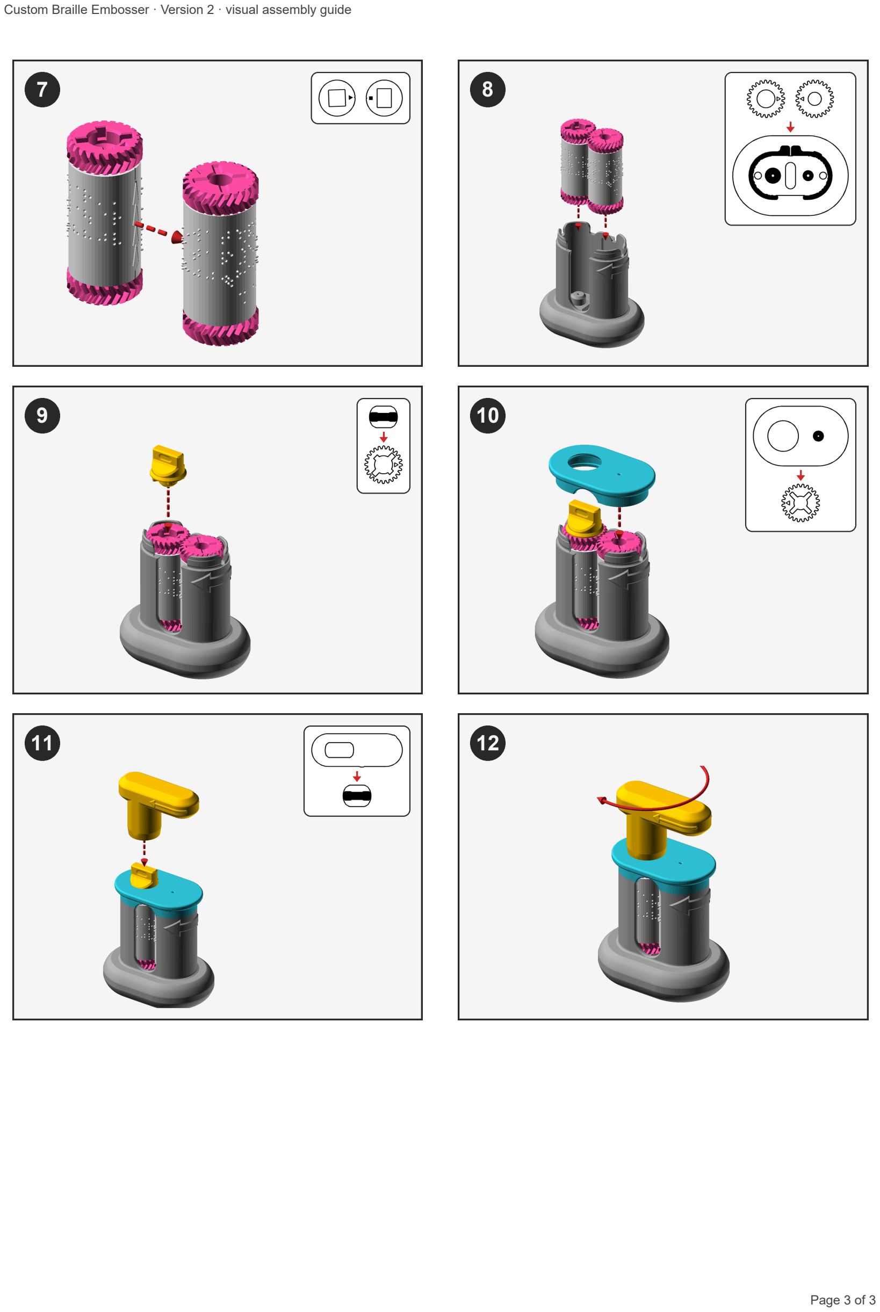
[picture p128: page 3]

Custom Braille Embosser · Version 2 · visual assembly guide
