BrennenJohnston/custom-braille-embosser-v2/MakerWorld_Photos/Cover/1_desktop_4x3.jpg

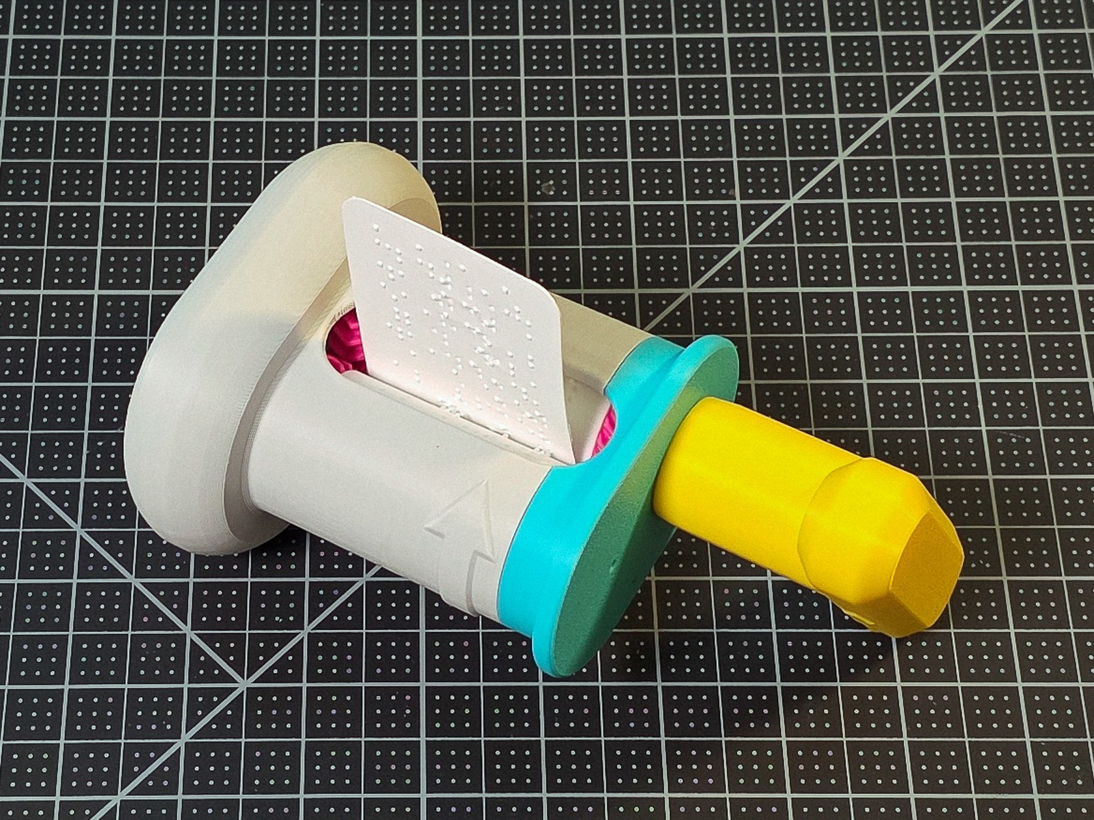
MakerWorld_Photos/Cover/1_desktop_4x3.jpg
