BrennenJohnston/custom-braille-embosser-v2/MakerWorld_Photos/Cover/2_mobile_3x4.jpg

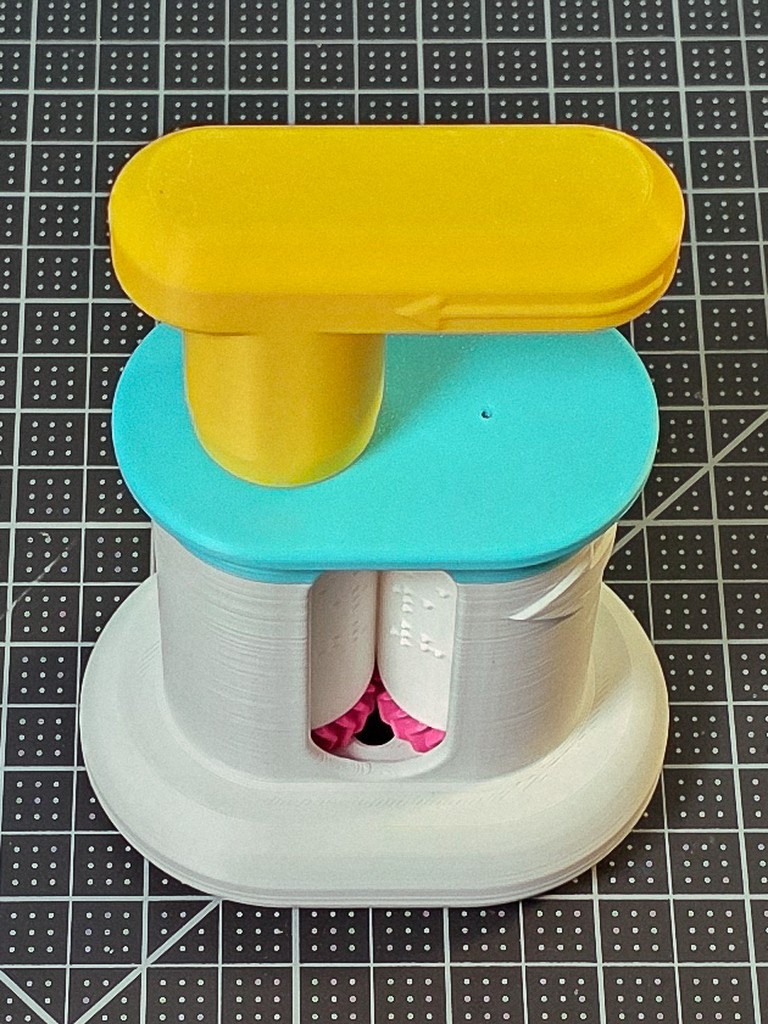
MakerWorld_Photos/Cover/2_mobile_3x4.jpg
