BrennenJohnston/custom-braille-embosser-v2/MakerWorld_Photos/Real_Photos/01_front.jpg

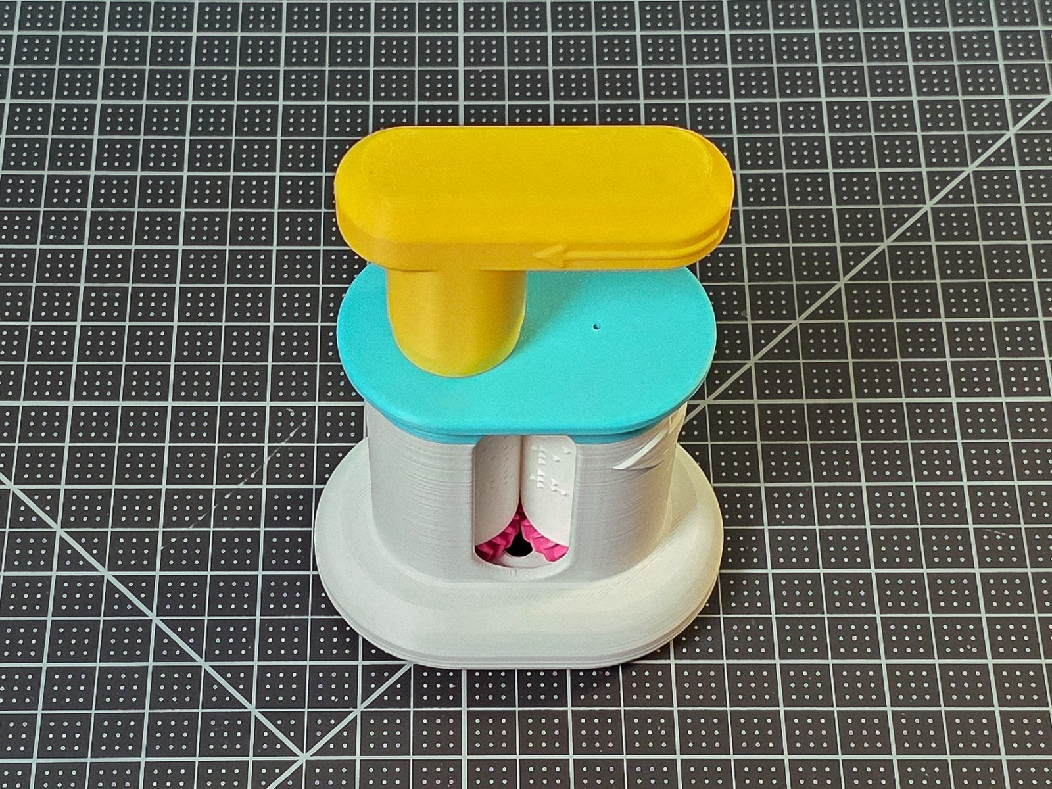
MakerWorld_Photos/Real_Photos/01_front.jpg
