BrennenJohnston/custom-braille-embosser-v2/MakerWorld_Photos/Real_Photos/02_side.jpg

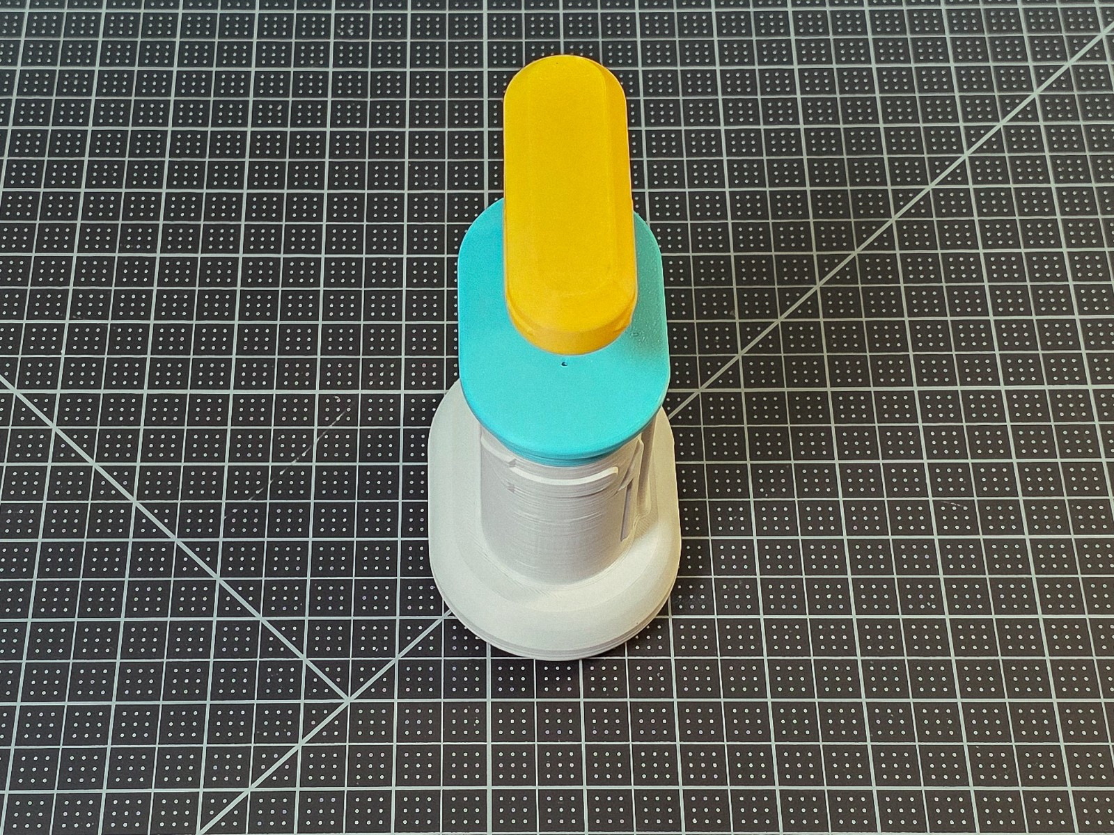
MakerWorld_Photos/Real_Photos/02_side.jpg
