BrennenJohnston/custom-braille-embosser-v2/MakerWorld_Photos/Real_Photos/03_back.jpg

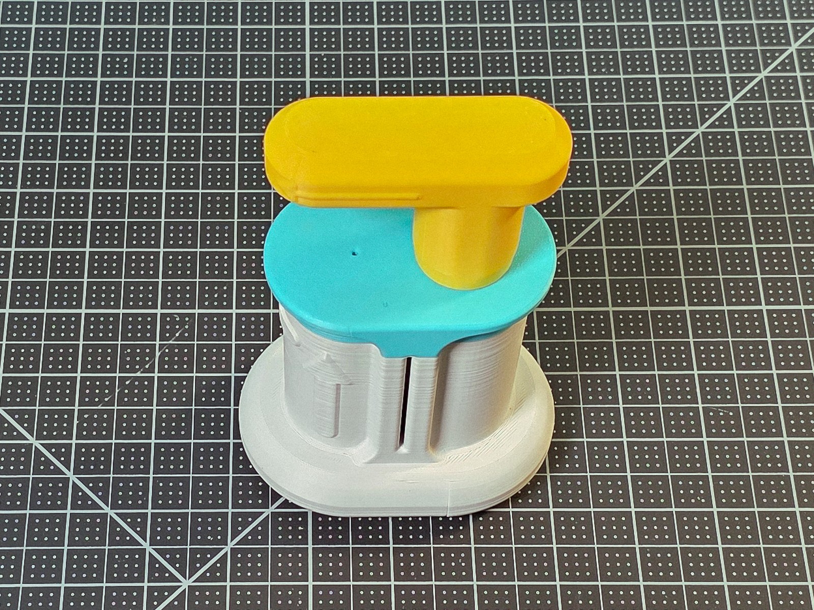
MakerWorld_Photos/Real_Photos/03_back.jpg
