BrennenJohnston/custom-braille-embosser-v2/MakerWorld_Photos/Real_Photos/04_underside.jpg

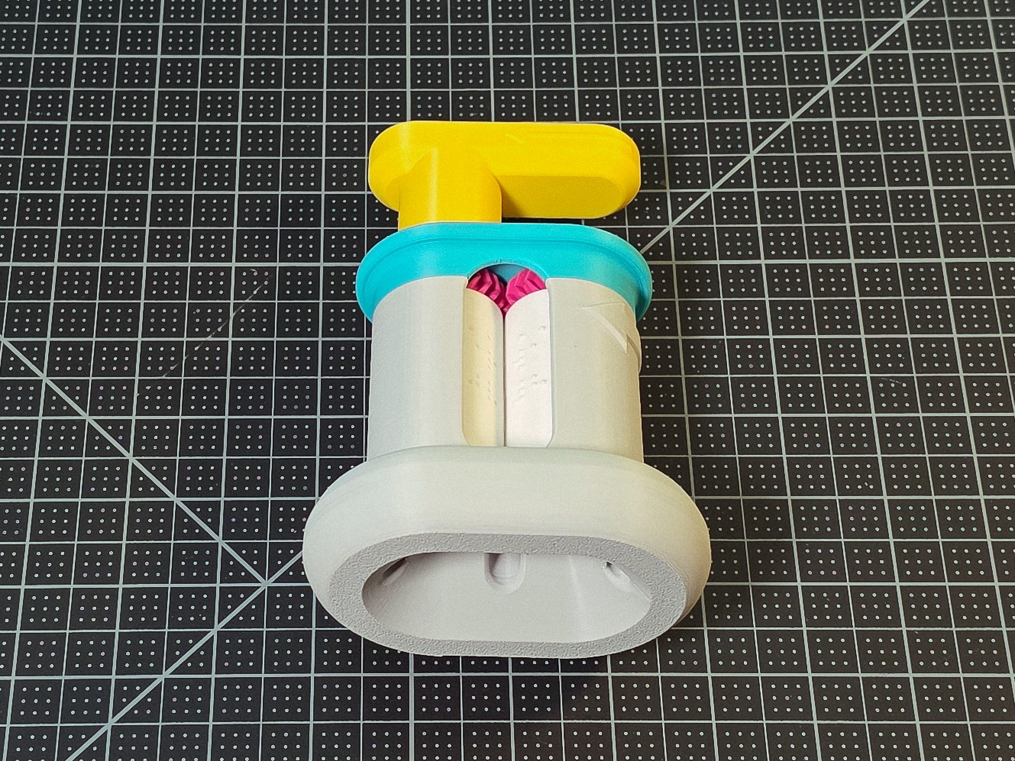
MakerWorld_Photos/Real_Photos/04_underside.jpg
