BrennenJohnston/custom-braille-embosser-v2/MakerWorld_Photos/Real_Photos/05_embossed_card.jpg

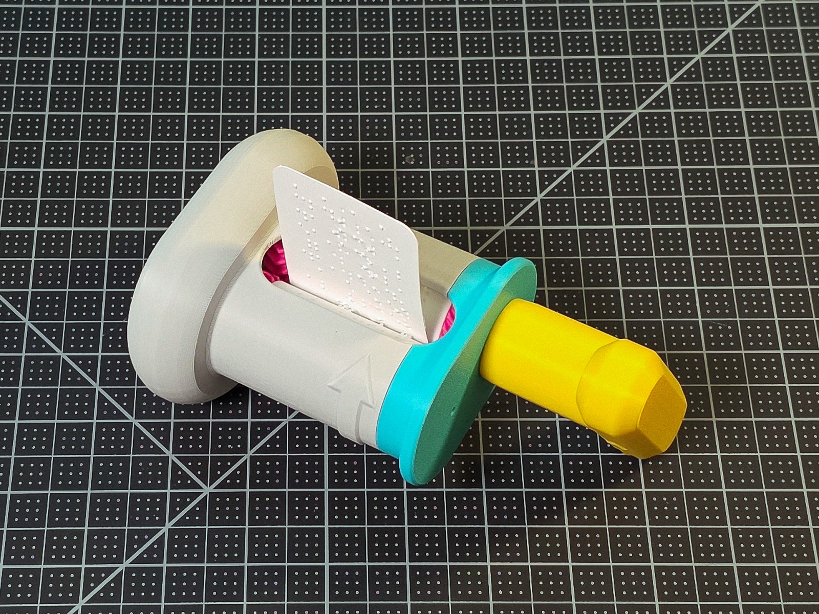
MakerWorld_Photos/Real_Photos/05_embossed_card.jpg
