BrennenJohnston/custom-braille-embosser-v2/MakerWorld_Photos/Real_Photos/07_first_cylinder_gears.jpg

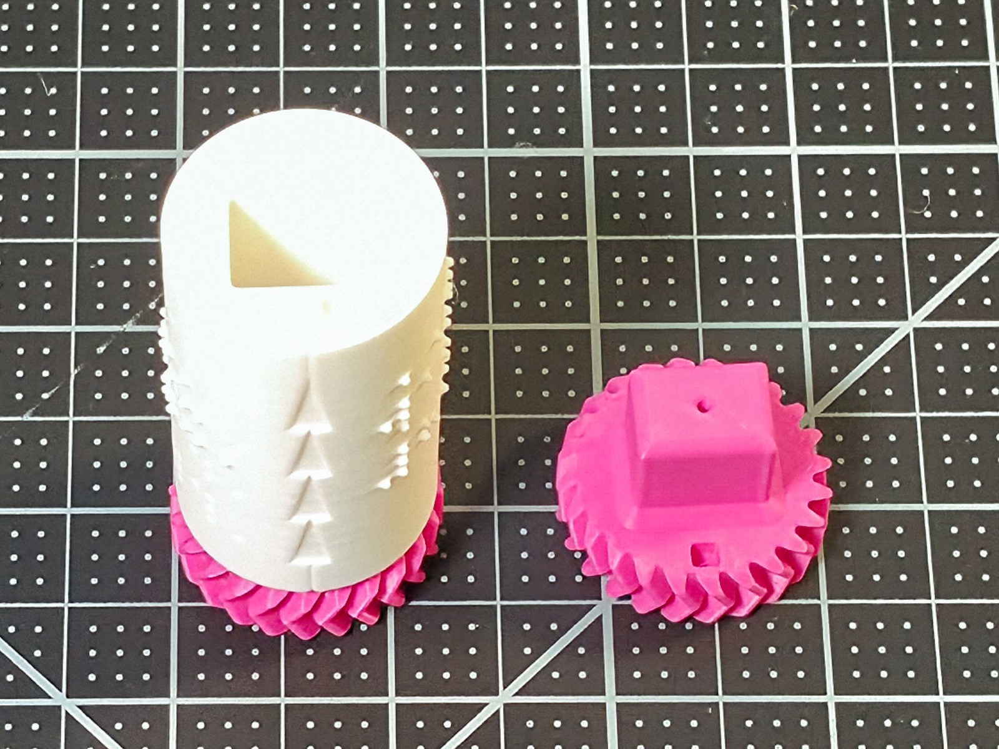
MakerWorld_Photos/Real_Photos/07_first_cylinder_gears.jpg
