BrennenJohnston/custom-braille-embosser-v2/MakerWorld_Photos/Real_Photos/08_second_cylinder_gears.jpg

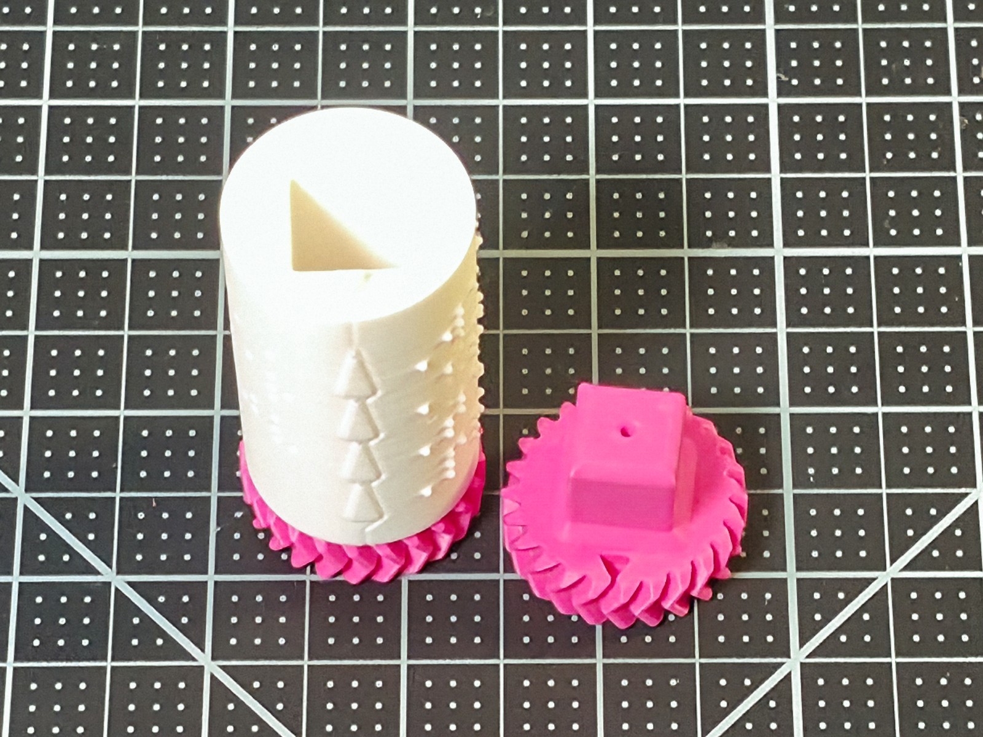
MakerWorld_Photos/Real_Photos/08_second_cylinder_gears.jpg
