BrennenJohnston/custom-braille-embosser-v2/MakerWorld_Photos/Real_Photos/09_rollers_beside_base.jpg

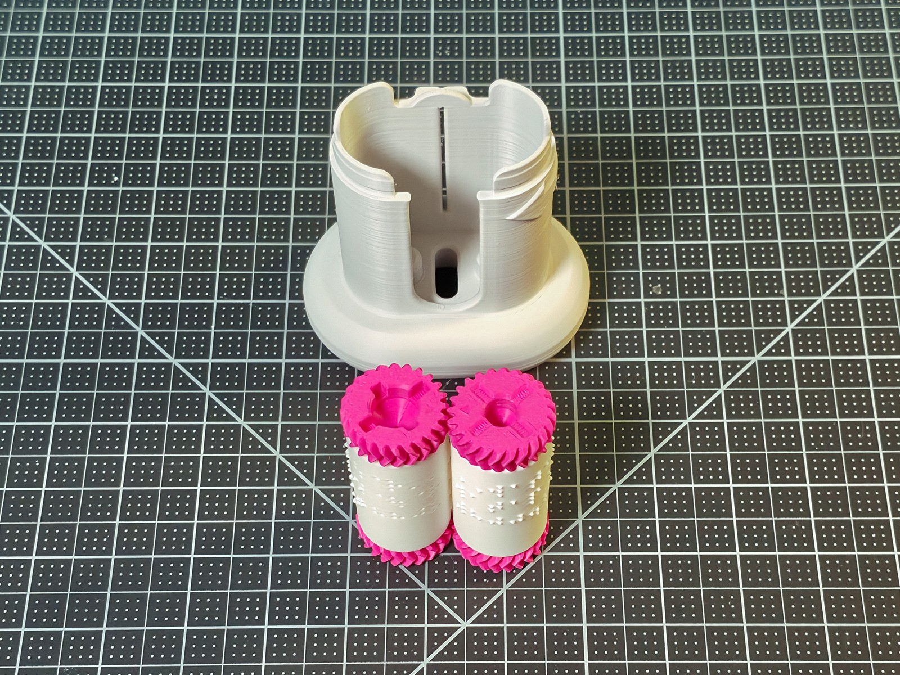
MakerWorld_Photos/Real_Photos/09_rollers_beside_base.jpg
