BrennenJohnston/custom-braille-embosser-v2/MakerWorld_Photos/Real_Photos/10_knob_on_lid_beside.jpg

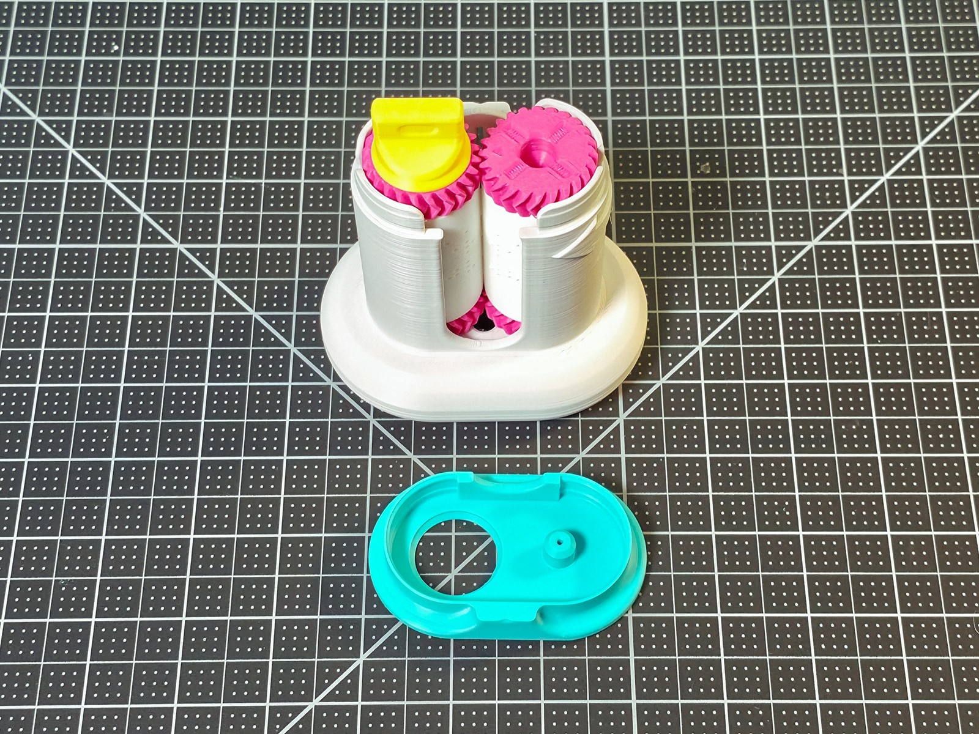
MakerWorld_Photos/Real_Photos/10_knob_on_lid_beside.jpg
