BrennenJohnston/custom-braille-embosser-v2/MakerWorld_Photos/Real_Photos/11_handle_beside.jpg

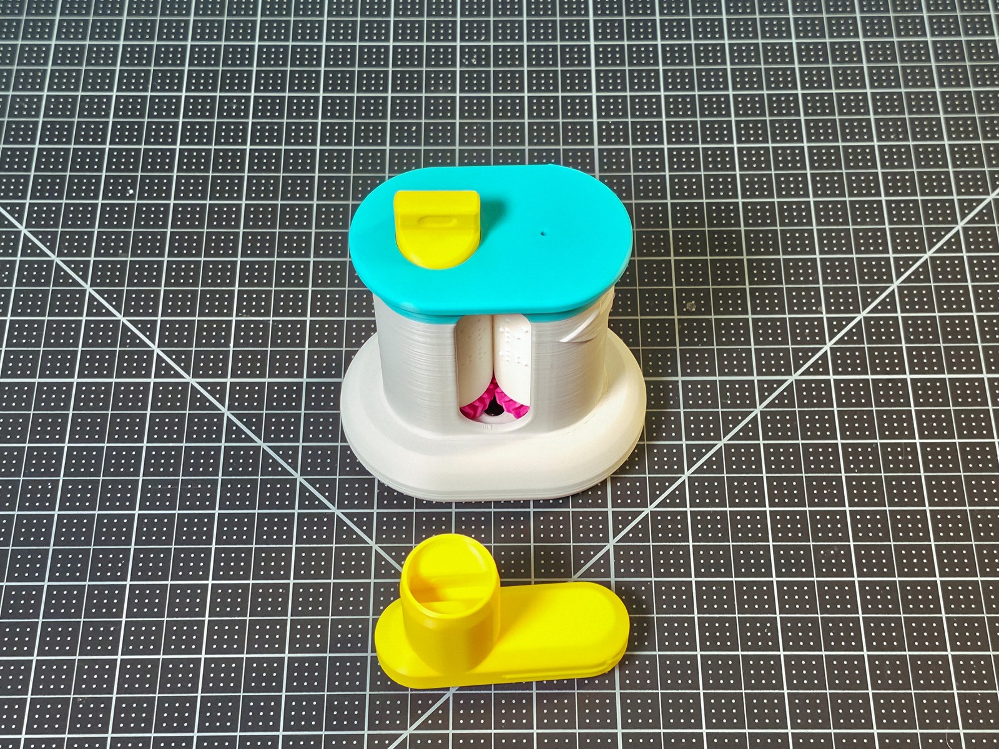
MakerWorld_Photos/Real_Photos/11_handle_beside.jpg
