BrennenJohnston/custom-braille-embosser-v2/MakerWorld_Photos/Real_Photos/12_complete_fused_rollers.jpg

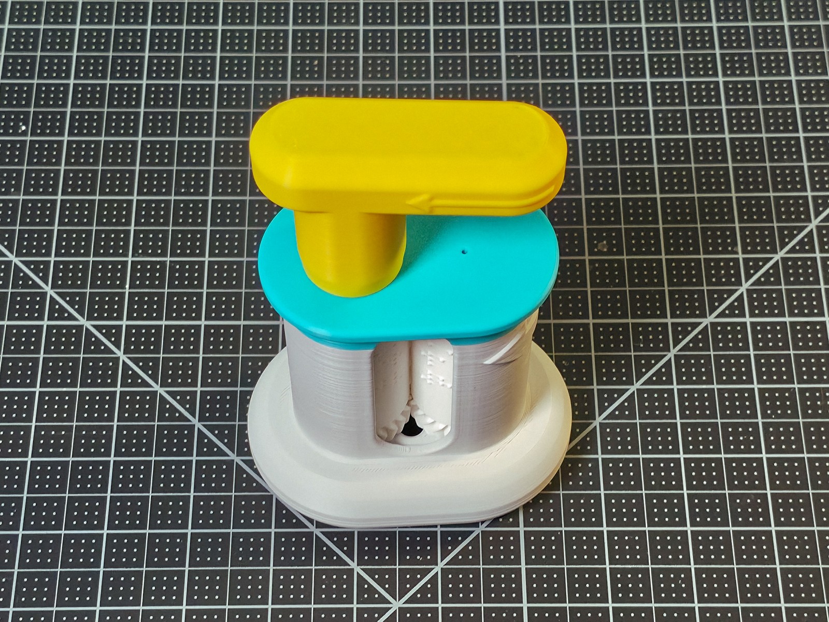
MakerWorld_Photos/Real_Photos/12_complete_fused_rollers.jpg
