BrennenJohnston/custom-braille-embosser-v2/MakerWorld_Photos/Real_Photos/13_tactile_map_all.jpg

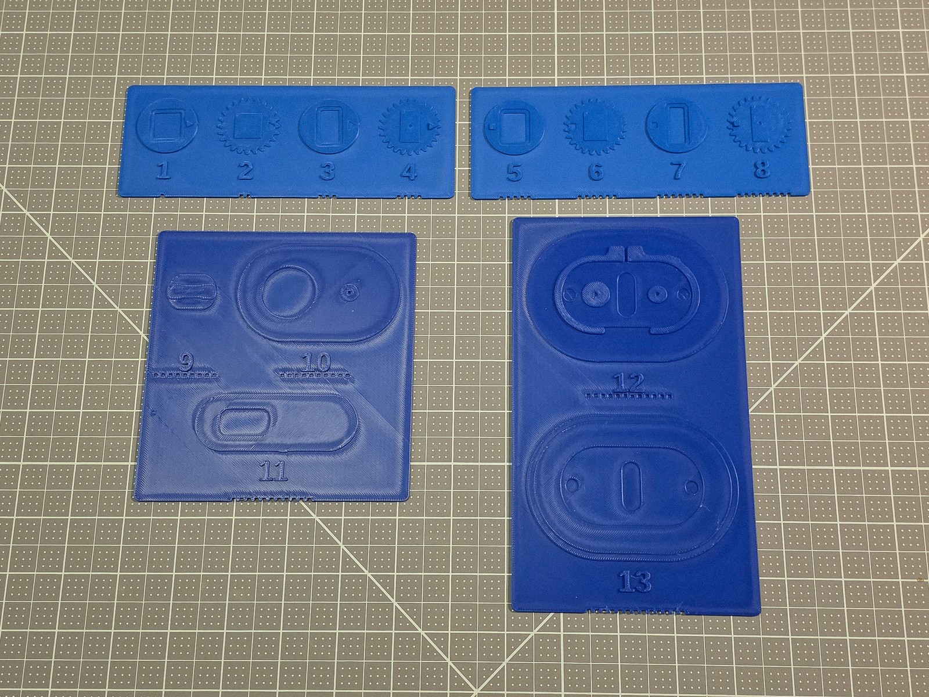
MakerWorld_Photos/Real_Photos/13_tactile_map_all.jpg
