BrennenJohnston/custom-braille-embosser-v2/MakerWorld_Photos/Real_Photos/14_tactile_map_1_to_4.jpg

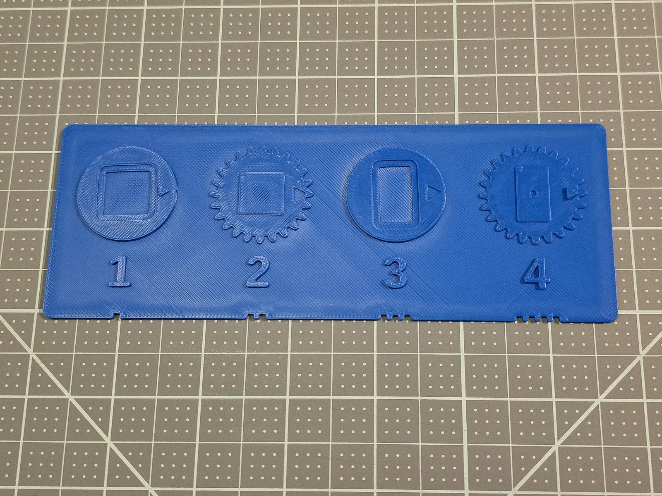
MakerWorld_Photos/Real_Photos/14_tactile_map_1_to_4.jpg
