BrennenJohnston/custom-braille-embosser-v2/MakerWorld_Photos/Real_Photos/15_tactile_map_5_to_8.jpg

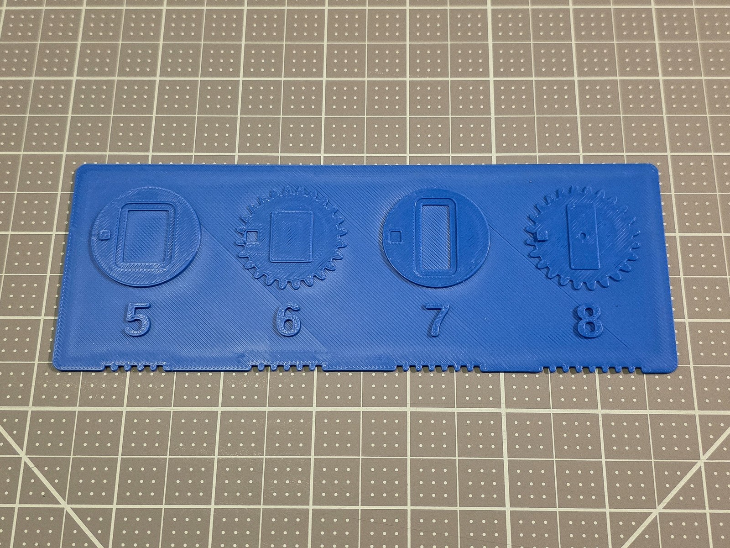
MakerWorld_Photos/Real_Photos/15_tactile_map_5_to_8.jpg
