BrennenJohnston/custom-braille-embosser-v2/MakerWorld_Photos/Real_Photos/16_tactile_map_9_to_11.jpg

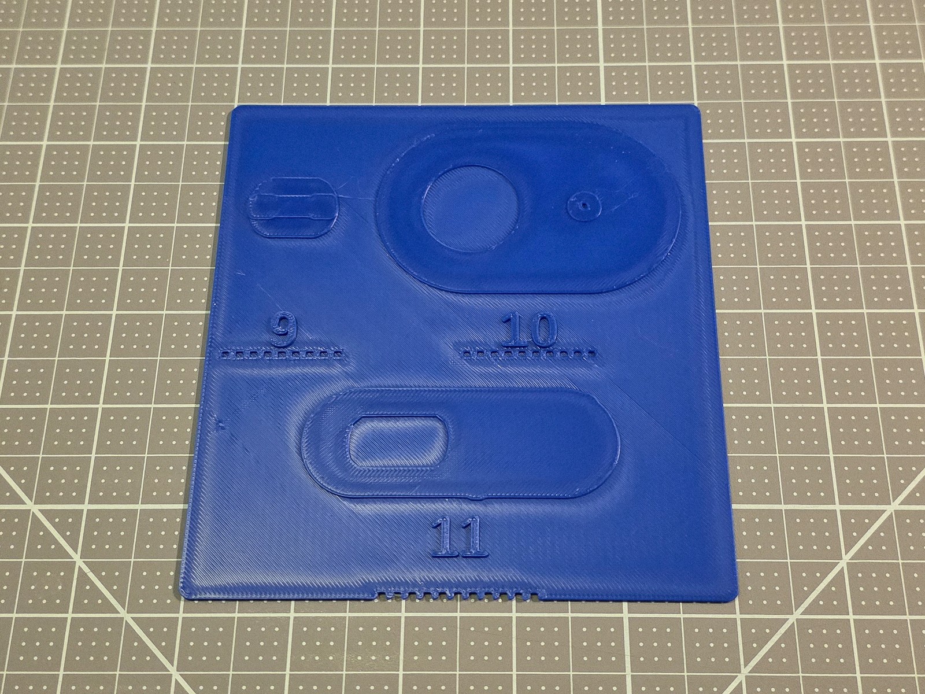
MakerWorld_Photos/Real_Photos/16_tactile_map_9_to_11.jpg
