BrennenJohnston/custom-braille-embosser-v2/MakerWorld_Photos/Real_Photos/17_tactile_map_12_and_13.jpg

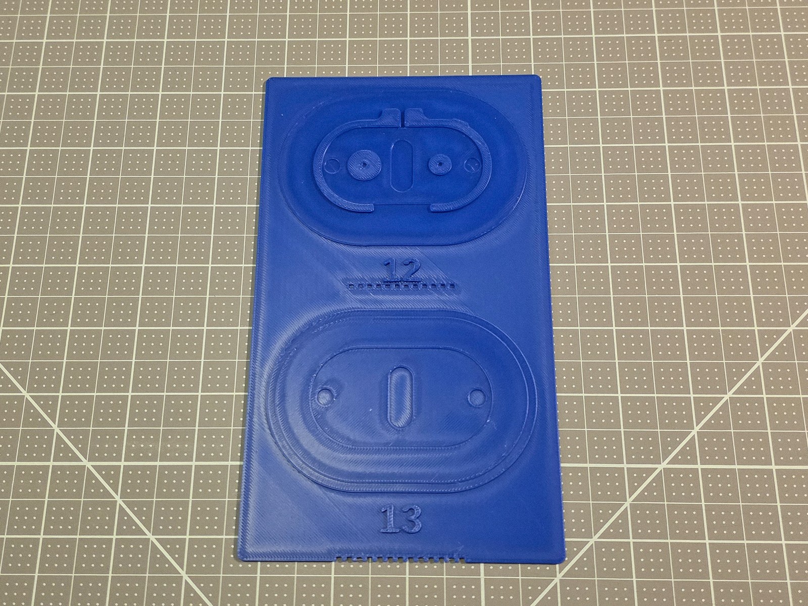
MakerWorld_Photos/Real_Photos/17_tactile_map_12_and_13.jpg
