BrennenJohnston/custom-braille-embosser-v2/(commit log)

2026-10-19 Custom Braille Embosser, Version 2: the public repository
    Nine printed parts and the generated cylinder pair; the seven step-numbered
    guides as Markdown and tagged PDF; the tactile assembly map with its key; the
    Device Summary, Design Rationale and bill of materials; the OpenSCAD cylinder
    generator copied from release v2.12.0 with the two MakerWorld customizer
    files; the sliced X1C projects; the rendered assembly animation; the
    MakerWorld listing with its pictures; and the scripts and tests that build
    and check all of it.
    [Base.stl, Bottom_Gear_A.stl, Bottom_Gear_B.stl, Braille_Cylinder_STL_Generator_EmbosserV2.scad, Braille_Cylinder_STL_Generator_MakerWorld_v2.scad, Braille_Cylinder_STL_Generator_MakerWorld_v2_Fixed_Gears.scad, Braille_Embosser_V2_Assembled_Example.stl, Custom_Braille_Embosser_V2_Assembly_X1C.3mf]
2026-11-07 Update the Tactile Assembly Map print profile to the October 27 save
    [Custom_Braille_Embosser_V2_Tactile_Assembly_Map_X1C.3mf]
